cpfbx/OpenNPU-Lite-FPGA/report/evidence/e02.md

# D006-2 K-major 实板验证报告

验证日期：2026-09-20（主机执行记录）  
板卡：PYNQ-Z2 / `ftdi-1234-tulB`  
镜像：`pynq-z2-v3.1.1`  
BIT SHA-256：`a2c87f4599cdc6057e0251c9fb08daa147107166677f6592418499f1287bdc5e`  
Build ID：`0x2026d006`；Capabilities：`0x0008007e`  
硬件源提交：`f9f775aa0195f063624a73743d0af456d63773c0`  
上板软件提交：`70d9ebfe62c5571b5c56ce3a9c00e8b584f53d3b`

## 结论

D006-2 的定义门全部通过，可作为 D006 K-major 稳定候选版本。K-major 不是只在一个固定矩阵上工作的演示：MODE 5（INT32）和 MODE 6（融合 INT8）均经过尾块、随机、512³ 对拍和 30 分钟混合形状长稳。

## 验证结果

| 层级 | 结果 | 证据 |
|---|---:|---|
| RTL 完整回归 | 21 个 testbench，5966/5966 通过 | `sim/logs/`、`sim/run_regression.ps1` |
| Python 单元测试 | 126/126 通过 | `python/test_*.py` |
| Synth 辅助测试 | 4/4 通过 | `synth/test_*.py` |
| MODE 5/6 尾块门 | 各 20/20；独立 row-major oracle 零错 | `board_d006_mode5_tail_20.json`、`board_d006_mode6_tail_20.json` |
| MODE 5 随机门 | 1000/1000，4000 jobs，零错 | `board_d006_mode5_tail_random_1000.json` |
| 512³ 公平 A/B | 20/20，双方零错 | `board_d006_mode3_512_baseline_20seeds.json`、`board_d006_mode5_512_ab_20seeds.json` |
| 60 秒烟测 | 60.030 s，914 cases，零错 | `validation_d006_k_major_soak_60s.json` |
| 30 分钟长稳 | 1800.246 s，32466 cases，零错 | `validation_d006_k_major_soak_30min.json` |
| 120 样本 KWS | baseline/fused 均 107/120；预测变化 0；全部 Tile 精确 | `validation_d006_kws_fused_ab.json` |
| 故障注入恢复 | 错误 `0x07` → 软复位 → 4 Tile 精确 GEMM | `validation_d006_recovery.json` |

30 分钟长稳的 32466 个 case 在 MODE 5/6 间轮换，覆盖 `15×13×17`、`31×16×7`、`64×64×64`、`128×64×128`、`64×128×64`、`127×95×63`、`256×256×64`，并完成两次 `512×512×512` 压力插入。错误、超时、恢复、契约失败均为 0；两个模式的 input stall ratio 均为 0；所有 checkpoint 的 CMA 输入/输出物理地址保持不变；每个 case 的 phase accounting delta 均为 0。

## 性能 A/B

比较条件为同板、同 BIT、同种子、同 `BM/BN/BK=64`、同输入输出字节数和同非接收阶段，仅改变 row-major / K-major 布局：

| 指标 | row-major MODE 3 | K-major MODE 5 | 变化 |
|---|---:|---:|---:|
| 512³ 平均墙钟 | 106.6868 ms | **63.9716 ms** | **1.6677×** |
| 有效吞吐 | 1.2581 GMAC/s | **2.0981 GMAC/s** | +66.8% |
| receive cycles / 矩阵 | 4,790,400 | **530,560** | **9.029× 降低** |
| input/output stall | 0 / 0 | 0 / 0 | 无 stall |

K-major 的 receive phase 从 47.904 ms 降到 5.3056 ms，节省 42.5984 ms；clear、array、store、drain、transition 五个非接收阶段逐周期相同。因此这是一项受控的输入布局/接收路径改进，不把其他微架构变化冒充成收益。把 MODE 5 与旧 legacy MODE 1 比较得到的 2.7368×只作为跨模式参考，不能替代上面的公平 1.6677×主结论。

当前 8×8、100 MHz 阵列峰值为 6.4 GMAC/s（按 1 MAC=1 操作计），K-major 墙钟利用率约 32.8%；PL 计数器吞吐为 2.1294 GMAC/s。这里不宣称功耗、能效或跨板性能。

## 应用兼容性与恢复

同一 D006 BIT 在固定 120 条、12 类平衡 KWS 集上完成 baseline/fused 受控 A/B。两条路径均为 `107/120`（`89.17%`），预测变化为 0，所有 Tile 分别与独立 NumPy 黄金模型精确一致。融合路径把输出流量从 `1,572,480 B` 降至 `397,440 B`（`3.9565×`），输入流量增加 `2.93%`；冻结的 accounted inference 口径从 `8.471 ms/样本` 降至 `6.554 ms/样本`，改善 `22.63%`。该口径明确排除 MFCC、Python 编排、打包和黄金检查，因此不得改写成完整 WAV 端到端提速；融合路径 PL total 周期反而增加 `11.17%`，必须一并披露。

恢复测试向 D006 核注入不支持模式 `0x0`，硬件进入 ERROR、返回预期错误码 `0x07`；软复位后状态回到 IDLE、错误码清零，随后 `15×13×17` 随机 GEMM 的 4 个 Tile 和整矩阵均精确。恢复原始记录与机器裁决分别为 `metrics/board_gemm_d006_recovery.json` 和 `metrics/validation_d006_recovery.json`。

## 资源与时序

完整 overlay 报告：LUT 17935/53200（33.71%）、FF 18702/106400（17.58%）、BRAM 7/140（5.00%）、DSP 72/220（32.73%）；100 MHz setup WNS `+0.010 ns`、hold WHS `+0.029 ns`，无 failing endpoint。

时序余量极小。后续微流水、驻留或更大阵列必须建立独立分支，逐步完成随机正确性和完整实现时序后才可替换；D006 K-major 当前 BIT 保留为可回退候选。

## 证据边界

- 通过结果证明的是一块已识别 PYNQ-Z2、一个已核对 SHA 的 BIT 上的 MODE 5/6 有界稳定性；不证明功耗、热行为、跨板复现或其他平台。
- D006 BIT 上的 KWS 与恢复均已补跑并归档，但尚未完成外置功率计能耗实测、第二块物理板复现和陌生人 clean-clone 复现；这些边界不得用模型推算或旧版本证据替代。
- 板端 RTC 未校时，长稳 JSON 的 `started_utc/finished_utc` 显示为 `2026-09-11`；主机执行目录、下载时间、BIT SHA、board serial、Build ID 和独立校验结果才是本轮身份依据。后续板测应先记录主机 UTC 与板端 UTC 的偏差。

原始 JSON 不删改，机器校验 JSON 与 SHA-256 清单一并提交。审查时应以 `metrics/validation_d006_k_major_performance.json` 和 `metrics/validation_d006_k_major_soak_30min.json` 的 `passed=true` 为门判定依据。

最终总关闭裁决 `metrics/validation_d006_closure.json` 为 `7/7` 门全部通过；它同时核对六份原始板测属于同一物理板、PYNQ 镜像、BIT、Build ID 与 capabilities，并连接性能、长稳、KWS 和恢复四个独立子裁决。该总裁决不扩大各子证据的声明边界。
