cpfbx/OpenNPU-Lite-FPGA/report/evidence/e04.md

# D007-P hold-margin BIT: 20 paired 512³ runs

Status: the paired performance and exactness gate passed; this is **not**
candidate promotion. Recovery, mixed-shape stability and KWS regression remain
separate board gates.

## Immutable evidence identity

- Hardware source commit: `211ed37ec016a8c16a5da97b2882cf90187125cc`.
- BIT SHA-256: `93316244d1d606211459d9fd36d4f59e5a5f5e584e178ab62c9b05fcf4de2aef`.
- Build ID: `0x2026d074`; original-clock routed setup WNS `+0.246 ns`, hold WHS `+0.023 ns`.
- Board: `ftdi-1234-tulB`, image `pynq-z2-v3.1.1`.
- Board JSON: `.board-work/d007_p_margin_board_20260925_raw/board_d007_p_margin_512_20.json`.
- Board/local JSON SHA-256: `1452a69236afef2ef36db105ceec3502046bc661f16335aad47d85bdaf6c0583`.
- Validation JSON: `.board-work/d007_p_margin_board_20260925_raw/validation_d007_p_margin_512_20.json`.

## Same-BIT comparison

Both modes used 20 alternating-order paired `512×512×512` random inputs and
the same BIT. Each output was checked against the independent NumPy oracle.

| Metric | MODE 9 baseline | MODE 10 panel prefetch |
| --- | ---: | ---: |
| Paired DMA+PL mean per matrix | 40.782602 ms | 36.230547 ms |
| PL cycles per matrix | 3,977,664 | 3,518,464 |
| DMA+PL throughput | 3.2911 GMAC/s | 3.7045 GMAC/s |
| Effective MACs across 20 runs | 2,684,354,560 | 2,684,354,560 |
| Load/array work overlap across 20 runs | 0 | 9,076,480 cycles |

Paired mean improvement: `4.552055 ms`, or `1.125641×` speedup. The
candidate saved exactly `459,200 PL cycles/matrix` in this workload. The
machine adjudicator passed all 15 gates, including alternating order,
same work, counter conservation and overlap attribution.

The throughput above uses the paired DMA+PL window. It is neither a KWS
end-to-end speedup nor an energy measurement. The frozen A2 BIT remains the
rollback version until recovery, smoke, 30-minute soak and KWS checks pass on
this exact P BIT.
