cpfbx/OpenNPU-Lite-FPGA/report/evidence/e15.md

# KWS 单次实板非音频原件核对与交接

2026-10-18。人类负责人/唯一实板操作者：bx；本地离线核对：Codex/root。此报告是对 bx 运行原件的本地一致性核对，不是新增独立实现审查、私有音频推理复算或性能晋升。

## 结论

该次工程功能链记录闭合：固定 left、1500..2500 ms、预期 yes；录音实际退出 0，HID 恢复；ARM NativeVad 已进入实板运行路径；一次推理、同输入 CPU/FPGA 记录的 12 个 logits 完全相同；门控拒绝、零虚拟反馈；外层实际 wait 退出 0、进程组消失、规范锁原 inode 释放和终态清理均有一致回执。

分类结果仍是 **yes → off，错误**。这是单次功能诊断，不是识别质量/可部署拒识/连续监听/实板停止注入/能量验收。没有新矩阵数值不一致证据，也不能据此排除共享前处理、模型或录音窗口问题。

## 原件身份与保存

- 输入：`C:/Users/BXstudywork/Downloads/kws_single_no_audio_20261018T140358_768.tar.gz`。
- 本地大小 27,897 B；SHA256 `661ae0fdb33a3de12b72a2d025ded8d7884d3f466aad18132e193df3d8fa2dc2`，核对前后相同。用户未提供板端归档 SHA，**未完成板端与本地的归档散列比较**。
- 23 个普通 JSON/log 成员，无音频；根为 `kws_single_evidence_r_qa2rc2`。归档路径/成员类型/解压预算及 JSON 重复键/非有限值均检查；不执行日志内容。
- 板端证据路径 `/home/xilinx/jupyter_notebooks/kws_single_evidence_r_qa2rc2`；session `43a7bcf595af7b7ebf3e050644529993`。
- 外层包身份 `cfcad342b1f75acc189913a3f2b3f35636a2ebc378f6a3da9cf78fb62220bc26`；内层 `3ba8fff5832cb9a76a05404351af874dfc7da64eb4d67bef54df2a15bcf06a8a`；与本地冻结 release_01 字节清单重新核对一致。package_sha256 字段是包内清单身份，不是外层 ZIP 散列。
- 原始成员逐字节另存 [board_readback_02/raw](board_readback_02/raw)，附 [成员散列清单](board_readback_02/member_manifest.json)、[结构化核对结果](board_readback_02/readback.json)。本地副本不含原音；勿将原音补进公开包。

## 实际复核

58 项选定元数据一致性检查通过。它们不是重新运行需要 WAV 的完整 outer validator。

1. launch/ack/ready/complete 的 session、PID 1986/2012、固定启动 argv、内外层身份与配置 SHA 一致。配置 SHA 为 `ced3f31016ad567a193537b4676e2d173deba4868d719e0a574b850f5445d4ae`。
2. complete 中 thin/lifecycle/monitor 三个 SHA 由归档原始字节重算一致；应用 result 与 thin 内 inference_receipt 对象一致。worker 的 actual_exit=null 不冒称退出证明；外层 actual_exit=0 来源 parent Popen.wait。
3. 录音/转换/截窗/输入 SHA 元数据一致；单次录音 80,000 双声道帧，固定左声道截 16,000 帧。不重新搜索有利窗口。旧字段 manual_selection_seconds 是历史组件字段，不能解释为本次人为事后选窗。
4. 记录的 VAD 50 帧中 49 帧有声，最长连续 43 帧；由 flags 重算聚合一致。这不是原始音频重新 VAD 的结果。
5. 记录的 CPU expected_logits、FPGA logits、pipeline logits 逐值完全相同。模型 SHA `d8fbe41943fe8c350b33b48b420373c0b15ab18c1d0d80d8626b59180c5576b5`。无输入音频，未重新计算 MFCC 或推理；中间 tile 原始 INT32 未提供且 validation_enabled=false，不能称所有中间值独立审计。
6. 用冻结 voice_gate_candidate.py 对**记录的 logits/flags**重算：原始预测 off，score 约 **0.78756959 < 0.95**，唯一拒绝原因 **low_score**，不是 insufficient_voice；动作拒绝、feedback_calls=0、virtual_feedback=[]。softmax 分数不是校准正确率。旧应用 action=虚拟灯关闭只是提议，不是已交付动作。
7. 三层形状 `[49,64,70] / [1,128,128] / [1,12,128]`，237,440 有效 MAC、4 job；用冻结 MODE11 v2 纯标准库合约核对三份记录计数的总周期划分、工作守恒和子集界，均通过。不是新性能实验。
8. lifecycle 报告 cleanup_complete/terminal_verified=true；ID 0x2026D075、capabilities 0x80EFE、error=0、status=5、DMA idle/零错误；monitor joined、callbacks restored。outer 24 项 checks 全真、no stop、零反馈；原锁 dev45826/inode214887。这里只复核记录，未远程重查当前 OS/锁/设备状态。

## 本地校验开发与测试记录

- 新脚本 [readback_no_audio.py](readback_no_audio.py)，只读原归档；输出目录必须不存在，避免覆盖旧结果。
- 首次 audit exit 1：将 Windows/ARM 的 softmax 浮点结果误用完全相等比较，暴露末位差异；失败发生在输出目录创建前，未改原件。未修改原门控/生产验证器/模型 oracle。
- 修正仅针对本地诊断报告：logits 和离散门控字段仍精确比较；两项 score 跨平台重算限 8 binary64 ULP，实际最终各差 `1.1102230246251565e-16`。该口径不用于放宽门限或判断识别正确。
- 第一版 53 检查通过，输出 `board_readback_01` 保留；增补 argv、summary、锁身份、reference 和 workload 后，58 检查通过，输出 `board_readback_02`，实际 exit 0。
- [12 项回归](test_readback_no_audio.py) 最终全部通过，5.669 s，实际 exit 0：含原件、非整数 exit、PID/配置/绑定哈希篡改、重算绑定哈希后的门控原因篡改、反馈/分类通过篡改、重复 JSON 键、NaN、危险归档路径/链接/音频成员及原件未改。
- 可复核命令（仓库根目录，现有 Python 标准库，无新依赖）：

```powershell
python -B -m unittest discover -s .offline-results/KWS-single-shot-board-20261018_01 -p test_readback_no_audio.py -v
python -B .offline-results/KWS-single-shot-board-20261018_01/readback_no_audio.py audit --out .offline-results/KWS-single-shot-board-20261018_01/board_readback_next
```

## 明确保留的边界 / 下一步

- 音频/PCM、原应用哈希 sidecar 未导出；不能本地重新听辨实际发音、重算截窗/MFCC/VAD/模型，不能独立证明硬件物理身份或鉴别所有实板运行事实。现有 JSON SHA 是一致性链，不是签名认证。
- 先前 USB 加载日志归因失败、FAT 未正常卸载警告按 bx 批准原样保留；本包未提供这两类诊断原件，未在本轮另行重验或修复。
- 不重复录音、不换窗、不放宽门限、不重载模块、不做连续监听。停止注入未实测，正式能量仍后置。无需再跑 320。
- 后续可在现有批准离线范围内将该报告加入内部交付索引/答辩事实表，分别列“工程链完成”和“分类/拒识质量未验收”。最终公开白名单、厂商资产许可、默认合并/晋升及新的板测仍由 bx 确认；FPGA-23 异机复现仍属既有负责人，不接管。
- 本轮只有上述本地核对脚本、测试、报告、隔离输出及 current_plan 顶部状态新增；未改冻结源码/驱动/RTL/门限，未提交/推送/发布，未启动板端进程。实际当前板卡状态未读取，是否关机由 bx 决定。
