cpfbx/OpenNPU-Lite-FPGA/report/evidence/e27.md

# E27 研发协作案例与纠错记录

团队将需求、代码实现、测试和结果判断组织为迭代流程，编程模型辅助形成候选代码与分析结果。以下按技术任务、初步方案、审查修订与验证结果记录代表性案例。

## DMA身份检查

任务要求是根据BIT/HWH准确识别AXI DMA，并检查输入资产与调用接口。早期候选使用实例名辅助判断，实例名为axi_dma_fake、声明为not_a_dma的反例暴露误判。团队结合审查结果确定修订范围，模型辅助改为精确MODTYPE/VLNV匹配，并补充HWH-only、CLI参数和路径反例。后续Linux运行90个测试方法，0跳过通过。

## 测试断言修订

一次Linux回归中，程序已正确拒绝软链接，而旧测试仍依赖异常消息中的特定英文词。团队核对源码、退出结果与测试日志，将修订集中于断言和相邻边界，保留原失败作为回归依据。

## 性能分析修订

阶段分析需要区分外层互斥区间与嵌套的传输等待。团队复核计时起止点，确认transfer/wait已包含在chain_total内，随后的图表采用外层阶段加残差呈现，DMA+PL单列为内部细节。该修订保持实测数值不变，避免重复归因。

## Skill形成与验证

团队将精确IP身份、先核原始点积以及明确测量边界提炼为可复用Skill。模型辅助整理检查器与正反例；团队通过审查、程序回归及异机使用评阅检验方法的作用范围。Linux程序验证90个方法且0跳过，另一电脑完成十个既有合成案例，按事前40项标准评阅为40/40，两类结果分别描述程序行为和使用过程。
