cpfbx/OpenNPU-Lite-FPGA/report/evidence/e28.md

# Competition requirements and reference-project study

Research date: 2026-10-20. This report records observations and proposals, not promotion, submission approval or a replacement measurement contract.

## 1. Which competition document applies

The local current source is:

`local_assets/references/downloads/全国大学生嵌入式芯片与系统设计竞赛'2026FPGA赛道选题指南-AMD.pdf`

- 950,952 bytes; SHA256 `c6ad82acd4f7bdcd13bd412e232ed85d05f2a87dd5e2cdd04f9d219f88b569fc`.
- 28 physical pages. Autonomous-topic requirements were read on physical pages 22-25 (printed 19-22), plus the final general instructions on physical page 28.
- `ref/4357c69f4509432c96cddbe5c25d646b.pdf` is the **2025** guide, not the current rule source. It remains historical material; no deletion or replacement was made.
- Third-party online copies are discovery aids, not authority where wording differs from the provided 2026 PDF.

### Formal requirements and recommendations

| Area | What the 2026 guide says | Practical consequence |
| --- | --- | --- |
| Scoring, 3.3.5.5 | Innovation/application 30; performance/resources 20; correctness/completeness 20; LLM collaboration/Skill 15; documentation/reproduction 15 | Do not reduce the entire entry to one throughput number; equally, documentation cannot erase a losing system metric. |
| Engineering, 3.3.5.1 | Sources, verification, synthesis/implementation reports, board runner and actual outputs/reference comparison, reproducible build scripts | Map each requirement to a real file and an execution level. |
| Skill, 3.3.5.2 | `skill/` and usage documentation; applicability, failure conditions, verified effect and origin in failures/observations; reusable by another team | Existing synthetic usage evidence must be described as such, not as cross-board validation or a controlled efficacy experiment. General PYNQ applicability is separately valued, without a numerical bonus specified here. |
| Report, 3.3.5.3 | Problem/prior work; block diagrams; PS/PL partition and interfaces; optimization comparisons; LLM prompts/responses/corrections; Skill derivation; from-zero instructions | The report needs an engineering explanation and figures, not only an audit chronology. |
| Tooling / openness, 3.3.3-3.3.4 | Vivado/Vitis 2026.1 preferred, 2025.2 also mentioned; other versions allowed with reproducibility explanation. Open repository and redistributable licensing strongly requested | Record actual tested versions; do not upgrade a frozen build just to change a version label. Separate license-pending assets. |
| Paths, 3.3.5.4 | Literal naming rule: English lowercase letters, digits, underscores or hyphens; no Chinese or spaces. Directory layout itself is recommended, with a mapping required for alternatives | A directory mapping does not waive the naming rule. The text also exemplifies `README.md`, creating a canonical-uppercase ambiguity to clarify before final export; do not rename frozen evidence or `SKILL.md` blindly. |
| Finals | One-page English PPT poster using the official template, without team information, A4 color print | Prepare later from the actual template; the template itself was not obtained in this study. |

The guide has junior/senior grouping rules. Actual team eligibility/registration group was not confirmed here; it must not be inferred from the board model.

Schedule cross-check: a [Xi'an Jiaotong University notice](https://dice.xjtu.edu.cn/info/1009/3646.htm), dated 2026-09-15, relays submission **2026-11-04 18:00**, finals November 20-22. This is a university relay of the contest announcement, not proof that the submission portal has no later updates. The guide itself defers schedule and latest detailed scoring to the organizer.

**Interpretation, not an extra rule:** the guide does not specify universal victory over the fastest CPU as a qualification gate. It does require actual engineering, meaningful comparisons and reproducibility. Our end-to-end/energy losses must therefore remain visible and explained, not relabeled away.

## 2. Reference selection and identity

These are purposeful references, not a popularity ranking or an exhaustive list of winners. Public repository content was inspected without cloning/building/running it. Current snapshots postdate the award years; current README/script content is not authenticated as the exact award-time submission.

| Project / snapshot | Award evidence | What was actually inspected |
| --- | --- | --- |
| [Ultra-Vision](https://github.com/Floatkyun/Ultra-Vision), `9b3f664d2f9df09b945adcd36c6ca69e09025820` | [Nanjing University notice](https://eelab.nju.edu.cn/xwgg/xwdt/20241219/i306006.html) confirms the named team's Ti60F225 video-scaling project and Efinix enterprise cup in 2024. README also claims national first prize. | README architecture explanations, two buffering/dataflow designs, metrics, demonstration and diagram entry points. |
| [FPGA-ANLU-National-First-Prize](https://github.com/maojinxiang/FPGA-ANLU-National-First-Prize), `df3b509b201a8f4103114d7dc8d78dd16193b10b` | [China University of Petroleum (East China) notice](https://ocean.upc.edu.cn/2025/1215/c15097a479949/page.htm) matches the author/team, Ethernet transmission topic and 2025 national first prize. | README staged integration and operational instructions; selected Python host receiver implementation. No technical-report/PPT content was read. |
| [hlstrack2025_40562](https://github.com/hongpengWu/hlstrack2025_40562), `264bb94cab8b7e10d7874b9b91d28b50f730d8c1` | National first prize is **author-reported in README**; independent award-list matching was not obtained in this study. | PYNQ-Z2 project README, YOLO/UKF subsystem documentation, HLS Tcl and selected C++ testbench. Notebook presence was checked, not executed or fully audited. |

Repository commit identities were read from the GitHub API. They identify source snapshots, not the validity of reported benchmark results.

## 3. Useful practices, and their limits

### 3.1 Ultra-Vision: explain data movement before listing optimizations

Its two designs retain the algorithm but change DDR/FIFO placement and output buffering. The README explains the bandwidth/timing conflict and frame-size synchronization tradeoff, rather than treating ping-pong buffering as an automatic improvement. It also puts architecture, hardware photos and demonstration entry points near the front. [Repository explanation](https://github.com/Floatkyun/Ultra-Vision/blob/9b3f664d2f9df09b945adcd36c6ca69e09025820/README.md).

For OpenNPU: explain why K-major layout, first-K overwrite, prefetch and dual C-Bank overlap remove specific work or stalls; then show measured results for the corresponding BIT identity. Do not add historical savings or multiply their speedups. For host optimization, investigate actual packing/copy/object work before proposing another DMA batching layer that already exists. Do not adopt the reference project's qualitative latency claims as an independently verified metric.

### 3.2 ANLU: build a demonstrable system in stages

The repository exposes incremental control/data/image integration, setup assumptions and an explicit host-side receive path. The selected receiver uses frame/packet identifiers, bounded queuing and stale partial-frame handling. These are concrete integration mechanisms, not proof of general packet-loss tolerance or real-time guarantees. [Project and host source](https://github.com/maojinxiang/FPGA-ANLU-National-First-Prize/tree/df3b509b201a8f4103114d7dc8d78dd16193b10b).

For OpenNPU: a short entry point should show the input identity, selected backend, exact comparison, timing scope and final cleanup/status. Reuse current receipts and logs; no new GUI platform is justified merely for presentation. Demonstrate the matrix service first. Present KWS as a scoped application integration/rejection example unless further approved evidence changes that boundary.

### 3.3 PYNQ-Z2 UKF: connect the kernel to an application, and audit the instructions

The project separates software and hardware notebook routes and includes a MATLAB-reference comparison and scripted HLS flow. This is useful for explaining what PS does, what PL does, and which reproduction route needs a board/toolchain. Its numerical tolerances are application-specific and must not replace our exact INT32 oracle.

There is also a reproducibility warning at the pinned snapshot: README text describes default `CSIM=1`, `CSYNTH=0`, `COSIM=0`, whereas the actual Tcl starts with all of `CSIM`, `CSYNTH`, `COSIM`, `VIVADO_SYN`, `VIVADO_IMPL` set to 1. See the [README](https://github.com/hongpengWu/hlstrack2025_40562/blob/264bb94cab8b7e10d7874b9b91d28b50f730d8c1/README.md) and [Tcl](https://github.com/hongpengWu/hlstrack2025_40562/blob/264bb94cab8b7e10d7874b9b91d28b50f730d8c1/yolo_ukf_track/src/kernel/run_hls.tcl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). No script was executed here. An award claim does not remove the need to verify actual execution flags.

### Reuse restrictions

Ultra-Vision reports MIT and the UKF repository Apache-2.0, with third-party attributions also requiring attention. No explicit root license was found for the ANLU repository in this inspection (GitHub API license was null); this is an unresolved reuse boundary, not permission to copy. No third-party code, image or poster was imported into OpenNPU. Ideas can inform our independently produced explanation, with attribution.

## 4. Recommendations for our next steps

These are proposed priorities, not authorization for new board work or publication.

1. **Finish the real matrix off-machine reproduction handoff first.** V's separate-computer AI-assisted Skill exercise is useful usage evidence, but is not the matrix package's 191-test reproduction. Keep the two records separate. Provide fixed hashes, environment requirements, commands, exit-code collection and a post-test identity check. Separate PC verification, source rebuild, board functionality and controlled measurement as four different levels.
2. **Make the contribution legible.** Present a reproducible INT8 compute platform, measured dataflow/host tradeoffs and reusable validation practices. The core claim is not a universally faster/lower-energy replacement for dual-core ARM. Retain the bounded source-diagnostic window rather than launching an unproved rewrite.
3. **Produce a small set of evidence-backed figures.** PS/PL dataflow and interface; hardware evolution with distinct BIT identities; a nested timing diagram with unassigned overhead retained; same-session backend comparison; nominal ABBA envelope power/time/energy. A DMA+PL subwindow must not be added twice or compared with a CPU complete request as an end-to-end speedup.
4. **Make the demo short and truthful.** Existing golden inputs, exact outputs, conservation counters and lifecycle status are the primary engineering demonstration. The one live KWS misclassification rejected by the gate is one rejection case, not successful classification or a deployment-quality evaluation. No extra run or relaxed threshold is implied by this proposal.
5. **Create a derived submission tree only after decisions.** Map guide requirements to the final source/build/board/data/skill/report material; distinguish current candidates from frozen historical packages. Resolve naming, third-party/IP/model licensing, private-path redaction and the real poster template before public export. Preserve all frozen originals.

## 5. Current gaps this study does not close

- No independent performance reproduction of these reference repositories, no exhaustive review and no causal proof of why judges awarded them.
- No confirmation of our registration group, latest submission-portal changes or canonical-uppercase filename exception.
- No new matrix optimization result, calibrated task-energy result, KWS accuracy improvement, cross-board Skill reuse or matrix off-machine test receipt.
- No change to the measured conclusion: our FPGA saved-envelope mean power was lower than ARM 2t, but its measured nominal envelope duration and cumulative joules were higher. This is not repaired by changing presentation.
- No score or award guarantee. The useful lesson is to pair a focused engineering contribution with understandable architecture, real comparisons and an executable reproduction path.

## 6. Read-only verification and handoff

The 2026 guide's submission and scoring pages were rendered and visually checked. Public award notices, current repository identities and selected source boundaries were checked. Existing tracked modifications were not edited. Only this research directory and isolated PDF render images were added; no board, build, installation, Git commit/push or external coordination occurred.

Recommended immediate continuation: prepare the matrix off-machine reproduction handoff for the participant, then apply these findings to the report/figure plan. No further repository browsing is needed before that handoff.
