cpfbx/OpenNPU-Lite-FPGA/report/figures/fig01_architecture.pdf

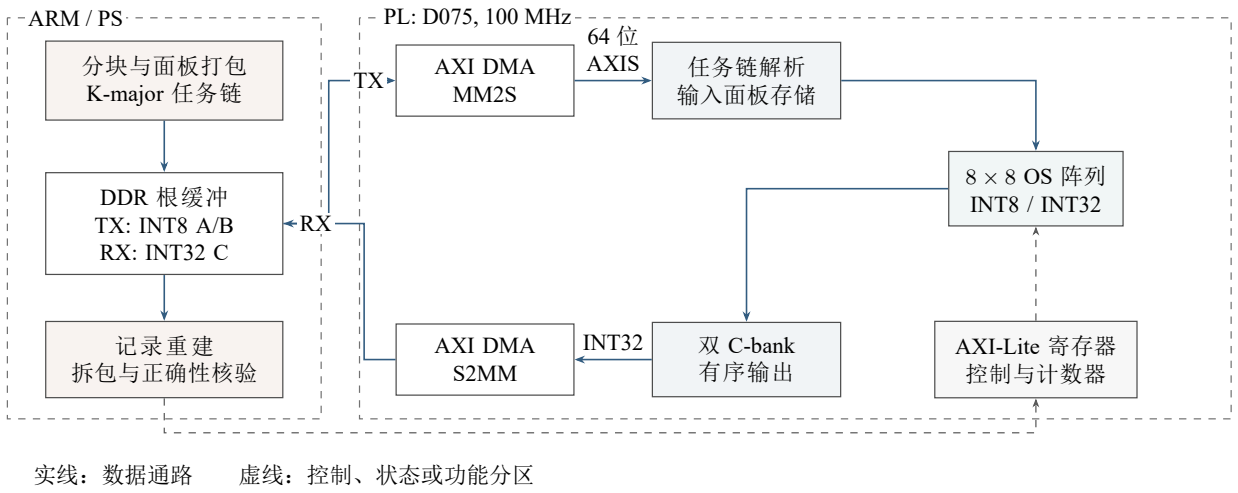
[picture p20: figure]
ARM / PS; PL: D075, 100 MHz; 分块与面板打包 K-major 任务链; DDR 根缓冲 TX: INT8 A/B RX: INT32 C; 记录重建 拆包与正确性核验; AXI DMA MM2S; 任务链解析 输入面板存储; 8 × 8 OS 阵列 INT8 / INT32; 双 C-bank 有序输出; AXI DMA S2MM; AXI-Lite 寄存器 控制与计数器; 64 位 AXIS; INT32; 实线：数据通路; 虚线：控制、状态或功能分区
