cpfbx/OpenNPU-Lite-FPGA/report/figures/fig08_kws_graph.pdf

(a) 完整计算图：本轮 PC 离线固定 12 窗

公共 WAV 前端
CPU Op0–Op1

共享中段接口
Op2 → DW3 → Op4

CPU Op5–Op11
12 个 INT8 logits
X23 | X26
(b) 另一组 ARM/PL 实板固定 12 窗：单个共享资源会话

ARM 后处理：零点校正与重定量化；X23..26 均为 1 × 25 × 5 × 64 INT8.

24 次 Pointwise 调用、48 个 job、12 次 ARM DW3；后层消费前层实际输出。

(c) 完整 PC 图的 CPU 后缀与决策

DW：逐通道卷积；PW：逐点卷积；FC：全连接。候选止于 Op11，未执行 Op12 Softmax。
