cpfbx/OpenNPU-Lite-FPGA/sim/readme.md

# RTL仿真入口

源码及执行脚本位于d075/；环境与重放步骤见根目录reproduction_guide.md。

## 先查看现有结果

[2026-10-30原生仿真日志、退出码与波形数据库](results/native_20261030/readme.md)。在运行回归前，可直接核对原有结果。
