cpfbx/OpenNPU-Lite-FPGA/report/evidence/readme.md

# 技术证据导航

E01–E43及同编号补充文件是各阶段保留的技术记录。文件中的历史时间、失败、负结果和版本说明保持原样。部分原文相对链接指向当时工作目录；它们用于定位历史上下文，当前公开工程请从下表进入。

| 查什么 | 当前入口 |
|---|---|
| 按阶段理解全部成果 | [研发结果总览](../development_results.md) |
| E编号与来源文件身份 | [技术来源索引](../technical_source_index.csv) |
| 原始资源、时序与完整构建 | [构建目录](../../build/readme.md) |
| 实际BIT/HWH、矩阵及共享链返回原件 | [板端目录](../../board/readme.md)、[资产尺寸及SHA](../../provenance/delivery_artifacts.json) |
| 本次公开运行截图 | [E42](e42.md)、[帧来源索引](../run_source_index.json) |
| 完整图离线执行与模型输入 | [复现指南](../../reproduction_guide.md)、[数据目录](../../data) |
| 提示词、模型答复与纠错 | [技术交互](../collaboration_interactions.md) |
| 完整设计报告 | [设计报告](../design_report.pdf) |

公开工程并未包含历史工作树的每个临时目录。来源索引列明出处，不表示原文中每个历史相对路径都已成为当前仓库附件。随附运行包、原件和当前入口由工程根manifest统一核验；完整历史资料仍按原版本保全。
