cpfbx/OpenNPU-Lite-FPGA/report/native_assets/readme.md

# 原生工程图件

本目录保留报告使用的Vivado原生截图与原生SVG/PDF。正文裁切用于排版，原图文件保留完整。仿真WDB、测试台与复现入口随配套工程提供。PE乘法器连接局部采用完整矢量文件供放大查看。
