cpfbx/OpenNPU-Lite-FPGA/report/evidence/e01.md

# 第1项工程签核补齐：执行记录

负责人bx；执行Codex /root。用户本轮决定保留第2项进度，先完成第1项。
不改RTL/XDC/协议/门限/生产默认，不部署新BIT，不操作板子，不提交或推送。
第2项293.226ms矩阵候选及全部原件保持不动，暂停追加性能实验。

## 最新状态：第1项工程核查与干净重建已完成

2026-10-13 14:34:33（北京时间）：原构建脚本完整综合/放置/布线/布线后优化/写BIT/导出XSA-HWH/finalizer结束，执行器session36546实际退出0。耗时20分46.76秒。
此前下方“进行中/尚待完成”为过程检查点；最终结果以本节和completed_audit_04.json为准。

| 本次验收对象 | 最终事实 |
|---|---|
| 冻结源码与依赖 | 独立干净clone，47输入字节相同；原板卡ZIP SHA验证通过，新venv，不复用旧IP/DCP构建输出 |
| 工程与检查点加载 | 原xpr实际read-only打开，原最终DCP副本实际加载；原xpr及DCP/BIT未改 |
| 物理架构 | 网表一份shared/tile/PE阵列；64PE DSP＋7量化DSP＋1计数DSP=72 |
| 新完整实现自然时序 | WNS+0.118ns/TNS0，WHS+0.066ns/THS0；setup/hold/pulse失败端点0，12类check_timing全0 |
| 新时序/资源报表 | 去除前12行工具/日期/路径头后，正文与历史报表逐行完全相同；LUT26762、FF27575、BRAM11、DSP72 |
| 新BIT | 整文件SHA不同，仅头c/d日期与时间不同；配置载荷4,045,564B与历史逐字节一致 |
| 新HWH/XSA | HWH仅根TIMESTAMP变化，全部其余XML相同；新XSA内BIT配置与导出BIT一致 |
| 方法学核查 | 152 TIMING-46全部逐路径验证10ns setup/0ns hold；报告保留2865方法学/204DRC条目，不豁免、不改成零告警 |
| 生产与板卡 | 未部署新BIT，不改原默认，无本轮板测/OS/权限/网络操作；第2项包与原件SHA复核不变 |

这是现有PYNQ PL overlay的工程交付核查/重建完成，不是新硬件晋升、DDR电气/启动镜像签核或全工作流零Critical Warning。
构建日志仍有PSU-1/2/3/4四类DDR负值Critical Warning，各出现3次。值-0.051/-0.006/-0.009/-0.033与固定厂商preset及历史BD/HWH一致；原样保留，不擅改PS参数，不宣称因此证明任意DDR/FSBL/BOOT用途安全。
历史DRC中4条DMA IP WRITE_FIRST RAM Advisory也明确保留。本轮没有新增设计、没有接受新的性能退化，不为清零告警改RTL或IP。

核心产物身份：

- 新BIT SHA d913b3b3fe676c49ac432131b1ef285e8b1cf8724d6eaeab30d2bfafc5ebeb11；原板测BIT仍47ae0a3640ef6d31db467118fd1822c04d465cd31171275fc04824824a20451c。
- 二者配置载荷SHA f9b9c1e63d735d66df3f43d15f3e2202c11568a54277ef0b23ea1213c9440361。
- 新postroute DCP SHA b59acdc06e2ea4c852201e528c83b251343058531b00fdcd667ffa7efadd5e3d。
- 新artifact identity SHA f360ab234cda54dc8e2f1e93eaf933ad52b8fdabeba4c981d3af2577469061af，关联47输入身份与六产物；completed_audit_04另绑定DCP/XPR，未倒填历史DCP身份。
- actual executor exit0依据本聊天tools.write_stdin真实返回；executor_completion_metadata_excerpt.json保存metadata摘录，明确非服务签名/非完整stdout。build_completed.json中的planned码不单独充当实际退出证明。
- 最终11项审计专项测试exit0，0failure/error/skip，audit_tests_06.log；此前失败和旧JSON不覆盖。最终审计对BIT配置和HWH时间戳替换使用实际bytes比较，而不只比较SHA。

独立审查：/root/matrix_attribution_increment_review已只读审查并复算通过，未参与实现、未操作Vivado/板或改原件。其独立核查47输入、旧产物、DCP、BIT/HWH/XSA差异、报告正文、152条DESCRIPTION与TSV端点、DSP64+7+1、自然时序及11测试，结论为本范围无新增阻塞，可收尾“冻结矩阵overlay工程可重建/自然时序闭合/告警分类”。actualexit证据为主会话真实工具metadata转录和成功日志交叉佐证，不冒充审查者直接捕获原OS退出。审查复算的03与最终04 JSON逐字节相同，SHA b13aaec078059ddc0edf58c43efdc43b88a8f8b4901d503b17c8a788152d3af9。

新可打开工程：
`D:/Work/CodexProjects/Active/fpga/.board-work/matrix-signoff-rebuild-20261013/.board-work/full_overlay/vivado_gemm_accelerator/opennpu_gemm_accelerator.xpr`

干净重建方法已实际验证：全新clone指定35d4db6，准备stdlib Python venv和固定SHA板卡定义，使用原`synth/run_gemm_overlay_build.ps1 -ArraySize 8 -Mode11Experiment`。`OPENNPU_BUILD_OUTPUT_ROOT`必须为该clone内不存在的新目录；原Tcl含create_project -force，绝不能指向当前或历史已完成目录。当前run_clean_rebuild.ps1单次claim防止误重跑；不要删claim绕过。
GitHub迁移快照与历史对象不同的既有边界不变：本次复现为本地新clone指定历史commit，不冒充其他电脑已从新GitHub仓库复现；团队第三方复现归第5项。

下一步：第2项进度继续保留为诊断候选；是否恢复多输入/多形状正式性能合同由bx决定。本轮不自动追加板测、提交/推送或更改Linear状态。

## 历史过程检查点（以下进行中状态已被上述最终结果取代）

证据根：D:/Work/CodexProjects/Active/fpga/.offline-results/matrix-signoff-20261013_01/。
新干净clone：D:/Work/CodexProjects/Active/fpga/.board-work/matrix-signoff-rebuild-20261013/。
分支codex/matrix-signoff-rebuild-20261013，commit35d4db623091dfc7a63459d07f04e4484dbbd999；47份冻结输入逐字节一致，git status clean。
新Python venv仅供stdlib构建finalizer使用，未安装推理依赖；固定SHA板卡ZIP复制后由原fetch脚本验证并解压，没有借用旧生成IP或构建输出。
运行原synth/run_gemm_overlay_build.ps1 -ArraySize 8 -Mode11Experiment，输出新clone的.board-work/full_overlay。原47输入未改，原4并行job策略未改。
父执行器session36546，Vivado主进程130784；状态以build_completed.json、实际executor退出及日志为准，不凭此静态记录推断完成。

## 已完成的实际工具核查

Vivado MCP会话vivado-20261013-140730-3cf0e78e，以Tcl模式启动；历史xpr通过open_project -read_only成功打开，报告了原完成的synth/impl runs。
只读项目中IP显示read-only锁定；module reference显示unresolved，不能据此声称原工程可编辑后直接重建。没有升级IP或保存原项目；新clone重新构造BD已validate通过并进入综合，由完整重建实际验证。
历史DCP按SHA核验后复制到新证据目录，再实际open_checkpoint成功。操作只在会话内存，未write_checkpoint或回写旧DCP。
检查会话已正常停止，完整重建期间不同时保留第二个Vivado审查进程。

网表层级确认：一份shared core、一份axis_tile_gemm_core、一份PE_array；72个DSP中64用于PE阵列、7用于requantize、1用于effective_macs工作计数。不是两套物理阵列。
自然时序重新生成：WNS+0.118/TNS0，WHS+0.066/THS0；setup/hold/pulse失败端点0，12类check_timing均0。
152条TIMING-46逐条绑定实际violation的pin对象并查询max/min路径；全部setup requirement10ns、hold0ns，最小setup slack5.646ns、最小hold slack0.122ns。
自然约束仍按冻结构建同一零hold关系命令恢复；152条工具告警未删除/豁免，不声称方法学零告警，也未修改XDC。

## 保留告警与边界

方法学：DPIR-1=2709（异步复位阻止DSP内部寄存器合并的优化提示）、TIMING-46=152（上述逐路径验证）、RTGT-1=4（bias RAM重映射优化提示）。
DRC：DPIP-1=63、DPOP-1=67、DPOP-2=70，均是DSP流水优化Warning；REQP-165=2与REQP-181=2均为Advisory，全部位于AMD AXI DMA IP内部FIFO的WRITE_FIRST RAM。
本次DRC/methodology报告没有Error/Critical Warning。RAM Advisory仍保留，不假装新增仿真已证明所有地址冲突不可能；不为提示而修改已验证IP/复位/流水语义。
AMD TIMING-46说明要求核对路径实际行为与约束，本次以全部152对实查值补证，不以一个例子泛化：[UG906](https://docs.amd.com/r/en-US/ug906-vivado-design-analysis/TIMING-46-Multicycle-Path-with-Tied-CE-Pins)。

## 新审计工具及验证

只读scripts/audit_matrix_signoff_completion.py：解析全部2865方法学条目与204DRC条目，核对报告总数、152对覆盖、网表计数、输入与构建产物身份；无waiver或生产门限修改。
8项反例/实际原件测试最终exit0，audit_tests_02.log。首次audit_tests_01的1项失败为Windows路径反例注入器只匹配斜线，已修正测试匹配，保留失败日志；未改实际工程输入。
首次historical聚合审计错误假设剩余8个DSP全属量化，已按逐cell网表修为7量化+1工作计数；是审计器推测错误，不是硬件变化。最终historical_audit_02.json成功，未覆盖旧报告。

## 尚待完成

完整干净综合/布局/布线/写BIT与finalizer；核对新自然时序、资源、产物与历史身份。新BIT未通过本轮板测，不能自动替换历史板测BIT。
构建开始曾出现本机物理/虚拟内存余量低，已告知bx且没有关闭他人程序或修改OS；随后余量回升。失败时保留原件，不降低时序门限。
审计source脚本与新文档尚未提交，不自动更新Linear或合并。
