cpfbx/OpenNPU-Lite-FPGA/report/evidence/e05.md

# D075/MODE11 本轮板测收尾与跨 BIT 回归裁决

## 结论

**本轮计划中的板测已全部完成，原始证据已取回并独立复算。** 新完成 D074/D075
跨 BIT 的 GEMM 与普通/融合 KWS；此前 MODE11 预检、随机、恢复、烟测、30 分钟
混合长稳、旧模式兼容和无重载直切均有独立报告，不重复跑。当前没有安排新的长稳。

23 项本地身份/计数/配对一致性检查通过，**不等于“所有性能无退化”或自动晋升**。
保留冻结 D074 稳定版；D075 已具备本轮完整板测证据，等待独立晋升审查和团队对
下述小幅旧路径差异的裁决。未创建晋升 tag，未替换稳定 BIT。

## 1. 超时处置与执行边界

v1 外层看门狗 300 秒在第 9/16 个 GEMM 子运行中止。原前 8 个尾块 JSON/日志、
第 9 项空日志和父日志完整保留，没有与新场次拼接。stdout 缓冲使旧失败子日志为空，
因此不能断言被中止时具体停在哪一行，也不能仅凭异常排除所有独立故障。
冻结 D074 以往同规模 20 次整段耗时 558 秒，足以证明 300 秒交付阈值不合理。

v2 源 `880f61d`：仅将**整段子任务**看门狗改为 1800 秒、子 Python 加 `-u`，并
保存超时失败旁路。**单次 DMA 超时仍为 60 秒**。未改变硬件、冻结应用、黄金模型、
种子、20 次迭代、ABBA 次序或性能窗口。224 项 Python 测试通过。

用户明确授权“继续完成所有测试”后，通过既有 root Jupyter Terminal 启动隔离 v2
场次，GEMM 成功才进入 KWS；未修改 sudo 策略、密钥、校园网络/Clash。
新目录只为本次监测可读，没有改旧 root 私有证据目录的权限。

- 板端目录：`/home/xilinx/jupyter_notebooks/mode11_crossbit_v2_auto_aGYlB4/`
- 开始/结束：`2026-09-30T13:23:49Z` / `2026-09-30T14:46:49Z`，约 83 分钟。
- GEMM、KWS、session 退出码均 0，32 个子运行全部完成，无子任务失败旁路。
- 83 分钟含 ARM 打包、NumPy oracle 等测试成本，**不是单矩阵加速器延迟**。

## 2. 身份与归档

| 对象 | 固定身份 |
| --- | --- |
| 板卡 / 镜像 | `ftdi-1234-tulB` / `pynq-z2-v3.1.1` |
| 冻结 D074 硬件源 | `211ed37ec016a8c16a5da97b2882cf90187125cc` |
| D074 BIT | `93316244d1d606211459d9fd36d4f59e5a5f5e584e178ab62c9b05fcf4de2aef` |
| 候选 D075 硬件源 | `35d4db623091dfc7a63459d07f04e4484dbbd999` |
| D075 BIT | `47ae0a3640ef6d31db467118fd1822c04d465cd31171275fc04824824a20451c` |
| 两 BIT 共用冻结 host app | `c0ca40fed408a1e84b137bcd7690538c91f568a5` |
| v2 补充 ZIP | `d0d689ec62c66e20f254b70017bb016bca91e4651eb27ce7e74cae8313e2cd4a` |
| 成功原始 tar | `1a08c48279151ad9c1158c2b9f3f7e2715eb3607feb9cc0713a0d208194e8919` |
| 中止 v1 原始 tar | `aeee9de78a85ad2c7d81d1dfa26484ea7f5423ec81722bcfbad375c49a759760` |

两份 tar、启动快照/脚本、本地复算及复算入口均在
`metrics/mode11_crossbit_20260930/`。成功 tar 从板端取回后 SHA 完全一致，成员路径/
类型检查通过后在 `.board-work/mode11_crossbit_20260930_raw/` 独立展开。
复算另外检查 HWH、模型/manifest、交付脚本与包身份、板卡/镜像、原始子 JSON/日志 SHA。
SHA/校验器提供一致性与外部固定输入约束，不是数字签名或“防伪证明”。

## 3. 完成工作量与正确性

| 项目 | 本轮数量 |
| --- | ---: |
| GEMM 子运行 | 16（每段内部 20 个 MODE9/10 配对） |
| GEMM 内部配对 / chain 执行 | 320 / 640 |
| GEMM tile / 有效 MAC | 21,760 / 42,953,728,960 |
| KWS 子运行 | 16（普通/融合、两 BIT、ABBA 两轮） |
| KWS 样本执行 / tile | 1,920 / 7,680 |
| KWS 有效 MAC | 455,884,800 |
| KWS 唯一样本 / 每次正确数 | 120 / 107 |
| 离线身份、计数、配对审计 | 23/23 |

每次 KWS 均 107/120，16 场的逐样本身份/预测与冻结 D074 完全一致；没有新增
硬件分类错误。1920 是同 120 样本的重复执行，不能增加泛化准确率的样本量。
GEMM 应用在板端作 NumPy 精确比对后才保存成功；本次跨 BIT JSON 不保存 GEMM
完整输出 payload，离线只能重算身份/字节/MAC/计数与应用成功记录，不能声称重新
从 payload 对全部 GEMM 算术作独立重演。此前 81 步直切门单独保存了完整输出。

## 4. 跨 BIT 旧路径性能（同 host、同日 ABBA）

GEMM 比较两 BIT 内的**旧 MODE10**，不是 D074 MODE10 对 D075 MODE11。
每组 4 对外层子运行均值，20 次内部 GEMM 或 120 个 KWS 样本不是独立跨 BIT 配对。
GEMM 窗口为 DMA+PL；KWS 窗口为含 oracle 的 validated inference，排除 MFCC/Overlay
加载，不是裸硬件计算或含特征提取的端到端应用。

| 工作负载 | D074 均值 ms | D075 均值 ms | 配对差值 D075−D074 ms |
| --- | ---: | ---: | ---: |
| 尾块 `15×13×65` 旧 MODE10 | 0.746852 | 0.705716 | −0.041135 |
| `512³` 旧 MODE10 | 36.129759 | 36.202669 | **+0.072909** |
| 普通 KWS | 31.893699 | 32.115294 | **+0.221595** |
| 融合 KWS | 41.489047 | 41.180121 | −0.308926 |

原摘要的**配对百分比均值**分别约 −5.27%、+0.20%、+0.70%、−0.74%；它不是上述
两列总体均值之比，不能混用。旧 MODE10 大矩阵和普通 KWS 的 4 对墙钟差值均为正，
必须保留，不能直接宣称统计等价或忽略成噪声；尚未预定义等价界或完成因果分解。
融合 KWS 的 4 对中有一对更慢，均值下降也不能推断所有重复运行都会更快。

## 5. 相位归因：能确认什么、不能确认什么

旧 MODE10 的尾块每链 `2039→2043` 周期，大矩阵每链 `3,518,464→3,518,528` 周期。
仅 `transition` 增加，分别对应 4/64 个输出 tile **各多 1 个控制周期**；receive、clear、
array、store、output、输入/输出等待逐周期不变。大矩阵 PL 差为 64 拍（0.64 µs，
约 +0.00182%），不能与墙钟 +0.072909 ms 混为同一机制或声称完全无退化。

普通 KWS 每样本 PL 均值增加 `2526.49375` 拍：receive/input_stall 增加
`2522.49375`，transition 增加 4，其余工作相位不变。input_stall 是 receive 的子集，
**不再相加**。约 +0.025265 ms PL 只解释墙钟 +0.221595 ms 的部分；剩余约
+0.196330 ms 在 PL 窗口外，原因未证实。输入等待增加的具体来源也未证实。

融合 KWS 每样本 PL 均值增加约 `91.785417` 拍（+0.000918 ms），同样为 receive/
input_stall 的约 87.785417 拍与 transition 4 拍，其余工作相位不变。墙钟均值下降
不等于 PL 更快。现有证据不能把差异全部归给 Python、DDR、DMA 或温度中的某一项。

## 6. MODE11 主优化成果与性能口径

MODE11 性能来自**此前同 BIT MODE10/11 的 20 次配对**，不从本次旧路径跨 BIT 摘要
外推：DMA+PL `36.221124→31.261776 ms`，同 BIT 配对加速 `1.158639×`；MODE11
DMA+PL 吞吐 **4.293349 GMAC/s**。纯 PL `3,004,483` 拍、`30.044830 ms`，吞吐
**4.467249 GMAC/s**。两者窗口不同，不能把后者写成墙钟吞吐；均值 4.293 也不应
写成严格“超过 4.3”。20 次中 33.918 ms 的离群墙钟保留，没有挑删。

此前混合长稳 `1800.008108 s / 8302` 对，每模式 36,882 任务、16 对 `512³`，通过；
旧模式兼容/81 步不重载直切通过。D075 完整 100 MHz setup/hold `+0.118/+0.066 ns`，
72 DSP、11 BRAM、26,762 LUT、27,575 FF。仍是单物理核，不能宣称 DSP 减半。

对应报告：

- `docs/d007_mode11_board_preflight_review_2026-09-30.md`
- `docs/d007_mode11_soak_review_2026-09-30.md`
- `docs/d007_mode11_kws_review_2026-09-30.md`
- `docs/d007_mode11_legacy_compat_review_2026-09-30.md`
- `docs/d007_mode11_advanced_compat_and_handoff_2026-09-30.md`
- `docs/d007_mode11_handoff_review_2026-09-30.md`

## 7. 独立审查任务与下一步

1. 离线重放本目录 `review_crossbit.py`，核实 23 门及两包 SHA、身份链、原始记录；
   判断它没有把成功一致性门当作防伪/性能无退化门。
2. 审查跨 BIT ABBA 的配对单位、4 对均值/极差、窗口边界及旧路径 +0.20%/
   普通 KWS +0.70%：是否可接受须明确裁决，不能事后修改阈值为“全通过”。
3. 核查旧路径 `transition +1/tile` 和 KWS receive/input_stall 增量；确认尚未完全归因，
   不用“主优化更快”掩盖旧路径的确定控制开销与实测墙钟差异。
4. 将本轮与此前随机/恢复/长稳/直切/普通融合 KWS 证据缝合，决定 D075 是否晋升。
   当前保留 D074，不自动更改稳定标签或 RTL。
5. 团队提交下一轮建议后，再据冻结证据讨论优化路线。功耗/能耗、ARM 基线属于
   后续独立工作包，本轮没有测量，不能报 GMAC/J 或声称能耗改善。

本轮板测到此收尾：原始证据留板并有本地副本，不删除中止场次，不再追加测试。
该完成范围是当前 MODE11 候选约定的板测门，不是所有未来研究任务已经完成。
