cpfbx/OpenNPU-Lite-FPGA/report/evidence/e06.md

# 第2项：多输入矩阵完整调用确认结果

本轮483调用受控诊断已由bx实板完成，完整原件取回，Codex /root用冻结入口本地独立重放通过。256³及512³完整调用胜过本场ARM NumPy FP32，所有小形状仍由ARM占优。生产默认未改变，未晋升。

负责人/实板操作者：bx；离线实现及原件复算：Codex /root。base `35d4db623091dfc7a63459d07f04e4484dbbd999`，隔离分支 `codex/matrix-delivery-audit-20261012`。源码未提交/推送/合并，属于默认关闭的诊断候选；不冒充生产已部署版本。
用户明确批准483调用范围；本轮Codex未连接、上传、取件或启动板端任务。用户下载后交付本地文件，原件和包只读，不改RTL/BIT/HWH/驱动/协议/oracle/门限/OS/锁。

## 最重要的性能结论

以下全部为已初始化会话中的完整请求均值（ms），包括转换/构造/完整保护/驱动/cache/DMA+PL/计数器/拆包。输入生成、独立INT64核验、证据落盘与会话准备另计。每形状20组不同正式输入，同日同会话三方配对；不是纯PL、DMA+PL、KWS或麦克风端到端成绩。

| M,N,K | ARM FP32 | 原FPGA | 缓存FPGA | 缓存相对ARM |
|---|---:|---:|---:|---|
| 15,13,65 | 0.789 | 7.534 | 7.451 | 0/20更快，ARM胜 |
| 64,64,64 | 2.218 | 8.375 | 8.349 | 0/20更快，ARM胜 |
| 127,95,63 | 4.984 | 14.403 | 12.864 | 0/20更快，ARM胜 |
| 128,64,128 | 5.451 | 12.599 | 11.653 | 0/20更快，ARM胜 |
| 128,128,128 | 9.764 | 19.181 | 15.240 | 0/20更快，ARM胜 |
| 256,256,256 | 60.714 | 98.258 | 52.390 | 20/20更快，1.159× |
| 512,512,512 | 438.780 | 714.535 | 284.216 | 20/20更快，1.544× |

256³相对ARM耗时减少13.7115%；配对均值差−8.324884ms，95% bootstrap区间[−9.071520,−7.410341]ms。
512³相对ARM耗时减少35.2257%；配对均值差−154.563161ms，区间[−159.358070,−149.780475]ms。相对原FPGA耗时减少60.2236%，完整请求提升不是单纯PL跑分。

| 形状 | ARM P95 / max | 缓存FPGA P95 / max |
|---|---:|---:|
| 256³ | 62.588 / 62.846 | 54.810 / 57.314 |
| 512³ | 447.311 / 459.211 | 295.358 / 307.734 |

两个获益测点的均值、P95及最大值均优于本场CPU和原FPGA。20组P95/max只是有限样本描述，不是硬实时保证；按输入配对bootstrap2000次/seed20261013，不能将三个后端当三个独立样本或宣称所有矩阵普遍显著。

64³相对旧FPGA均值差−0.025262ms，区间[−0.117145,+0.042649]ms跨零，P95 8.579499→8.608995ms、max8.622369→8.656560ms均略退步。其余六形状相对旧FPGA配对平均改善区间均低于零且P95/max改善，但前五形状无一胜CPU；不能据此全局替换默认。
只确认已测256³/512³获益，不将256当普遍阈值、不假定形状/规模单调，不自动实现ARM/FPGA分派。

## 改善来源及初始化边界

512³原FPGA→缓存FPGA，20组均值：

- transaction generation：516.809→90.226ms。
- owned submission：140.501→139.246ms。
- record reconstruction：30.135→29.746ms。
- output unpack：19.692→18.769ms。
- DMA+PL：31.018→31.079ms，嵌套在owned submission内，不可再与上述段相加。

主要收益来自请求内A/B面板及不可变布局复用，减少重复构造；不是阵列提频、减少工作量或删检查。DMA+PL没有提速证据，均值还略增约0.061ms，不把主机收益包装成PL性能提升。两路径profile_host均True，无新增探针。
缓存不跨请求持有可变输入，不在计时外预打包。本次会话初始化9.708544995s（锁+driver/Overlay+恢复+根缓冲，排除import）单列；优势适用于初始化后常驻会话，不能把284ms称为一次性全冷启动成本。21次逐形状首次调用与42预热调用均保留，不混入420正式调用。

## 正确性、工作量与退出

483调用、161不同输入组；每后端161调用。7形状每后端20正式配对，正式后端对先后各10/10，位置次数不完全均衡。
322次PL提交、4232job、7,138,076,956MAC；输入wire223,732,224B，输出wire67,824,976B；全局job连续1..4232。冻结replay对每次MODE11状态、工作量、记录及并行计数合同逐项核对，全部通过。
原始输入322份NPY、返回483份NPY、journal/result合计807实验文件；25观察间隔与生命周期/退出等共840会话文件；另安装源码摘要和readback，总842文件。
所有25,434,228个INT32位置从外部冻结seed生成输入并独立INT64重算精确，原始A/B和SHA一致；不采信checked字段替代计算，不删除不利结果。

父进程真实`Popen.wait`记录child PID17668 exit0、无stop signals/pending stop，25个观察间隔没有kill/retry。生命周期记录cleanup_complete/operation_success均true，held/safety_unresolved/lease/runner全部false、根缓冲0、failure_types为空。
这是该次退出记录的核验，不凭它推断板卡此刻仍通电或锁当前仍空闲。未读取当前板态，未关机。

环境原件：ARMv7、Python3.10.4、NumPy1.21.5、内核6.6.10-xilinx-v2024.1-g3c0eca68c652、CPU affinity[0,1]，线程环境变量均未设置；本轮不改配置。NumPy报告系统blas、未显示OpenBLAS/ATLAS/MKL优化库。因此对照是本场较快且数值精确的FP32实现，不是证明ARM最佳可能性能。

## 原件与冻结身份

板包目录：`/home/xilinx/jupyter_notebooks/matrix_confirmation_v1_BZgLoTv4`；证据目录：`matrix_confirmation_evidence_8qnjst2w`，用户回传起始UTC2026-10-13T10:21:19Z。
本地原件：`D:/Work/CodexProjects/Active/fpga/.offline-results/matrix-confirmation-board-20261013_01/originals/matrix_confirmation_evidence_8qnjst2w/`。

- 完整下载实际文件：`C:/Users/BXstudywork/Downloads/matrix_confirmation_originals_20261013T105240_17623 (1).tar.gz`，94,588,143B。
- 完整归档本地SHA：`20d85bcb2000667194d6d899032fe533ed9191a1f1c90eb1eef6494059b81de1`；gzip CRC/EOF通过，848安全成员（842常规文件/6目录，无链接、路径越界或同名覆盖）。用户未另贴板端归档SHA，不冒充双端已独立比对；内含原件与此前单独下载的readback/installed_sources逐字节一致。
- 原无“(1)”的21MiB截断文件仍保留，SHA `1bbeebf5b1b3ba31d49736900a0eeb3b9450c7328930b8c3324b469572c57161`；未删/改成完整包。
- ZIP SHA `cf4694729a96dc6da9ff93ed7a8331eb4a9ca72d0c624f509d57449b782077cd`。
- release SHA `b46097ca5e11c82ccbe5e8c05304383844ffcd6394e93a24bf8e023206cba112`。
- snapshot SHA `1ed61e304527f21742b626cfc5c8a97e59d27082f3315b9da35e1981fd8bf51b`。
- 原BIT仍 `47ae0a3640ef6d31db467118fd1822c04d465cd31171275fc04824824a20451c`，未部署第1项新重建BIT。
- 原始calls.jsonl SHA `8c5d46db191bec1e69f9359f73f4febad5980611e98c85209eae11bb59e22b13`。

冻结release_03的`matrix_confirmation_release.py replay`实际exit0，日志 `pc_board_replay_01.log`。输出 `pc_board_readback_01.json` 与原件readback.json逐字节相同，SHA均为 `c2473c4b1960d17ef69cec4c6af5d5a70a675c33551aa06e2b421171ad322c50`；独立数值/统计、807实验SHA、840会话SHA及身份/退出/清理一致，复算前后原件清单未变。
实际只做本地重放，没有重新运行板测、性能采样或改验证器；此前364项回归不虚写成本轮重跑。

## 审查与剩余边界

发布包核心与增量已由独立子agent审查通过（见发布交接）。本次原件独立第二执行者 `/root/matrix_cost_increment_review` 也已实际复核通过，未参与实现、未写文件或连接板：冻结03入口内存readback的483/161/25,434,228精确、actualexit/cleanup/SHA均一致；另直接从calls独立统计七形状每后端20不同输入、次序各10/10、mean/P50/P95/max及2000次bootstrap区间，全部与readback相同。其独立核对归档SHA/大小，842文件前后清单不变；明确确认大矩阵获益和64³退步，不批准全尺寸晋升。首次capacity失败没有检查结果，重试实际exit0完成后才形成上述结论，不抹去过程失败。
board_evidence/physical_identity_authenticated/performance_gate_evaluated/promotion仍false；安装源码摘要仅五个文件，不是XRT二进制或物理BIT认证。声明板身份与软件一致性不是密码学认证。
本轮受控确认可作为第2项实验闭环收尾证据，不等于所有工程验证/完整长稳/生产候选晋升。大矩阵优势不外推KWS、连续音频、任意ARM实现或能效；功率/能量尚未实测。
建议停止追加本轮微优化，保留此候选与适用边界，转第3项整板能耗准备及第5项报告证据归档。任何新增板测、应用路由、默认变更或外部成果提交仍需bx确认。
