cpfbx/OpenNPU-Lite-FPGA/report/evidence/e07.md

# 隔离320调用：原件复算与阶段结论

2026-10-17（客户端日期）。人类负责人/唯一实板操作者bx；本地复算Codex/root；有限独立审查Codex/root/isolated_archive_readback_review。矩阵clone base `35d4db623091dfc7a63459d07f04e4484dbbd999`，分支`codex/matrix-delivery-audit-20261012`。新增复算工具与文档未提交；未改冻结验证器、oracle、RTL、协议、系统库或生产默认，未连接开发板。

## 结论

**本次完整320调用原件已回收，电脑逐值复算、退出/清理与板端readback全对象核对全部通过。第2项“更强ARM同场性能边界”诊断闭合，不是性能晋升。**

- 320调用、80输入组、80 PL调用；52,428,800个INT32位置全部对独立INT64精确。
- 128预热＋192正式测量，每形状/后端24正式输入；8块配对，CPU后端48个新进程顺序退出后切换。
- 512³完整请求比本次优化单线程ARM均值快，23/24配对更快；256³不胜单线程ARM。两形状均不胜本次双线程ARM，均0/24更快。
- 不再以“胜旧NumPy”概括成“胜优化ARM”。旧硬件/历史成果保留，失败native候选不重开。

## 同场完整请求（ms）

| 形状 | 旧NumPy均值 | OpenBLAS 1t均值 | OpenBLAS 2t均值 | cached FPGA均值 | FPGA相对1t | FPGA相对2t |
|---|---:|---:|---:|---:|---:|---:|
| 256³ | 62.668 | 41.687 | 24.672 | 51.667 | 慢23.94%，0/24胜 | 慢109.42%，0/24胜 |
| 512³ | 436.841 | 298.523 | 166.178 | 279.358 | 加速比1.0686×，23/24胜 | 慢68.11%，0/24胜 |

慢百分比为`FPGA/CPU−1`，加速比为`CPU/FPGA`，不可混为同一百分比定义。旧NumPy对FPGA均值之比为1.2129×/1.5637×，只限本场该后端，不与历史483数字拼接。

| 形状/比较（FPGA−CPU） | 配对均值差ms | 8块探索性95%区间ms |
|---|---:|---|
| 256³ vs 1t | +9.980 | [+9.483, +10.466] |
| 256³ vs 2t | +26.995 | [+26.484, +27.442] |
| 512³ vs 1t | −19.165 | [−22.141, −15.923] |
| 512³ vs 2t | +113.180 | [+110.859, +116.197] |

FPGA P95/max：256³ 52.802/52.900ms，512³ 293.498/301.351ms；1t分别41.914/41.970、300.707/307.210ms；2t分别24.984/25.031、169.688/172.315ms。8块bootstrap和有限样本P95/max只是诊断，不是硬尾延保证或新晋升门。

主窗口是准备后的完整请求，包含转换/构帧/同步/提交/等待/拆包及原有调用内检查；不含进程启动/import、资源准备、外部INT64参考和证据IO。预热不并入正式均值；不是冷启动、整段测试耗时、纯PL或DMA+PL窗口。原FPGA profile保持ON，不偷换为未观察路径。

## CPU成本能说到哪里

| 形状 | FPGA计算进程CPU均值ms | 2t计算进程CPU均值ms | FPGA相对2t |
|---|---:|---:|---:|
| 256³ | 48.430 | 42.092 | 多15.06% |
| 512³ | 254.062 | 316.746 | 少19.79% |

512³存在“计算进程CPU时间较少、墙钟较慢”的权衡，不等于整板节能、释放一颗核心或后台任务吞吐提升。guardian整步CPU包含启动/IO/oracle等异窗工作，不能直接相加构造请求级CPU总量；系统其他进程与能量未测。

本场运行上下文为ARMv7l/Python3.10.4/NumPy1.21.5，affinity=[0,1]，线程环境未修改；旧NumPy实际映射ATLAS目录libblas，新私有库声明OpenBLAS0.3.28 CORTEXA9 MAX_THREADS=2，配置1t/2t及封存SHA核对通过。不把配置线程数直接称为每种形状都满双核；也不声称本次库是所有可能ARM实现的绝对最优。

## 原件与实际执行

归档由bx在板上生成并SCP到本机Downloads；本轮直接读取该本地文件，没有再次远程取件或上板。

- 归档：`matrix_isolated_nyi5y50v_20261016T161825_949.tar.gz`，186,357,660B。
- SHA256：`66a2955b4ad06b223b668c7bafa647aa40694545f5e08edead5c1bb8a4364521`。
- release：`140235264d869f889c2ccbeb3fa0b0a2d1408a607affd3f5ddb8e7b6fcaa7840`。
- 原ZIP：`d65d4ca6d7e817f3189c1eaeb2a314d49be36019802654b50c33f51f3c2a91a2`，34成员；库`a1ee68685946287785a55e07fb60089441252676fc78ee1756a28c3f5de29c3b`。
- 本地输出根：仓库根`.offline-results/matrix-isolated-board-readback-20261017_01/`；安全展开2142成员、236,922,203B、1911文件到`originals/matrix_isolated_evidence_nyi5y50v/`。
- 新工具：`scripts/matrix_arm_blas_candidate/verify_isolated_board_archive.py`，SHA `c08ac74506b693f2898ac4ddf864b5acfbdfe2fc81792214e8c31d438aa3e633`。
- 标准库12项导入安全单测，0 failure/error/skip，实际工具exit0。独立审查另跑同12项及5个真实tar探针；独立从320条timing JSON重算192正式样本的均值和配对胜数，未重复52M数值工作。
- 主复算在既有隔离WSL Python3.10.12/NumPy1.26.4中单线程运行，实际工具exit0，含导入/身份/全量数值/统计/前后SHA共275.135秒。未安装新依赖、未改WSL上限、不导入TensorFlow。
- 先验证封存包，再调用其**未修改**`isolated_release.readback`：重新生成种子输入，读取原始NPY，逐项INT64重算，并验证输出/计数/jobs/计时分区/上下文。不是接受success字段就算完成。
- PC NumPy导入后禁止CDLL/Popen及PYNQ/pyxrt导入；这是对可信固定代码的防误调用，不是任意恶意Python沙箱。原件和封存包逐文件SHA前后相同，归档SHA重核相同。

关键结果SHA：

| 本地文件 | SHA256 |
|---|---|
| independent_readback.json | 8f3c3dfec65491bba7dd521149392069b4449cf1cb2cc5ec9120fc388dc2a08c |
| result.json | 73955a8c4926a0094b9b11d54f29341e06dd42ee0bc96da6411c62e6c1685860 |
| original_inventory_before.json / after.json（相同） | 1f759034abe8a6eb67459dadabe30b9e417b6f5e5fbe7a95822cbdbec7dadd3f |

有限独立审查：仓库根`.offline-results/matrix-isolated-board-readback-review-20261017_01/review.md`，另有`timing_check.json`和`archive_probes.json`。审查意见不是bx的合并/晋升批准。

## 退出、清理与日期边界

真实退出来源是`session/parent/actual_exit.json`：guardian PID1088，actual_child_exit_code=0，parent_stop_requested=false，stop_signals=[]。生命周期：checked_calls=320、operation_success/experiment_complete/cleanup_complete=true，held/safety_unresolved/lease_retained/runner_retained=false，root_buffers_retained=0；supervision returned_without_pending_stop=true。

worker生命周期中的actual_child_exit_code=null不是失败，也不是退出证明；必须与父进程wait记录分开。原件`board_evidence=false`、`physical_identity_authenticated=false`、`performance_gate_evaluated=false`、`promotion=false`保留，不冒充物理认证或默认替换。

板端回贴UTC/归档名标10/16，客户端日期10/17；绝对时钟一致性/偏移未关闭，不倒改旧证据或补造准确开始结束UTC。配对请求时长来自monotonic/CPU计时，原始统计仍可按该窗口复算；不能据此宣称日期已认证。

这是新目录nyi5y50v完整运行；旧iv5xco8f主动中止/exit1记录仍保留，未把40次续成320，也未改旧失败。当前本地复算已结束；本次资源清理有原件证据，但未重新远程查询全板其他进程/锁，当前全板状态未知。

## 下一步（不再消耗一轮320）

1. 更新第2项证据账本与交付入口，所有ARM优势注明后端、线程、窗口和负结果。本次诊断可收尾，默认不变。
2. 第3项先确认UT70供电路径、累计Wh分辨率/误差，再拟相同任务数的整板能量与CPU测量合同，由bx确认后亲自运行；目前不报节能数字。不直接套用320的重复重型审计，也不私自改其oracle。
3. 第5项继续统一源码/许可/复现/Skill与报告；第4项仅有界处理现有前处理精确关口和拒识，未通过就明确有限演示，不扩训练或换矩阵主线。

原生主机失败候选保持停止。是否另启跨层接口/RTL新路线属新的关键决定，需要独立预算/可行性与bx批准；本次收尾不暗含启动授权。
