cpfbx/OpenNPU-Lite-FPGA/report/evidence/e08.md

# 原生矩阵候选实板原件复算与有限成本判断

2026-10-16；负责人/实板操作者bx，本地复算Codex/root。对象为既有14调用功能烟测，不新增测试合同，不晋升。

## 结论

**功能通过；本次七个形状完整调用均退步。当前native_prepared候选不进入正式性能长测、不替换旧cached路径。** 这不否定既有矩阵加速器或10/13大矩阵配对成绩；本次没有ARM CPU对照。

每后端/形状仅一次首调用、无预热，以下为描述性配对，不估计P95、置信区间或稳定退步幅度。不能把功能通过当成提速，也不能把一次烟测当成全平台性能结论。

## 原件核验（实际完成）

- 用户上传：`C:/Users/BXstudywork/Downloads/matrix_native_smoke.tar.gz`。
- SHA256：`a44895a7023de5d1e964d3236fe95538548552af0cd2d2d683953a193ceef63f`，本地重算相符。
- release identity：`68d1ea9d69a9082b79c9f86990e578b9f1e866d0c1238df00f09ac09b626f308`；冻结28成员包校验通过。
- 安全检查归档路径/类型/范围后导入新目录；无链接或越界解包，不改上传原件。
- 使用原发布包replay，从固定seed及保存输入独立INT64计算输出，检查原始输出、job次序/工作量/计数器、生命周期与父进程真实退出记录；不只相信success字段。
- **14调用、7输入组、737,224个INT32位置全部精确；清理通过；父进程记录actual child exit0。** 本地结果与板端readback完整对象相同，复算前后原件SHA清单不变。
- WSL Ubuntu-22.04 / Python3.10 / NumPy1.26.4；工具actual exit0。复算显式禁止ctypes库加载和真实PYNQ导入，未连接开发板、未执行ARM库、未重跑实板。
- 当前验证为实现会话本地原件复算，**不是新增独立会话签批或物理板身份认证**；保留board_evidence=false、performance_gate_evaluated=false、promotion=false。

本地证据根：工作区`.offline-results/matrix-native-board-readback-20261016_01/`，含`originals/`、`independent_readback.json`、`result.json`及原件逐文件SHA清单。复算脚本：`scripts/matrix_native_frame_candidate/verify_native_board_archive.py`，SHA256 `22a452ee6c50373ba8021f605269f3e1ec1581d45e0950f33cf2b2f3aecbc54e`。

## 完整调用结果（ms）

| M×N×K | cached | native | native−cached | 退步幅度 |
|---|---:|---:|---:|---:|
| 15×13×65 | 7.652 | 11.677 | +4.025 | +52.6% |
| 64³ | 7.961 | 11.463 | +3.502 | +44.0% |
| 127×95×63 | 12.586 | 17.769 | +5.183 | +41.2% |
| 128×64×128 | 11.128 | 17.002 | +5.874 | +52.8% |
| 128³ | 14.909 | 22.549 | +7.640 | +51.2% |
| 256³ | 53.664 | 84.419 | +30.755 | +57.3% |
| 512³ | 283.486 | 416.921 | +133.435 | +47.1% |

512³线程CPU增量133.379ms，内层驱动窗口增量仅0.129ms。故观测到的增量主要在内层窗口外，且伴随CPU执行成本增加。内层窗口是原driver的提交/等待窗口，**不包含此前copy/flush及此后invalidate/输出复制/计数器读取，不是纯PL或完整driver时间**。不得把133ms全部指认为某个函数或DMA带宽问题。

## 有限源码核查：已知额外工作，不冒充ARM分段测量

实际读取发布对应`prepared_driver.py`、`native_matrix_call.py`、`native_smoke_runtime.py`与冻结driver/协议代码。新路径并非“只把同一packer换为C”：它保留旧driver主体，同时引入更强的请求内输入与native帧核对。

| 512³环节 | 代码确认的工作 | 判断边界 |
|---|---|---|
| 输入前后摘要 | A/B各前后一次，共4次SHA；摘要助手先`tobytes()` | 共读取1,048,576B输入摘要数据；具体ARM耗时未测 |
| C构帧后snapshot | 4,198,400B wire转为不可变bytes | 尚未消除这次snapshot及原driver的TX复制 |
| wire拆解/元数据 | 64条record及事务/块描述重建、头重建比较、独立receipt头解析 | 原生化的是填帧，不是整个Python请求 |
| 提交前操作数核对 | 64jobs×8K块，1,024次面板bytes切片，合计4,194,304B；128个唯一面板解码/数组比较，896次重复面板比较 | 数量来自几何与源码；不是DDR流量或时间归因 |
| 返回/拆包 | receipt精确比较、工作量/计数器、输出padding检查和放置 | 不能直接删除检查制造收益 |

旧cached控制沿用返回record核对；没有新路径这些请求内前后SHA与独立native操作数解码。外层实验对两者仍执行输入摘要及完整数值核对，且均在服务计时外。因此本次比较回答“完整候选是否实用更快”，**不隔离C语言本身收益，也不能宣称两者保护实现成本完全相同**。

PC构帧局部加速不覆盖上述新增及沿用的请求成本；不能按CPU频率换算到ARM。当前可定位到成本域和明确操作清单，**尚未获得各函数ARM耗时，不能宣称根因已定量闭合**。

## 阶段处理与下一步

1. 当前候选停在诊断资产状态，保存成功功能与负收益原件；旧路径、生产默认、RTL/BIT/HWH/协议/门限不变。停止该候选正式长测并不删除成果或终止矩阵项目。
2. 本次取件、数值/退出/清理复算与有限源码成本核查已完成。不重复14或483调用，不为取得漂亮结果无限追加探针。
3. 如再考虑主机优化，须先给出等价检查的合并设计、真实成本依据和有界预算；不能把已有持久缓冲/一次链提交重复算成新收益，也不能未经批准移动安全检查出计时窗口。现阶段无已证明可挽回133ms的方案，**不立即生成又一个板包**。
4. 既有计划中的更强ARM基线、应用可靠性、能量与交付仍独立存在；本负结果不以口径变化冲销。下一具体实施按已批准范围推进，新增路线/合同交bx确认。

本轮仅新增本地复算工具/报告与续接摘要；未修改发布包、运行时或其他人的tracked改动，未提交/推送/合并。复算子进程已exit0，无本轮遗留测试进程；当前板卡通电/锁/Overlay状态未远程读取，不据旧退出记录推断此刻空闲。
