cpfbx/OpenNPU-Lite-FPGA/report/evidence/e09.md

# 三后端同场实板诊断：512³主机路径获得实测改善，仍未胜双核ARM

日期2026-10-21；人类负责人/唯一实板操作者/最终批准者bx；准备与本机离线复算Codex/root。
本报告是作者对返回原件的复算，不冒充另一位独立审查人的签名，不申请或宣布默认晋升。

## 1. 结论先行

本次一次固定计划实板完成12块、72调用（48正式、24预热），正常退出和清理通过。
512³完整请求均值由旧FPGA的272.112642 ms降至flat的242.822112 ms，
减少29.290530 ms，即10.764120%，同场旧/新完整请求均值比1.120625×。
这是主机路径最小候选的真实正向结果，不是扣除某段后的反事实预测。

但flat仍慢于本场OpenBLAS 2t的172.240538 ms（均值慢40.978491%）。
256³未改善，flat比旧FPGA均值增加0.692036%，两者均慢于ARM。
因此不能写成“已经战胜双核CPU”“全尺寸加速”或“节能”。

## 2. 固定身份与原件完整性

- 准备ZIP SHA256：ba97179b65746e159a79b7aca62a647bf3d0152250a0a7ab151c4e19cbaa451f；
  包根manifest f5cbf7a06fc0e680a076d942089b3012acbc4c0930cfc75c1c6d94e066f8009c。
- 内层runtime v3 manifest：00dd2b40d0d3fe865c3a5e7cd63debdf19696cc02471e749a3d665705278bae8；
  原D075 BIT、MODE11、Oracle、Owner/Call、DMA提交/等待与安全门不改。
- 完整配置SHA：4b114fc6868c31c7b4b9c81799b6afbc278dad4103d57b039eff1a3fec8fe244；
  请求子对象SHA：85297c95c7a98afb5ca59f2e3358730ec2d11dbbe7a02dd78ea16e681b407a4e，二者不混用。
- 成功工作目录：threeway72_run_dwju7y4c；外层启动前打印12:45:36 UTC（北京时间20:45:36）。
  该时间是启动标记，不是硬件同步或全部调用总耗时。终端没有独立结束UTC，不从wait次数猜时长。
- 运输归档6,032,396 B，SHA256
  d4358fe86aac049818f929434d38a5a1613bef21b33f6b7e4f6ce9606b298bca，双端及本机复核一致。
- 归档134成员、95普通文件、解包文件总量8,261,135 B；四根目录为成功会话、
  首次缺锁失败r4frkz8y、两次锁准备。拒绝路径逃逸/符号链接/硬链接/特殊文件，未执行归档代码。
- round内清单索引78文件，manifest SHA
  3b20a0120fadce03f08254623b1cb58221f3eccad92309570e456b716512592b，
  与外层绑定及本机逐文件SHA完全一致。原95文件复算前后字节未变，不含个人音频。

## 3. 正确性、OS回执和留存范围

冻结计划逐行核对：256³和512³各6块，顺序均为old/flat/2t/2t/flat/old；
每块先2预热再4正式，输入ID42/43交替，共72行，6组各8正式点。

外层父进程实际wait退出0、非注入进程组查询消失；12个不同子PID的实际退出/等待、
reader clean、清理与同inode释放回执逐一核对。8个FPGA块fixture/evidence_injected=false；
4个CPU块native_compute=true、popen_factory_injected=false，冻结CPU入口请求2线程OpenBLAS。
所有资源回读held/lease/runner/buffer归零，D075 clean terminal及恢复确认一致。
规范锁device45826/inode214869，全轮一致；没有自动kill/retry、停止信号或信号恢复错误。

数值层次明确区分：

1. **运行时**：冻结链路报告72次逐次全量黄金核对成功；它不是72份完整输出都归档。
2. **本机逐条回读**：48条FPGA指标/输出SHA对固定输入银行，并重算MODE11工作守恒、
   jobs、bytes、MAC、首job ID、DONE/错误及原计数读取策略，全部一致。
3. **实际留存的全输出**：12个事前固定local_index=2的代表输出，共7,864,320 B、
   1,966,080个INT32位置，逐字节对冻结黄金通过。固定选择的代表均是ID42，不冒称留存了ID43。
4. **独立整数重算**：四组银行（两尺寸×ID42/43）全部用本机INT64矩阵乘法重新计算，
   655,360个银行输出位置与黄金字节一致。CPU非代表调用的全部原始输出未留存，
   其逐次核对由被冻结父进程路径及成功计数回执支持，不伪称本机重新读取过全部72份输出。

SHA与一致性检查不是对能同时替换全部文件和清单的攻击者的数字签名；
physical_identity_authenticated=false仍保留。本轮仅正常完成，没有实板停止注入或新故障恢复覆盖。

## 4. 当场正式样本统计（全部保留，单位ms）

每行8正式点；另有24预热不混入均值。均为同场、相同工作量，未使用历史166/279ms作门限。

| 尺寸 | 后端 | 完整请求/CPU调用均值 | 中位数 | 最小–最大 | 进程CPU时间均值 |
| --- | --- | ---: | ---: | ---: | ---: |
| 256³ | old FPGA | 57.296271 | 57.396200 | 55.821680–58.260702 | 53.968504 |
| 256³ | flat FPGA | 57.692782 | 57.363301 | 56.835502–58.823268 | 54.393722 |
| 256³ | OpenBLAS 2t | 25.163401 | 25.144296 | 24.938702–25.391520 | 50.777680 |
| 512³ | old FPGA | 272.112642 | 271.862877 | 268.749285–278.110196 | 246.744488 |
| 512³ | flat FPGA | 242.822112 | 242.897021 | 240.520455–244.930111 | 217.793745 |
| 512³ | OpenBLAS 2t | 172.240538 | 165.310966 | 164.893427–214.395021 | 335.749574 |

FPGA计时为完整ComparisonCall请求；CPU为冻结OpenBLAS包装调用（含其转换/结果检查），
不是只拿裸SGEMM内核作对照。两边均不含父进程外部黄金重算、IPC、进程启动、准备与清理。
与服务批次保存包络、冷启动或整板累计焦耳数不是同一合同。

512³的8个flat正式耗时均低于本轮8个old正式耗时，两个方向的块也都有改善：
old块6均274.135834、flat块7均242.751392；flat块10均242.892832、old块11均270.089450。
这支持本轮描述性改善，不自动推出置信区间、跨日稳定性或P95验收。

ARM512³保留全部8点：165.371009、214.395021、165.276086、165.031218、
164.893427、172.412855、165.345846、165.198843 ms。
214.395021 ms慢点是global_index51/block8/local3/ID43，未定位原因，
不删除、不拿中位数替换事前均值，也不追加点“冲淡”慢点。

同场512³ flat进程CPU时间较old减少11.733086%，较双线程ARM少35.132086%；
但256³反而较old增加0.787901%、较ARM增加7.121322%。CPU时间不是功率或能量。
输入只有事前固定的两个银行ID，重复调用不是8个独立随机矩阵样本。

## 5. 本轮512³改善落在哪里（嵌套关系，不全加）

| 计时段 | old均值ms | flat均值ms | 解释 |
| --- | ---: | ---: | --- |
| 完整请求 | 272.112642 | 242.822112 | 同场实测总耗时减少29.290530 |
| 事务构造 | 77.951065 | 78.163881 | 未改善 |
| owned submission | 139.971707 | 111.547700 | 减少28.424007，主要变化所在 |
| └ chain_total | 51.048405 | 49.732968 | 包含下行DMA+PL，不额外加到owned上 |
| └ owned − chain_total | 88.923302 | 61.814731 | 构帧及Owner前后检查合计范围，减少27.108571 |
| 　 └ DMA+PL | 31.045423 | 30.988313 | 仍约31ms；仅约0.057110ms差异，不据此宣称硬件核更快 |
| record重建 | 31.474629 | 31.692842 | 未改善 |
| 输出拆包 | 18.621988 | 17.395977 | 减少约1.226010 |
| 四个外层stage合计 | 268.019389 | 238.800399 | 非完整可加分区，只是四段和 |
| 完整请求减四段和 | 4.093253 | 4.021713 | 保留未归入的差额，不塞给未知函数 |

DMA+PL实际嵌在chain_total内部，而chain_total嵌在owned submission内部；表中缩进只示
包含关系，不能把同级显示误当加总。owned−chain_total是同请求内已知边界间的归因残差，
不是“删掉某段后已达到”的反事实延迟。

本次flat仅替换pack：保留原build_chain_record，直接join header/payload部分，
避免每个record额外物化header+payload中间bytes。原Owner/Call、整链每通道一次DMA与
_submit_chain不变；不把它说成从512次DMA改成一次。
记录没有单独计时pack_chain，因此不能把上述全部差值精确归因给某一次memcpy；
这里只能说变化主要落在构帧/Owner检查合计窗口，与候选改动方向一致。
256³虽owned均值减少约1.408ms，事务构造/拆包等段增加使完整请求未改善，不掩盖该负结果。

## 6. 审计工具、失败保留与下一步

audit_board.py从原件重算计划、清单、回执、48条FPGA指标、四黄金、12留存输出及六组统计；
不加载ARM .so、不导入PYNQ、不连开发板。26项本地审计回归0失败0跳过、exit0，
包括缺行/顺序/重复/类型/NaN、OS注入/未wait/组残留/锁漂移/缓冲残留、周期与MAC篡改。
实际日志在verification_02；audit_result_01.json为完整机器可读结果。

首次作者复算退出1：自身stats多了n字段，直接比较summary字典时字段不一致。
仅修正输出字段对齐，未改原件或容差；audit_attempt_01.md保留事实，不伪称首次全过。
另一次早期r4frkz8y板端启动前缺锁退出2，用户确认中途主动重启；该失败和两次锁准备均在归档中，
当前成功没有抹去它。恢复时限定boot ID，另建dwju7y4c，不原目录重跑。

**建议收口：** 先让bx审阅本次结果及必要独立只读复核，保持flat为显式候选，不改默认。
若继续优化，应事前批准新的有界目标，优先核实仍约78ms的事务构造、约32ms记录重建，
或进一步细分61.815ms合计窗口；不直接承诺能降到双核ARM门槛。
新同场能量或KWS工作均需单独范围，不从本轮延迟改善外推焦耳下降或识别率改善。
本次不自动追加板测，板卡由bx保持现状，未授权关机。
