cpfbx/OpenNPU-Lite-FPGA/report/evidence/e10.md

# 连续面板候选：2026-10-22 PANEL72实板诊断复算

结论：在本轮同场合同下，新候选相对**已有flat**，256³完整请求均值减少10.32%，
512³减少9.54%；两尺寸各8个候选正式样本均低于该尺寸全部8个基线正式样本。
本轮正常运行、数值/计数、OS退出与资源清理检查通过。
**仍未战胜本场OpenBLAS 2t，未验证能量、KWS质量或并发服务收益，不替换默认。**

## 1. 实验与证据身份

人类负责人/唯一实板操作者/最终批准者bx；Codex/root仅准备与本机复算，无新子agent。
源base fb6b2f7b94de81a821bb08ebde0660d12752ba66；候选为额外私有主机路径，不是默认/正式发布。

- bx批准并执行一次；启动前UTC2026-10-22T02:43:57Z，输入PANEL72，launcher实际exit0。
- 准备ZIP SHA `6538c698bfda22cab33a6a0e8433f9142362d5b86db73573b665085e3158665a`。
- runtime manifest `ae68762a77042a61aea4c61d6b8e9c0ca9dd0c7620a848de6f259ed45bb10b54`；
  plan `6089684494eca581f38af0b6595a920cbb39ac6f03f17b4b87845433e0246fff`。
- work `panel72_run_hb9dhjt9`；config SHA `062b1f86a934ba648575fbe6774c0d1732665419759a73a2740ebdb4f3bb9ed4`。
- 返回tar.gz 6,031,992 B/127归档成员/90常规文件，两端SHA
  `79a6640a0ac8e938e982b83a280eff8e39617a432753c32946d52487c9238a78`。
- 内层78索引文件，manifest `cde7df325daa4e4a7f1cb990affac98ec4911ea496eeb5732b16f71b7d9c7c2e`；
  原件字节前后保持不变，LOCKONLY记录一并保留。

同一D075 BIT/HWH、MODE11、原Owner/DMA主体与安全门禁；两个FPGA后端均使用已审flat驱动。
只有新后端选连续面板生成；仍非零拷贝，不跨请求缓存数据，不删记录核验或外部INT64检查。
CPU为本场固定ARM OpenBLAS0.3.28 2t包装；无原生PC替身参与此次实板。

256³/512³各6块，baseline/new/cpu/cpu/new/baseline，2预热+4正式/块；
共72调用=24预热+48正式。每尺寸每后端8正式，ID42/43交替；不是8个独立随机输入。
保留全部慢点：例如512³ CPU最大208.434ms没有剔除。反向顺序降低漂移敏感性，不证明偏置消除。

## 2. 同场完整请求结果

| 尺寸 | 后端 | 正式n | 完整请求均值ms | 中位数ms | min–max ms | 进程CPU均值ms |
|---|---|---:|---:|---:|---:|---:|
| 256³ | 已有flat基线 | 8 | 58.733 | 58.516 | 58.106–59.940 | 55.364 |
| 256³ | flat＋连续面板候选 | 8 | 52.672 | 52.700 | 52.130–53.037 | 49.326 |
| 256³ | OpenBLAS 2t | 8 | 25.342 | 25.273 | 25.020–25.720 | 46.296 |
| 512³ | 已有flat基线 | 8 | 266.977 | 264.518 | 263.714–275.745 | 241.236 |
| 512³ | flat＋连续面板候选 | 8 | 241.510 | 241.525 | 240.544–242.479 | 216.573 |
| 512³ | OpenBLAS 2t | 8 | 171.555 | 165.868 | 165.392–208.434 | 330.332 |

256³候选相对已有flat耗时减少**10.32%**，同场加速比
1.115×；仍比本场CPU2t慢107.85%。
512³候选相对已有flat耗时减少**9.54%**，同场加速比
1.105×；仍比本场CPU2t慢40.78%。

候选每次调用的进程CPU时间相对基线：256³减少10.91%，
512³减少10.22%。512³相对本场CPU2t减少34.44%；
256³反而比CPU2t多6.54%。
这是进程user/system累计CPU时间，不是整机CPU占用率、并发QoS或能量。

| 尺寸/顺序段 | 基线均值ms | 候选均值ms | 相对基线耗时减少 |
|---|---:|---:|---:|
| 256³ / baseline→new→cpu | 58.294 | 52.440 | 10.04% |
| 256³ / cpu→new→baseline | 59.171 | 52.904 | 10.59% |
| 512³ / baseline→new→cpu | 269.689 | 240.975 | 10.65% |
| 512³ / cpu→new→baseline | 264.265 | 242.044 | 8.41% |

两组指后端执行顺序，不是矩阵行列方向；仅本会话结果，不外推跨日稳定或P95验收。
10/21历史old→flat的10.76%属于另一场实验，不与本场9.54%连乘或相加，不用跨场相减制造总收益。

## 3. 分段归因及可解释范围

FPGA完整Call排除外部oracle、进程启动、IPC、初始化、落盘与清理；CPU沿原包装调用计时。
下面四段是请求内实测阶段，不是完整可加的所有工作；残差独立列出，不凭猜测分给某个函数。
chain_total内含DMA+PL，且位于submission内，不能重复累加。

| 实测区间（ms，嵌套部分不可全加） | 256基线 | 256新候选 | 512基线 | 512新候选 |
|---|---:|---:|---:|---:|
| 事务构造 | 18.510 | 12.440 | 95.454 | 71.131 |
| owned submission | 24.758 | 24.663 | 112.832 | 111.716 |
| 记录重建 | 7.587 | 7.639 | 32.182 | 32.093 |
| 输出拆包 | 4.916 | 4.970 | 19.130 | 19.219 |
| 四段求和 | 55.771 | 49.712 | 259.598 | 234.159 |
| 完整请求减四段残差 | 2.962 | 2.960 | 7.379 | 7.351 |
| ↳ submission内chain_total | 9.968 | 9.854 | 50.361 | 49.903 |
| ↳ chain_total内DMA+PL | 4.871 | 4.815 | 30.849 | 30.966 |

两个尺寸的主要可观察下降都落在事务构造窗；512³事务构造95.454→71.131ms，
与本候选“先连续物化转置面板、再导出相同bytes”的单机制相吻合。
这不等于逐条指令/分配器/缓存行为已被独立因果分解，也不能声称所有差额都是解释器或某一次拷贝。
显式连续临时数组单个最多4096B，不是进程RSS增量上界，更不是零拷贝。
DMA+PL约30.849→30.966ms（512³），它不是纯阵列时间，不能与CPU完整请求相除宣称硬件加速比。

## 4. 正确性、清理与核对工具

- 原始72行计划顺序、阶段、输入ID、first_job_id与计时类型逐项核对；48条FPGA指标/输出SHA与银行相符，
  MODE11字节/job/MAC与并行工作守恒均通过。
- 四组固定银行在PC上独立INT64重算通过；12份预定代表完整输出共1,966,080个INT32位置与重算结果一致。
  代表固定local_index2，即ID42；不能冒称本地读回或独立重算72份实际输出。
- 外层真实wait/exit0/组消失及12个块子PID、CPU原生标记、两级终态回执一致；
  清理无保留锁/runner/root buffers，device45826/inode214904同inode规范锁释放回读一致。
- 无停止信号、自动强杀或重跑；本轮只验证正常完成，不将离线停止/故障单测当作实板停止注入。
- 本地独立审计exit0，作者审计回归共40方法exit0（26继承+14新反例），原件不改。
  Fraction直接从原始整数ns重算均值/百分比，与Decimal结果相符；这是另一算术实现，不是另一位审查者。
  不把SHA一致视作真实性签名或物理板身份认证。

## 5. 后续建议与范围

将本轮记为**已验证的显式候选改进**；现有稳定主干不改、不默认晋升。
建议以本轮作为这次有界连续面板优化的收口成果，先独立复核并同步报告/图表，再按原计划推进KWS离线根因与交付。
如果要验证此新候选能量，需另定同工作量/同边界的采集合同并获bx批准；本次没有功率曲线或焦耳数据，
旧ABBA能量结果不能移植为新候选能效结论。
不追加板测凑数据，不为必须战胜CPU而扩大成无界驱动重写。

本轮Codex未连接设备或运行硬件。按原件本次进程已结束/资源已清理；此后板卡通断电由bx管理，未获授权不关机。
机器结果：`audit_result_01.json`、`independent_math_01.json`；原始90文件只读保存在`original_unpack_01/`。
