cpfbx/OpenNPU-Lite-FPGA/report/evidence/e11.md

# PANEL72实板复算独立复核：收件与结论

2026-10-22；bx负责人/唯一板操作者，Codex/root本地回读。
外部报告自述为Gemini独立会话，有前序背景，不称零记忆盲测。
base fb6b2f7b94de81a821bb08ebde0660d12752ba66；原7项tracked dirty及封存原件不动。

## 实质结论

接受**本轮实板原件与离线复算的独立只读复核通过**。没有需改运行时或重新板测的阻塞项。
这是证据收口，不是默认晋升/合并批准，也不把第三方建议作为新板测许可。

- 返回ZIP16,200 B、21成员（20索引+MANIFEST），SHA
  `b1633590844f45ffd58de5c6db8d68c78c85b76a7bd7a3568af2b8b0d052a180`；
  MANIFEST SHA `eff2c6c154b64b651c633c15a3064aaee72c32f4d20dea0bcb8cf7052a55deed`，全部成员核对通过。
- 返回报告SHA `afa2e9e98381317cb3af2b84efd2932e92dc438cae11fcd96f626aff6ca1de52`。
  原ZIP/报告/21解包成员保留在本目录；未执行对方脚本。
- 被审包 `c30e6b60…4a4fe`、manifest `758e5581…94e426` 的243索引均与本机封存副本相同，
  本机结果封存128索引也未变；原tar `79a6640a…38a78` 与90文件直接读回一致。
- Linux `audit.json`与本机`audit_result_01.json`整个JSON相等；
  `fraction.json`与本机`independent_math_01.json`整个JSON相等。
- 40项测试的方法名/顺序/通过状态相同（26继承+14新增，不按轮数或平台累加）；
  Linux unittest自身44.439s、作者对应Windows日志1.829s。
- 前/后/最终总包检查输出243索引通过，错误SHA拒绝日志成立；报告表6行/5边界检查输出相符。
  报告声明正向命令exit0、负向exit2，但包内没有独立OS退出码回执文件；
  本机核对的是原stdout/stderr、结果文件和审查人声明，不虚构重新观察了对方OS退出码。

可以锁定本场结果：256³已有flat58.732557→52.671870875ms（减少10.319125%），
512³266.977107875→241.509612ms（减少9.539206%）；两尺寸8候选点均低于8基线点。
仍慢于本场CPU2t（分别107.845702%/40.777068%）；无本轮能效、KWS、并发或默认晋升结论。
正常72调用、48FPGA计数/SHA与12代表完整INT64重放的范围不扩大。

## 报告文字更正（不影响机器结果，不改原文件）

| 项目 | 原审查文字 | 原件/机器结果 |
|---|---|---|
| 被审board_result.md SHA | 4b838c8f…f5b14c | **5a31ffc57dda2dfb0ab39f918a6110451f21386600bb972c4d45dfbf5c3cf9ad** |
| tar常规文件字节总数 | 8,092,996 B | **8,262,151 B**（90个常规文件之和，不含tar头/压缩层） |
| 对应Windows40项耗时 | 约0.9s | **1.829s**（verification_02/audit_regressions.stderr） |

审查报告六组括号内的高精度中位数也有转录偏差；作者原报告三位小数表及对方independent_audit.json均正确。
下面以原始整数ns计算出的精确中位数为准，不用括号中的错误值再派生：

| 尺寸 | 后端 | 正确中位数ms |
|---|---|---:|
| 256³ | flat基线 | 58.5163415 |
| 256³ | flat_contiguous | 52.70024 |
| 256³ | OpenBLAS2t | 25.2725195 |
| 512³ | flat基线 | 264.5175225 |
| 512³ | flat_contiguous | 241.525126 |
| 512³ | OpenBLAS2t | 165.868231 |

另两项口径：后端身份以冻结代码/选择器/请求锚点和运行指标标记为依据，
不能以“耗时特征像历史flat”证明实现身份；first_job_id按固定公式递增、不重叠，
跨尺寸从576后跳至2305，不称全局无间隙连续编号。
40项套件包含正例和反例，不统称40份负向篡改测试。

本地收件器初轮CRLF解析错误exit1已保留修前源码/说明；仅修解析副本，
不改原日志或被审程序。随后解析反例又检出endswith('OK')会错误接受NOT OK，
首轮失败与修前版本另存intake_attempt_02.md/read_review_attempt_02.py。
改为最终行精确OK后，LF/CRLF/重复名/坏footer四项解析检查实际exit0；
完整收件回读再次实际exit0，另存readback_revalidated_02.json，不覆盖首次readback.json。
这四项是收件器检查，不计入冻结审计套件40方法。

## 收口与下一步

本轮有界矩阵主机路径改进及其独立复核可以收口，保持显式候选、不改默认。
后续将有条件的确定性成果并入报告/图表；不因上述转录偏差重开runtime或追加板测。
按既定方向转向KWS离线前处理差异定位和最终交付，但两条模型链保持分离：
PC新DS-CNN的47/420不移植为既有三层FPGA模型的实板识别率。
若另做新候选能量比较，仍需新合同和bx的单独批准；本次审查不授权采集。

机器核对：[首次回读](readback.json)及[加固后完整回读](readback_revalidated_02.json)。原报告和日志均原样保留。
