cpfbx/OpenNPU-Lite-FPGA/report/evidence/e12.md

# 新路径 ENERGY1808 实板回读报告

日期：2026-10-24（Asia/Shanghai）。人类负责人及实板操作者：bx。离线收件、脚本和复算：本 Codex 会话。独立审查：待用户送审。本报告不构成默认晋升或计量认证。

## 结论

本轮 CPU→FPGA flat_contiguous→FPGA flat_contiguous→CPU 的四窗采集完成。冻结回读器实际退出0，1824条调用、1808次正式/16次预热、912次FPGA新路径，以及正常退出、进程组消失、同inode锁释放检查通过。另用独立于冻结回读器的算式交叉复算四份完整CSV与912条计数器，并从两组INT8输入重新计算INT64黄金，8份留存输出逐字节一致。

同工作量完整保存包络的Wh端点能量均值：FPGA为258.9786J，CPU为262.6938J，本轮低3.7152J（1.4143%）。P(t)梯形积分分别为258.969561175J与262.64357525J，本轮低1.3989%。两个口径均保留，未选择更好看的一个替代另一个。这是单组ABBA中观察到的小幅正向结果，不是已经证明稳定节能1.41%。

## 四窗原始数据复算

| 窗口/后端 | 正式调用 | CSV样本行 | 完整保存跨度(s) | Wh端点差×3600(J) | 功率梯形积分(J) | 两口径绝对差(J) |
| --- | ---: | ---: | ---: | ---: | ---: | ---: |
| 0 / CPU OpenBLAS 2t | 452 | 1328 | 132.7 | 261.115200 | 261.04207765 | 0.07312235 |
| 1 / FPGA flat_contiguous | 452 | 1390 | 138.9 | 257.918400 | 257.89818765 | 0.02021235 |
| 2 / FPGA flat_contiguous | 452 | 1405 | 140.4 | 260.038800 | 260.04093470 | 0.00213470 |
| 3 / CPU OpenBLAS 2t | 452 | 1348 | 134.7 | 264.272400 | 264.24507285 | 0.02732715 |

四窗均逐点100ms；峰值均不超过2.126367W，低于事前5W基础上界；八个原始Wh端点均保留六位小数，没有补零/裁剪。最大相对差0.0002800387（约0.0280%），四窗均满足事前批准的1.01J **AND** 0.001一致性报警预算。该预算只比较同源Wh累计量和功率积分，既不是仪表误差界，也不是判定后端能量差显著性的阈值。

原表头仍为mV/mA，采用事前冻结的、有条件的V/A数值解释；P=VI与5V范围检查通过，但不是独立单位认证。所有计算覆盖每份CSV完整文件，含控制、缓冲、核验等开销；预热位于正式保存开始之前。没有对齐PC/板时钟，没有截取活动区、扣空闲、除以452生成J/次，亦未认证仪表校准、设备采样丢包或积分器误差。四窗分别约133至140秒，不是相同时间窗口。

## 本场请求时间（保留全部正式样本）

| 后端 | 正式样本 | 完整请求均值(ms) | P95最近秩(ms) | max(ms) | 进程CPU时间均值(ms) |
| --- | ---: | ---: | ---: | ---: | ---: |
| OpenBLAS 2t | 904 | 170.5267 | 174.4084 | 297.2492 | 331.8055 |
| FPGA flat_contiguous | 904 | 220.4783 | 231.5849 | 264.0933 | 195.3539 |

本场FPGA完整请求均值仍慢29.2926%；单次调用进程CPU时间低41.1240%。后者不是整机CPU空闲率或已验证的并发能力。此处是本次批次入口记录的请求内计时，不把CSV保存跨度当推理延迟。正式调用没有剔除慢点；P95采用排序后ceil(0.95n)项。904个重复调用仅交替使用两组固定矩阵，不是904种独立输入或独立实验。不能与前两天不同候选/会话的延迟相乘或拼成同场加速率。

## 正确性与正常收尾

- 冻结回读的22项板端检查全部为true，8次PC/板ACK逐项匹配，4份CSV大小和SHA与各自结束ACK一致。
- 两组512³ INT8输入均由银行原字节升至INT64后矩阵相乘；结果落在INT32范围，再转小端INT32。8份1MiB代表输出全字节一致，1824条运行记录的输出摘要均吻合重算黄金。
- 912条FPGA记录额外逐条重算MODE11工作量、job序号、clean DONE、global-work-v2守恒及子集约束，并核对flat_contiguous路径标记。冻结回读器本身的路径检查只做元数据绑定，本报告不将它误称为计数器重算器。
- 运行时对1824次实际返回做过全量校验；仅保存8份代表二进制。离线没有重新执行其余1816份未保存的数值输出。
- 主worker真实等待退出0，两个CPU子进程退出0且进程组消失；规范锁device45826/inode214936在worker持有与结束探测之间一致，资源清理闭合。39个PC辅助进程均记录退出0，4次保存开始/停止、最终观察保存OFF，无未决helper。这里只证明本轮正常流程，不外推异常注入或跨日稳定。

## 身份与失败原件

成功会话：energy_prepare_AadlGFiu/work，session 1e0471257f164b9a91a2dfbea2484f16；boot380e3587-8ec7-486c-b011-124797669c4b。bx对精确plan的外部批准保留在包内approval.md。冻结源码中的activation_approved/formal_energy_input_accepted/promotion=false保持原样，不靠改回执字段制造批准或认证。

- 板端原始归档：6858082B，SHA256 `0958892fc925f59b5a52afa40aab82ec2ad424ca98e8cf5b6b69816c523701ff`。
- 全kit清单：`cf6e3578529d2237d4c732b3935284c2211c1c6c629cab807cd0a709bb72a8d6`；638文件逐项匹配，未改冻结包。
- energy清单：`456e6e783a7d85ff2393cafe7f7a990bf7b2a69d5778babfb6381bbfebf9d4f6`。
- plan：`141d9f548de54066150f64da1575dbe7204857dd73cabd98a0935f5930c2a610`。
- settings：`9c27ee1ab8607c1c5f224e89b0ae3d6de33f6912398c8d465c29d9fbdd860bdd`。
- policy：`d38165ac8fe97ed85d5365218a9ec51a8ecc95f89dfd313e00ed3e56e9154a3f`。
- PC原件/快照102文件内容一致；板归档128成员安全检查后解出109文件。输入树与原归档复算前后SHA不变。输入更细的SHA列在intake.json和recompute.json，不依赖本文手抄。

归档另含旧energy_prepare_m934k11g：wrapper退出2，entry_return为TimeoutError，outer observed_os为空且无worker目录。它与“等待PC超时、未启动worker”的历史记录一致，作为失败会话保留，绝不计入当前四窗。失败原件不会被新成功结果冲销。

仓库base：fb6b2f7b94de81a821bb08ebde0660d12752ba66；当前共享分支codex/d007-c-buffer-feasibility，既有dirty工作树保持。实跑的真正工程身份以冻结kit/嵌套manifest为准，不能把仓库HEAD冒充冻结kit的源码commit。本轮无提交、推送、默认/硬件/协议/预算修改、远程连接或GUI控制；未给任何他人分派任务。

## 裁决与后续

当前可收口的是“本次新路径完整包络诊断及离线作者复算通过”，不是正式计量输入晋升或系统节能认证。单组ABBA不能建立跨日重复性、测量不确定度或统计显著性；同源Wh/P吻合不能替代独立仪表验证。本轮不证明KWS质量或PS/PL混跑已完成。

下一步将自包含原件、冻结源码与复算脚本交独立审查，无须为了收件再跑板测。审查发现具体缺口时再决定是否需要补充；不自动重跑、改预算或扩展项目。之后继续已经批准的纯离线KWS单层pointwise候选，图表/PPT仍留在最终文件阶段。使用电子表格技能的原始数据保全、单位/来源与计算分离要求完成此次审计，没有修改CSV或制作图表。
