cpfbx/OpenNPU-Lite-FPGA/report/evidence/e13.md

# ENERGY1808 独立Linux回件核验与收口

日期2026-10-24（Asia/Shanghai）。人类负责人及唯一实板操作者bx；原离线作者与本次回件核验Codex/root；外部审查报告自述执行者为Gemini Linux独立会话，Python3.11.2/NumPy1.24.2。本次仅核对返回记录，不执行附件命令或重新推理。

## 裁决

接受本次**离线原件回读与同一审查包的Linux复跑审查通过**，该项待审收口。原报告PASS及关键数值与返回日志对应；未发现需更改候选源码、冻结包、合同或补跑实板的问题。以下非阻塞文字勘误另存，原报告及ZIP不修改，不为文案重包。

这不构成默认晋升、正式计量输入接受、仪表精度/单位认证、跨日重复性、统计显著性或KWS性能验收。既有false字段保持。

## 实际核验

本地audit_return.py实际exit0，记录在audit_01/audit.json：

- 外部回传ZIP60637B，SHA256 `fb0fc81653716d0d30191b4c57d29dfc8ea8006b407cdf065a35176a4e84b60c`；33成员/32索引文件逐项大小、SHA、CRC及安全路径匹配。原审查MD已原字节快照，SHA `0cfd8affc73a7cd84ccae008c1589a7b1506ad8e117f3c726d6979a12c208c82`。
- 被审原ZIP仍为26161982B/763成员，SHA `2c2f19873341836c1156418174df44143e34ee1c9be96be41c76b247f4d04068`；762索引及清单SHA eabfe88a…df791与返回记录一致，原包每个索引文件复核匹配。
- 六条外层命令的回执/summary/实际stdout与stderr字节及SHA逐项吻合：正向1条exit0；五条负向均为预期exit1（已有输出、包内输出、重复intake、错误清单SHA、旧超时会话）。旧会话由缺失worker/lifecycle.json拒绝，不能误报为旧会话完成或一种新硬件失败。
- 便携入口内3个子命令实际exit0；嵌套冻结回读exit0。单测原始日志26项全部ok、0skip，方法名称/顺序与被审源码AST逐项对应（ArithmeticChecks16、CounterChecks10）。
- Linux intake的638文件kit与102文件PC清单与原包逐项匹配；tar128成员/109文件逐项匹配。输入不变回执成立。
- Linux frozen readback及recompute与作者原结果的全部稳定字段完全一致，仅排除合理不同的环境/源路径字段；22板端门全部true，1824记录/1808正式/16预热/912PL、8代表输出、四窗CSV诊断与双口径均值均对应。
- 本次仅检查记录与原件字节，不重跑矩阵乘、CSV积分或板测；不能将本次核验与外部复跑累计为更多独立样本。

## 非阻塞勘误与证据强度限定

1. 原报告多处“27项＝16+11”及“Ran27…0.044s”与原始流不符。源码AST与Linux `fresh-review-output/00.stderr.txt` 实际均为**26项＝16+10**，日志为`Ran 26 tests in 0.414s`，全部通过。按原始流记录，不能补造第27项。
2. `calls.json`实际为**2369996B**，不是报告所写797298B；SHA `facbb834d9025481512cc7e6569f9e3e84f46072867d28fbf36819f640dc594b`、1824行与数值结论正确。
3. “全部904次正式请求”应为**每后端904次，共1808次正式调用**。原报告详细表与实际结果已按两后端分别统计。
4. STATUS=5为本项目自定义IDLE(bit0)+DONE(bit2)，`status & 14 == 4`遮蔽BUSY/ERROR并检查DONE，不应称为通用HLS `AP_IDLE`寄存器语义，也不应写“只有DONE置位”。冻结pynq_dma_loopback.py第41至44行有定义。3004483周期恒定及DMA+PL均值30.9927ms与原件一致，但本次不新增“纯核峰值/CPU跨边界加速比”等结论。
5. 原报告“100%真实”应限为**所提供字节与记录自洽**。SHA/进程回执不独立认证物理板或数据起源；原件中source_origin_authenticated等false保留，不能用回件摘要替代防伪认证。
6. 报告自述额外另写了独立Fraction/INT64审查脚本，返回包含其summary但**未附这份另写脚本**。可直接追踪和复跑的是原作者入口的Linux运行与原始流，本轮已核验；额外独立实现仅按审查人自述记录，不将其当作已交付、可再执行的独立验证器。本点不妨碍确认已返回的正/负向运行和数值一致，也不为此要求重跑板测或反复重包。

## 成果口径与交接

本轮同N完整保存包络，Wh端点差均值FPGA258.9786J/CPU262.6938J，低1.4143%；P(t)积分均值低1.3989%，两个口径并列。保留单ABBA、条件V/A解释、未独立校准、窗口并非同步活动能量等限制，不输出J/次或稳定节能承诺。完整请求均值本场仍慢于CPU，不与历史数值拼接。

原源码、测试包、失败会话和审查原件全部保留；未提交/推送、未改默认/阈值/权限或启动实板/GUI/网络操作。记录范围为该离线诊断审查已收尾，不代表系统三指标全部晋升。

下一步回到已经批准的纯离线KWS单层1×1 pointwise最小映射候选：先固定真实特征/INT8等价、尾块与计数器反例及声明边界，不改门限/模型或直接上板；图表与PPT仍后置。本轮所有本地核验已结束，无遗留作者进程，板卡/UT70/隧道当前状态未重新查询，不自动关机或关闭会话。
