cpfbx/OpenNPU-Lite-FPGA/report/evidence/e14.md

# DS-CNN质量诊断独立审查回读裁决

日期：2026-10-22。人类负责人/最终批准者：bx。收件与本地只读核对：当前Codex会话。base commit：fb6b2f7b94de81a821bb08ebde0660d12752ba66；沿用既有工作树，不修改他人dirty文件。附件是审查证据，不构成新策略、移植或板测批准。

## 结论与实际执行范围

接受本轮**源码与留存产物标准库独立复核**，该范围可以收口。没有取得独立重跑TFLite推理的证据，不把留存产物复算写成重新计算全部运行时中间值。不因下列文字更正要求重新打包或再审一轮。

- 返回ZIP：15,668 B，27成员（26索引文件及清单）；SHA256 `46cc67db7721e2092cf5d97a9fd2ad56d6f67c7190756980e8f9baae6b4a2dc4`。
- 返回manifest SHA256：`320f9d9e4f61effc27395734984db6078bbb1da78f9d72878fb511a8032b26b2`。
- 独立报告SHA256：`23c04e9d08ba2f154e4ecbe635076a6033cdd6d444ffa3c1de4661a01b2f98c9`。
- 被审原包90成员，ZIP SHA256 `a2ccdbb957a198a9e073feacacc2aaeae8a808036d93f6c95907e8e0885da473`；manifest `263debd95a6872ddc3a31867819997a17b6bf6b647cebd21a0da1664c3d2fdcc`。
- 审查会话自报Gemini / Linux gvisor x86_64 / Python3.11.2：实际日志含24核心+12审计=36方法，全通过、无跳过；5正向命令exit0、3拒绝命令exit1。原13项量化回归仅查阅作者日志，不是本次独立重跑。
- 独立420窗审计JSON与作者Linux审计**整个文件逐字节相同**：SHA256 `ca004761b78d04330a712276a408558f86c1cf27695c3a85baa3d4b1af4ba629`。
- 本地新编`read_return.py`实际exit0：核对返回全清单、命令回执和stdout/stderr身份、原包身份、全部审计JSON、原失败源码快照及01/02留存推理载荷。未执行外部审查脚本、未重跑模型。

原件副本在`original/`；返回27成员在`returned_unpack_01/`；全部机器核对结果见`readback_01.json`。原作者专题目录及冻结包不改。

## 质量事实与解释

| 固定420窗指标 | 旧三层模型 | 新DS-CNN候选 |
| --- | ---: | ---: |
| 原始分类正确 | 350/420 | 383/420 |
| 目标口令正确 | 270/300 | 268/300 |
| unknown正确 | 60/100 | 95/100 |
| 背景正确 | 20/20 | 20/20 |
| 原数值策略下正确放行 | 215/300 | 214/300 |
| 负例误动作 | 5/120 | 0/120 |
| 目标口令错动作 | 5 | 1 |

沿用mode0、至少3有声帧、连续3帧、score≥0.95、gap≥0。新logits先正确反量化，再调用原softmax/gate；复用同PCM旧VAD，不重新运行原生VAD。本轮54条本来分类正确的口令被拒，全部仅因`low_score`，不是VAD不足。正确损失54/300=18个百分点，仍不满足原探索性5个百分点上限。新模型并未改善目标口令原始正确数，整体+33由unknown+35、目标−2、背景不变组成。

背景20片来自同一噪声源，0/120也只是本固定集观察，不能称普遍零误触发、统计保证或新模型策略已完成校准。`deployable=false`保留。新PC DS-CNN不能与旧模型单次实板yes→off案例混写。

### 有限但明确的单门限不可兼得证据

本地仅核对报告列出的5个分数切点及已有样本序关系，没有搜索/选择/持久化新策略：

| 报告所列score切点 | 正确放行/300 | 正确被拒 | 目标错动作 | 负例误动作/120 |
| --- | ---: | ---: | ---: | ---: |
| 0.95 | 214 | 54 | 1 | 0 |
| 0.90 | 236 | 32 | 4 | 0 |
| 0.85 | 243 | 25 | 4 | 0 |
| 0.80 | 251 | 17 | 5 | 1 |
| 0.727 | 253 | 15 | 7 | 2 |

精确结论只针对**当前重复使用的420窗、VAD和gap0不变、仅改变统一score切点**。268条原始正确目标要把损失限制到15/300，至少放行253条，score切点必须≤`0.7275124325644748`（正确样本中第16低分；是允许的上界，不是最低门限）。但两条VAD合格负例分数分别为`0.7941307739549648`和`0.8446169389700794`，都会放行；2/120超过1%，而≤1%在120负例中最多允许1条。因此在这个限定情形里，两约束确实不能同时满足。

反例身份：`test:four:four/ad6a46f1_nohash_1.wav:0`预测off；`test:learn:learn/e0c782d5_nohash_1.wav:0`预测left。完整数据在机器回读JSON。不排除新独立数据、模型专属校准、联合gap或其他机制；不能把这个一维结论扩大为“以后校准全部无解”。这些切点不是建议采用的新policy。

## 报告更正（不修改收到的原件）

以清单、原始日志、源码及机器审计为准，以下是正文笔误/越界推论，不改变本轮产物复核通过结论：

1. NativeVAD实际SHA为`409b96d051bbb51a750a088177fd1694f79eb9ba317334e8f5ede75c3d288476`，不是正文`e931eb20…`；留存logits实际SHA为`de2b0d1355fdcbfc296bbb5b4c2f18e4748e346af779c1c71884f5c60f3320c8`，不是`63f1e56e…`；snapshot01实际SHA为`57c77bc64404ed90a16afb64a769c0b77f6d8c1f85bf7e915839b996172247be`，不是`1bd6d921…`。返回机器摘要对应身份正确。
2. 每窗12算子的INT8值计数是`9×8000+64+64+12=72,140`，420窗共30,298,800；不是正文列的15680/7840组合，更不是MAC数。三条原始推理载荷01/02相同，不累计成840个独立样本。
3. CLI表内若干日志SHA缩写与实际不符；原始receipt与manifest则匹配。例：核验stdout实际`7a88ef9d…`、核心测试stderr`24f44f0c…`、审计测试stderr`bc78877f…`。引用机器回执，不复制正文SHA表。
4. 不采用正文softmax举例的约0.197数值；保留源码测试所证明的反量化/跨阈值关系即可。Windows/Linux已记录的derived score/gap差异不能笼统写1～2ULP：此前逐值检查的最大score为4ULP、gap为16ULP；离散决策精确，原业务门限不变。
5. 前处理实际为完整512点复数FFT及正频率切片，并非“512半长RFFT”；mel权重先前209元素不同/max abs4.76837158203125e-6，不能概称1ULP。前处理固定集INT8精确不等于浮点逐位精确。
6. 全局准确率收益主要来自unknown，并不等于目标口令识别提高。原探索约束是负例误动作≤1%且正确损失≤5个百分点，不应替换成普遍零误动作目标。
7. ARM/FPGA移植的集成成本真实存在，但尚无本候选板端时序/功耗实测，不能宣称移植一定亏损、depthwise永远不能加速，或依据当前分数表断言任何校准都无解。

## 后续建议与权限边界

建议本轮到此收口，保留“前处理固定集数值关口闭合 + PC推理一致 + 质量仍No-Go”的成果链；暂不扩大新校准/移植/板测，把精力转向最终候选包和陌生人复现入口整合。它是排期与风险建议，不是理论上无法继续优化的断言。

路线切换由bx批准。图表/PPT仍遵照用户要求留最终材料阶段；本次不执行附件建议的绘图或训练。未提交、推送、合并、改默认、改oracle/门限、安装依赖或操作开发板，也未创建子agent。
