cpfbx/OpenNPU-Lite-FPGA/report/evidence/e17.md

# Skill candidate 03 Linux 增量复核（2026-10-20）

对象：opennpu_skill_review_20261020_v3.zip
ZIP SHA256：6f705211c9437a78fe07bc1340f72085f91281d2744c0b149fe466738f1ca5a6（38 成员，62,387B）
candidate/MANIFEST SHA256：b93d8465ae3264bf74f0077534d45fd6581a6db876209d1f32df34b73a9abc76
candidate：37 文件（36 索引 + MANIFEST）
审查身份：Codex/root，DeepSeek Harness 增量审查轮次 51，2026-10-20；不是作者，不代表 bx 批准。
环境：WSL2 Ubuntu-22.04，Linux 6.6.87.2-microsoft-standard-WSL2，x86_64，Python 3.10.12，root。
WSL2 是本地 Linux 运行时，不是裸机、不是第二块板，也不是外部陌生机器。

## 0. 结论

v3 的三处窄修复在 Linux 上实际通过：

- 旧 symlink 诊断正则不再把正确的 symlink 拒绝误判为测试失败；
- inspect_overlay_strict 在读取任何输入前检查 .bit 后缀（大小写不敏感），HWH-only/其它后缀返回 JSON、exit2；
- strict CLI 的参数错误返回 JSON/exit2，--help 保持文本/exit0。

**Linux 90 tests，90 pass，0 failure，0 error，0 skip。** 6 条标准命令全部 exit0；verify before/after 都是 37 文件/36 索引，candidate 未变。

严格 overlay 反例：同一 instance-name spoof 现在 strict exit1/ok=false；旧 inspect_overlay.py 仍 exit0，但已标为 history-only。

因此：**P1 overlay 代码缺陷关闭；P2-B symlink/FIFO 的 Linux 实跑缺口关闭。** 仍不闭合的是真实使用/A-B 证据，以及历史适配器的保留限制。

## 1. 实际执行

1. 解包到 /tmp 新目录，日志写到 candidate 外，回收：
   - OS：Linux 6.6.87.2-microsoft-standard-WSL2 x86_64；
   - Python：3.10.12；
   - ZIP SHA：6f705211c9437a78fe07bc1340f72085f91281d2744c0b149fe466738f1ca5a6。
2. verify_candidate.py before：exit0，indexed=36，actual=37，entry_policy 拒绝链接/reparse。
3. tests/run_tests.py：90 tests，90 pass，0 failure/error，0 skip，exit0（0.793s）。
4. validate_gemm_evidence.py --self-test、validate_resilience_evidence.py --self-test：exit0。
5. check_evidence_links.py evaluation/link_example.json --root evaluation/fixtures：exit0。
6. verify_candidate.py after：exit0；candidate 未变。
7. strict CLI 边界：
   - instance spoof：exit1，ok=false，missing=axi_dma；
   - HWH-only：exit2，stderr JSON "bit path must have .bit suffix"；
   - 未知参数：exit2，stderr JSON "argument parsing: unrecognized arguments"；
   - --help：exit0，文本 usage。
8. 未执行：新上下文行为 A/B、陌生使用者、第二台电脑、第二块板、GUI/板测、发布。WSL2 不是裸机，不宣称跨板。

原始日志：linux_review_01/（environment.txt、verify_before/after、tests.out/err、6 条命令的 exit 与 stdout/stderr、strict_spoof/hwh_only/unknown/help）。

## 2. 已关闭

- P1 overlay instance-name spoof：strict 已关闭；Linux CLI exit1；SKILL/README/transport 均以 strict 为当前入口。
- P2-B symlink/FIFO：Linux 90/0 skip，真实 symlink 与 FIFO 测试已运行并通过；不再依赖 Windows 模拟。
- 旧软链断言失败：v3 的正则匹配 symlink/reparse/escapes，实际拒绝路径仍被断言；不是放宽 local_path 策略。
- strict 后缀：.hwh/.HWH/.txt/无后缀在读取前拒绝；.bit/.BIT 配对成功；HWH 伙伴仍为小写 .hwh。
- strict CLI：未知参数/缺位置/缺选项值 JSON+exit2；help 文本+exit0。
- 90 项实际方法数：85 pass/5 skip 的 Windows 结果之外，Linux 得到 90/0；这是同一套测试的真实 Linux 文件系统执行，不是把 skip 改成 pass。

## 3. 仍未关闭

### P1-A（提交证据）：真实使用/A-B 仍未发生

- v3 仍没有 with/without Skill 的实际运行、评分、遗漏/纠正/时间记录。
- 没有陌生使用者、第二台电脑、第二块板的实际结果；WSL2 是本机 Linux，不是这些。
- evaluator_only/rubric.md 和 ab_plan.md 是计划/评分卡，不是结果；不能把“准备评分卡”写成“行为有效”。
- 这是“大模型协作与技能包”15/100 的核心缺口，也是用户要求“真实使用验证”的未完成项。

### P2-A（过程记录仍不完整）

- collaboration/process_record.md 有真实用户原句、作者回复摘录、计划、反例和 t2 纠错，但不是完整的“提示词—模型回答—自我纠错—提炼”链条；作者也写明不是完整导出。
- 应补完整可公开轮次，或明确“局部摘录”的采信边界；不要把局部摘录写成完整协作档案。

### P2-C（旧适配器仍不安全）

- validate_resilience_evidence.py 仍接受 Infinity timeout；validate_gemm_evidence.py 仍可接受 asserted exact 而没有 raw output；回归明确断言“未硬化”。
- 已标 history-only，README 也提示；但陌生用户仍可能误用。建议加明显的 history-only 包装或首行警告。

### P2-D（旧 inspect_overlay 仍可冒充）

- 旧 inspect_overlay.py 仍会因 instance 名返回 ok=true；当前 Skill 路由 strict，但直接调用旧脚本仍错误。应加文件头/CLI 警告，或把旧脚本改为显式 legacy 子命令。

### P2-E（link 工具仍不证明真实性）

- check_evidence_links 仍只证明字节/行引用；false prose + valid links 可 link_integrity_ok=true。已披露，保留边界。

### P2-F（WSL2 不等于裸机）

- 本结果证明 Linux/POSIX 文件系统路径可用，不证明裸机、其他发行版、其他内核或真实板卡。跨板/异机仍需另批。

## 4. t2 纠正（保留）

上一轮我 v1 行为表把 transfer/wait 归入 owned_ms - chain_total_ms 是错的；chain_total 已含 transfer/wait，75ms 不能再归给它们。v3 的 rubric/process 也已按原件语义写。原报告保留不改，以本条为准。

## 5. 结论与建议

1. 接受 v3 的代码增量：Linux 90/90/0、strict 反例、CLI 边界、manifest 前后一致均通过。
2. 不要把它当最终 Skill 包或行为有效证据；P1-A 仍是真实使用/A-B。
3. 下一步：candidate_04 前完成一次新上下文 10 题（先不给 rubric/作者结论/process_record），保留 prompt/answer/correction；同期做 with/without A/B。
4. 补 Linux 其他环境或裸机的 90 项日志；WSL2 只能作为本机 POSIX 增量。
5. 给旧 inspect_overlay/两个历史 JSON 适配器加明显 legacy 入口；不要静默保留易误用路径。
6. 补 process_record 的完整轮次或明确局部摘录边界。
7. 只有这些完成，才谈最终包/异机/公开；不自动替换根 Skill、不接板。

## 6. 审批边界

本复核只覆盖 v3 ZIP 的离线 Linux/WSL2 代码与测试；不批准发布、替换默认、板测、跨板或陌生队伍复用。90/90 是脚本测试，不是行为 A/B 或独立人类审查。
