cpfbx/OpenNPU-Lite-FPGA/report/evidence/e17_use.md

# V 的 Skill 十题使用验证：收口报告

日期：2026-10-20（Asia/Shanghai）。负责人 bx；实际使用者 V（AI 辅助）；
本报告及评分者为原 Skill 作者 Codex/root，**不是独立评分者**。
范围：一次异机、一个 AI 会话、十个既有合成案例的有 Skill 使用记录。
不修改 v3、不安装、不替换默认，不执行新的参与者试验或开发板测试。

## 结论

本次十题实际使用证据已完成作者核对与归档，可以按这个限定范围收口。
按事前既有的 40 个语义标准，首次回答的**作者评阅为 40/40**，每项均有
原始回答行号与引用。没有据此宣称 Skill 提升了多少、统计显著、全域安全、
矩阵工程异机复现通过或 FPGA-23 整体完成。

评分采用原卡规定的语义标准，不按关键词复述给分。t2 的计时顺序、源码引用、
75 ms 差额和拒绝唯一归因共同支持判断；建议把 wait 的计时归属写得更显式，
但不把作者补充伪作 V 的修订，不事后改变 rubric。若独立评估者持不同判分，
应另存其意见，不覆盖本作者评阅。

## 1. 证据身份

| 对象 | 核验结果 |
|---|---|
| 原始参与者证据 ZIP | 217,452 B；23 文件；22 个被索引文件 SHA 全部匹配，无缺失/额外成员 |
| 证据 ZIP SHA256 | `07f7ea1a7a438632e28ac1730a67c0263150adf15f7846ab29d4d4477200737f` |
| 实际收到的有 Skill 输入 ZIP | 与事前发出的 37,849 B、28 成员包逐字节一致；内部输入清单全部匹配 |
| 输入 ZIP SHA256 | `fd70779c802a9b1931d921e5eed646c45d11d36beed4217b1682dd1ce89fcb12` |
| 首次回答 SHA256 | `42d3ffbfc45f5ffbed2299cf2079008d8a7d229dc891693452388834325308fe` |
| 修订版 SHA256 | `9c1cabac0d6bce9a605f69c6d91ac18c47b24c14e4168e3200ec78b829216d5a` |
| 事前评分卡 SHA256 | `3cd30ecd8e7d74bde1c1f6b7e8ae2d6174f17680b8fa46da63bda15ce1888992`；未修改 |

原件新建逐字节副本在 private/participant_evidence_v1.zip；不执行附件中的任何
脚本。原件、输入包、v1/v2/v3 包和根 Skill 均保持原字节。
细项见 [证据清单](evidence_inventory.json) 与 [机械核验结果](validation.json)。
哈希证明对应字节，不是来源认证、签名或对自然语言真实性的自动证明。

## 2. 实际参与者、环境与曝光

bx 在本聊天明确确认：操作人昵称 V，在另一台电脑上，由 AI 辅助作答；
作答前未看旧审查报告、答案或评分卡。原句及解释另存
[人工确认](operator_confirmation.json)，不冒称 V 的独立签名或改写原记录。

可见环境记录为 macOS 15.0.1 / ARM64，模型 gpt-6.1-sol、reasoning medium。
Python 3.14.5 是首次回答之后补记的当前版本，不追溯证明首次阶段版本未变；
temperature/top_p/seed 未提供，不猜填。V 是操作 AI 的人，不冒称十题均为手工独立求解。

输入 ZIP 不含 evaluator rubric、作者作答、单元测试目录或旧审查报告；但它
包含 Skill 的 casebook/参考资料和辅助器，这是本次处理的一部分，并非泄露
包外评分键。十题已在项目审查中曝光、与教学案例主题相关，不能称新的留出
测试。人工声明的“未看旧报告/答案”与实际读过包内 casebook 并不矛盾。

引用聊天的 read_thread 是为取得当前附件路径，可见返回为附件占位、引用
标记和路径，未见旧作答/评分卡正文。它与联网搜索不同，不声称整台电脑从未
联网，也不以仅有可见日志证明所有潜在背景均不存在。

## 3. 首次回答的逐项作者评分

| 题目 | 覆盖要点 | 作者得分 |
|---|---|---|
| t1 | 请求计时在 oracle 前结束；区分完整函数耗时；保留验证 | 4/4 |
| t2 | 块数不等于 DMA 启动数；嵌套计时、75 ms 差额与归因限制 | 4/4 |
| t3 | 160 ms 仍高于 150 ms；跨场和反事实条件；不写已胜出 | 4/4 |
| t4 | 4.5 J/220.5 J 仅算术；跨场功率与时间不能作实测分解 | 4/4 |
| t5 | 区分模型/权重/输入/预处理/平台；单例拒识不代表部署质量 | 4/4 |
| t6 | 追溯共同来源；意见重复不是独立验证；回到原始源码 | 4/4 |
| t7 | 13→11 ms、2 ms、15.38%；保留有限正面观察，不外推 | 4/4 |
| t8 | 更慢不必然更耗能；30/24 J 与 20%；合成与不确定度边界 | 4/4 |
| t9 | 无 BIT/HWH 不能静态检查；不因板卡连接而执行硬件 | 4/4 |
| t10 | raw INT32 GEMM 不适用于融合饱和 INT8；先补算术合同 | 4/4 |

完整 40 项、原英文标准、回答原句及理由在 [逐项评分](scorecard.md) /
[结构化评分](scorecard.json)。评分由作者人工完成，辅助脚本仅核对引用、身份
与汇总，不能独立判定自然语言正确性。40/40 不是模型准确率、任务自动通过率
或竞赛评分；也没有把一次会话的十题当作十个独立用户/十次独立试验。

## 4. 真实失败、修订和记录限制

- 首次可见阶段有 6 次 functions.exec、6 次 exec_command 和 1 次 read_thread；
  首个 exec 同时包含两种操作。首次回答误将两个 6 写成 5，修订版只修正这处
  统计，十题结论与其它字节均不变。首次回答与首次会话最终消息一致，未覆盖。
- 六个命令返回码依次为 1、0、0、0、0、0。首次空目录文件枚举的 exit 1 保留；
  随后用附件路径读到材料，不能把它改写成整次失败或删除该非零返回。
- 留档阶段有 StopIteration，原失败及修正说明保留。这不是附件 helper 的
  执行失败，helper、自检、原始源码和实板均未运行。
- 接口只提供合并 output，不伪造独立 stdout/stderr。可见首次阶段的六次
  调用均有对应返回；后续留档在明确快照时点停止，不声称无限延伸会话的
  全部历史都已导出。归档期的一处输出脱敏/截断也保留披露。
- 不要求内部系统/开发者指令、内部推理、账户资料或补造不存在的日志。
  原件含个人路径及会话标识，只作本地私有证据；不得直接上传公开 Git。

## 5. 已收口与未完成

已收口的是：V 的一次异机 AI 辅助 Skill 十题使用、输入/原件核对、操作人
人工确认、作者逐项评阅与原件留存。旧准备目录中的 not_run 模板保留历史字节，
当前结果以本新目录为准，不回写参与者原包或伪造其已填写的历史模板。

仍未完成或不在范围：

- 无 Skill 对照、独立评分、新留出题、重复使用与泛化评估；无收益百分比。
- 原矩阵 191 项异机复现、Mac 上的 90 项 helper 单测或任何新板测。
- FPGA-23 整体关闭、公开脱敏包/许可确认、安装、晋升、发布和默认替换。

本次没有新运行参与者模型、没有启动子 agent、没有改 Linear/Git 状态。
这些未完成项不冲销本次有限使用记录，也不被 40 分自动视为完成。
