cpfbx/OpenNPU-Lite-FPGA/report/evidence/e18.md

# 伙伴异机PC复现回执：191项范围核验通过

2026-10-20；回读Codex/root；项目负责人bx。

**结论：固定矩阵交付候选的191项PC测试、两个历史self-test和两种静态检查的
返回证据核对通过。bx已确认kakane在另一台电脑、由Codex(GPT-5)辅助执行。
这项异机PC复现已有回执，不再是“待伙伴执行”。**

## 1. 原件与范围

- 返回ZIP：24,328 B；本地SHA256
  `d25a431a37a4e0f554872955c9e4b02757cb25a03cdc4a6ee597cb4eb8c272e2`。
- 原件副本：`original_return.zip`；55个成员，解压内容总62,014 B。
- `return_manifest.json`索引其余54成员，字节数/SHA256/精确成员集合全部符合。
- 对应输入是 `opennpu_matrix_pc_reproduction_20261020_v2.zip`，SHA
  `4069ac943beb7a96590ecb44d3c5fd09b175608bb2a94614448d14c38036f586`。
- 操作者/异机/AI辅助由bx本轮确认；工具不认证物理电脑身份。原电脑端ZIP SHA
  尚未另外提供，因此没有把本地哈希说成已完成两端独立比对。此项不要求重跑。

回传日志保留原始字节，含当地用户目录，属于私有归档；公开前另作脱敏，不改原件。
此次只读回读，没有执行ZIP内命令，没有替伙伴重跑测试或访问开发板。

## 2. 日志中实际环境

| 字段 | 返回记录 |
| --- | --- |
| 操作者 | kakane（bx已确认） |
| 操作系统/架构 | Windows 11 / AMD64 |
| CPU信息 | Intel64 Family 6 Model 183 Stepping 1 |
| Python | CPython 3.13.5，MSC v.1943，64 bit |
| NumPy版本输出 | 2.5.4 |
| AI辅助 | Codex (GPT-5)，以参与者记录和bx确认为准，不认证具体模型后端 |
| 记录起止UTC | 2026-10-20T12:03:30.102650 至12:03:43.161382 |

版本按原日志记载，不把它换写成作者本机的Python3.12.14/NumPy2.3.5。
这里的PC日志耗时不作为FPGA、ARM请求或模型性能比较。

## 3. 六组测试逐项重算

| 分组 | 通过 | 失败/错误 | 跳过 |
| --- | ---: | ---: | ---: |
| diagnostic/adapter | 51 | 0 | 0 |
| energy | 80 | 0 | 0 |
| application_offline | 36 | 0 | 0 |
| test_chain_protocol | 6 | 0 | 0 |
| test_k_major | 13 | 0 | 0 |
| test_d007_mode11_contract | 5 | 0 | 0 |
| 合计 | 191 | 0 | 0 |

不只采信summary数字：从stderr逐行提取每个`... ok`测试ID，并从本地原始冻结输入
ZIP内测试源码的AST独立列出模块/类/方法。六组名称集合分别精确相等，数量和唯一性
一致，无缺项、重复或替代方法；每组原始终态为OK，真实退出码记录为0。

## 4. 身份、命令与静态检查

1. 本机重新核对输入v2 ZIP、内层两ZIP、两份manifest和strict helper身份。
   返回 `input_identity.json` 与这些锚点逐项相符：
   - matrix ZIP `8f95bd83...f23138a8`；内manifest `3495b774...24a4423`。
   - portable ZIP `71f3b785...0f76c7c5`；内manifest `a2ffb819...889fa9`。
   - strict helper `7374c958...257b92cc`；kit manifest `40e6bdb2...08164320`。
2. 17份独立receipt与summary内对应record逐项一致，key和次序与冻结入口相同，
   actual_exit_code均为整数0、accepted均为true。
3. 逐条比对解释器前缀、cwd、测试参数和identity参数；runtime `-c`程序与冻结源码
   中RUNTIME_PROBE完整字符串相同。回读没有执行这些argv。
4. 各记录UTC顺序和其单调计时elapsed相容；预检记录实际child PID相符、AMD64支持。
5. matrix前后输出均报告329成员精确；portable前后均报告13索引成员通过。
   两类前后输出各自相同；外层记录extracted_trees_unchanged/kit_unchanged=true。
   这是参与者运行记录，本机没有取得那台机器的整个解包目录重新逐字节扫描。
6. GEMM/韧性两个历史self-test分别输出PASS，exit0；分列，不混入191项计数。
7. legacy/strict静态输出分别exit0，BIT/HWH SHA与本地冻结资产相同：
   `47ae0a36...a20451c` / `d727688a...d747294`。
   strict匹配真实声明的axi_dma类型/VLNV，而非实例名子串；其输出仍明确没有验证
   地址映射、BIT载荷有效性、同次构建或硬件执行。

冻结matrix verifier内 `independent_third_party_reproduction=false` 是该静态校验器
自身固定的范围声明，不是检测电脑来源的传感器。不能用这个字段否定已由外层日志
和bx确认的本次异机执行，也不能把它改成true污染冻结原件。

## 5. 本地回读辅助器验证

`audit_return.py`只解析归档/JSON/源码AST，核验原始内容与固定调用规则。
18项作者回归覆盖：缺成员、坏哈希、bool伪装、非零退出、receipt/summary不一致、
改变命令/runtime程序、缺/重复/替代测试、伪self-test、类型子串冒充、外来输入身份、
伪board结果、重复JSON键和NaN。全部通过；不计入伙伴的191项。

首次作者脚本对strict的matches字段假设错误，exit1；源版本与原因保留在
`audit_return_attempt_01.py` / `author_attempt_01.md`。修正读取实际vlnv字段后核验通过，
不把这个作者缺陷记为参与者失败，不覆盖参与者结果。

返回清单解决字节完整性与内部一致性，不能认证日志真实性或抵御连同信任锚/工具的
整体伪造。执行人/异机情况采用bx确认，范围与来源分别记录。

## 6. 可用于报告的结论

> 由伙伴kakane在另一台Windows x86-64电脑、使用其Python3.13.5/NumPy2.5.4环境，
> 在AI辅助下完成固定交付包的191项PC测试，零失败、零跳过；同时完成两个历史
> 校验器自检及BIT/HWH静态检查。返回原始日志经本地成员哈希、逐命令与逐测试名称
> 核验通过，运行记录显示输入文件前后未变。此结果覆盖PC功能与静态检查范围。

这项结果不包含Vivado异机重建、另一块开发板验证、运行期DMA、性能/能量或新模型
质量评价；也不替代 `opennpu_diagnostic_review_20261020_package_02.zip` 的独立审查。
新flat候选和KWS数值归因仍等待该审查，未集成或晋升。

## 7. 下一步

异机PC复现这一项可按上述范围收口。继续回收新诊断审查包的审查意见，再更新报告
派生稿、候选包导航与样页；生产默认、官方提交口径和核心合并仍由bx批准。
