cpfbx/OpenNPU-Lite-FPGA/report/evidence/e20.md

# Pointwise12 实板回读独审：回件核验与收口

日期：2026-10-25，Asia/Shanghai。负责人、唯一实板操作者及最终批准者bx；回件只读核验为当前Codex会话。base fb6b2f7b94de81a821bb08ebde0660d12752ba66，分支codex/d007-c-buffer-feasibility，原工程改动保持，新文件仅本专题与project/current_plan.md。

结论：接受独审PASS，范围严格限于已完成的固定12窗、operator2单层Pointwise实板原件回读、数值/wire/计数以及正常退出清理证据。该阶段已收口，无需为本轮再上板。不是默认晋升、420窗质量、全模型PS/PL、性能能量、故障恢复或长稳认证，也不授权新范围。

## 回件与原对象身份

- 报告26252B，SHA256 `37d8233721b719ffd9389106a296c7b144d7e866b048f0a1010d39e2af2c8d82`。
- 日志ZIP760319B，SHA256 `dee65e8962cd7adf4d7d89c474ad987760744889a518d114ec3642ed1ac6ceba`，151成员/150索引。
- 日志MANIFEST28087B，SHA256 `78e1b9db892b5cdce7292ef02eab524ed65313166aba7b8ac91a7434e12b46d5`。CRC、全成员大小/SHA、路径/大小写唯一、普通文件/无链接及解包界全部核验通过。报告与ZIP原样复制留存。
- 被审原ZIP仍9191874B/301成员，SHA `9a28e1a58d0445261a369f55ee66a846e05153a42a7ce8172c978a290af7bf84`；300索引全字节及顶层fdc7a019…9e441重新核对一致。
- 原实板tar仍fba363e3…11177，返回日志中解包的123个文件逐个与原tar字节完全一致，含48份wire/数值二进制；没有替换原件。

## 本地核验实做

inspect_return.py、audit_return.py实际exit0，inspection.json及audit_01.json为结果。只检查既有文件/字节/源码AST，未执行回件脚本、未重新推理、未访问网络/板端/当前锁。

- 8条外层实际记录退出0/0/1/1/1/1/1/0，3条内层0/0/0；22份stdout/stderr大小及SHA全部匹配。
- 单测日志与本轮源码10个方法名逐一一致，0skip，不累计作者与独审复跑。
- Linux返回independent_audit.json与作者完整稳定结果一致，frozen_readback.json与原归档及作者回读全字节一致。
- 12行窗口摘要的source/job/计数/输出SHA与原件匹配。独立读取INT8字节核非负元素位置，第120窗确为(36,20)=15、(36,61)=0、(40,47)=11。
- 新增反例源码已完整阅读：6个直接数学/计数拒绝、6个reader子进程拒绝，12个case ID与summary逐一对应；6个reader均记exit2/ValueError及具体拒绝原因。重签raw反例确实同步更新result、worker清单、terminal、outer的child_terminal，仍记录命中固定golden门。
- 这些新增反例的捕获结果集中保存在summary；回件未附6个reader变异目录或各自独立stdout/stderr文件，脚本完成后删除了变异目录。故本地结论为“已核对源码及捕获结果记录”，不声称重新逐文件核对变异后的中间树或在本机新增12次实跑。

## 附件文稿勘误（保留报告原文）

1. worker/artifact_manifest.json实际索引 **98项**，不是85。构成为12份entered及各自ready共24项、worker ready及标记2项、12窗每窗4份二进制+result+标记共72项；合计98。原报告85漏计entered/ready的13个发布标记。清单本体与校验逻辑均正确，未删文件或放宽合同。
2. 作者与独审外层退出向量相同，但第6个负向对象不同：作者是包外篡改源码后的顶层身份拒绝，独审是audit_board指向已存在输出目录拒绝。可以分别陈述，不写成8条命令逐条完全相同；独审另有12个有价值的包外反例。
3. 新独立脚本extra06的注释写row37/col58，但执行代码动态选取第120窗第一个非负元素，实际summary及报告坐标为row36/col20，且是^1翻转15→14；不是注释所写的另一位置。执行结论不受此注释笔误影响。

上述均不改候选/原报告/原件，不需要重新打包已审v1。后续引用使用本收口记录及正确计数。

## 下一步

仅另做了冻结模型描述符只读盘点：共有pointwise算子2/4/6/8，本轮只验2；其余4/6/8形状同125×64×64，但参数、尺度及输入张量不同，中间穿插depthwise层，不能直接跳过拼接。没有新激活提取、推理、合同实现或测试。范围建议见next_scope_proposal.md，待bx决定。

无本地运行遗留、无提交推送/默认/系统修改。用户此前已获正常关机操作说明，但未贴回实际断电确认；本会话未查询当前通电状态。独审和下一步建议均无需板子通电。图表仍为后期文档待办。
