cpfbx/OpenNPU-Lite-FPGA/report/evidence/e20_op4.md

# Op4固定12窗实板原件独审回件：核验与收口

2026-10-25（Asia/Shanghai）。人类负责人及唯一实板操作者bx；离线作者与回件核验Codex /root。base fb6b2f7b94de81a821bb08ebde0660d12752ba66，原工作树/冻结资产不动，无提交推送。独立审查者以本次用户提供的报告、源码及日志为据，不补造人类审查签名。

接受本次 **Op4固定12窗单层实板原件离线审计范围的独立PASS**。作者原件、Linux复跑日志、完整数学结果及新反例源码对应，未发现需修改候选源码、重新封包或补跑实板的问题。本项待审收口；不代表默认晋升、完整420窗质量、端到端PS/PL部署、性能/能量收益或实板故障/长稳认证。

## 回件与原包核验

| 对象 | 实际身份 |
| --- | --- |
| 独审报告 | 25,788 B；SHA256 `1f6e87e8fb2e8cce9751a94ddb7db34c1a0eb301c5b4df71902e7502ba47a39e` |
| Linux回件ZIP | 22,101 B / 30成员、29索引；SHA256 `e4ddd617e18408731d1a86faf87ae40e3c798425c47f350a0fa69165bd889e38` |
| 回件MANIFEST | 5,014 B；SHA256 `38592ca801c6c8edd98252c42b3a74578347297ab77bd77f7c612b1d09bc5c86` |
| 被审原ZIP | 7,022,672 B / 360成员、359索引；SHA256 `d21871446cce08e89ede6b7ad19801c265e307dc3b08ffa932e5e64c3a691bb8` |
| 原顶层清单 | `9a588b1f53b3c5dbd7001ebe2869d2f74e60560b8a50539110e0e4285e6ebf23` |
| 实板tar原件 | 735,991 B / 123普通文件 / 1,190,751 B展开；SHA256 `8c5170ba7c635b80d599a4f3ea01925357070a6e309619b016da50fdea9a2ef7` |

inspect_return.py实际exit0，报告及ZIP原字节保全到本目录；安全路径、大小、SHA、CRC与30成员逐项校验。audit_return.py最终实际exit0，记录audit_02.receipt.json及audit_01/audit.json。新回件核验器初轮误用descriptor根字段而非info.operators导致KeyError/exit1，旧源码及错误原因保留在historical/；只修本地核验器字段访问，候选与原件没有改动。

实际核对：

- 8条外层退出码 `[0,0,1,1,1,1,1,0]`、3条内层 `[0,0,0]`，22份stdout/stderr完整流大小与SHA逐一匹配；5条负向命令的真实错误原因与对应源码门禁一致。
- 作者18个方法的AST与成功日志逐项对应、0skip；审查方新增12个方法本次附有完整源码，静态阅读与成功日志逐项对应、0skip。附件代码没有在本机执行，不把原审查方运行改写为本机运行。
- Linux independent_audit.json与已封主包作者完整数学JSON语义全等；frozen_readback.json及archived_readback.json与作者880B原件逐字节一致，SHA `70f3574ffda6fc28b4b74818126f624f56508f39d117c22b1ae23fe2ff92b022`。
- 回件日志ZIP不含48份Linux解包二进制本体；日志中的数值哈希与已持有实板原tar本体逐项核对，原tar48份wire/raw/PS/INT8本体与本层冻结黄金全字节一致。本轮没有重新推理、点积复算或另造独立语音样本；Linux运行记录与前轮作者实跑分别记载。
- 原运行ZIP209文件、当前kit及已封审查包对应成员全字节不变；201core与外部pin维持。固定12窗，raw/PS/INT8各96000，47个非负INT8值/窗120有19个且最大+76的结果对应。运行MODE11 version2/FFFF及软复位后version1的阶段区分不变。
- 作者外层便携补充日志未传给审查方，不伪称其被审查；主包已含完整作者三步产物，且Linux完成独立8+3复跑，故不以该可选附件缺失为理由重跑板测或重封。

## 数量笔误与其他非阻塞文字限定

1. **作者报告的85项应为98项。** 本次从实板tar原字节读取artifact_manifest.json（14168 B），其files精确98项=73个非.ready文件+25个.ready标记；worker总102文件，其余4份是artifact_manifest.json/.ready与terminal.json/.ready。原作者报告手工汇总漏计顶层ready.json.ready和12个entered_XX.json.ready。我承担该汇总笔误；数学审计器和冻结reader原有代码枚举全部98项，未漏校验。以后引用以98项为准。本勘误与独审一并归档，原report/ZIP/证据不改。
2. 独审报告写成`kit/core/site_readback.py`的位置应为 **`kit/site_readback.py`**。本次实际CLI与原运行包均使用后者，不是缺失源码。
3. 独审报告中将旧Op2举例写作tensor13→14不准确。冻结descriptor.info.operators[2]与real_case.py明确Op2输入 **tensor23**、输出 **tensor24**（权重18、bias6）；Op4仍是tensor25→26。审查反例使用13/14作为非法替换值可以测试拒绝，但不应称为真实Op2张量编号。该笔误不影响Op4身份验收。
4. 新增test_rc11虽以archive_traversal命名，实际方法体只测试重复JSON键和非有限数，未调用archive_data或构造tar路径穿越。按实际源码计为JSON解析反例，不扩大为新增tar穿越动态测试。原件路径检查、外层错误pin及目录拒绝各按其真实覆盖记录。
5. test_rc08/09针对冻结reader仅断言非零退出，返回未保留这两次子调用各自stdout/stderr；可确认对应破坏场景执行成功记录和源码，不补造更精确的独立拒绝原因。主包原18个审计器反例的具体assertRaisesRegex与日志可追溯。

以上均不阻塞限定PASS，不要求候选修改或新实板运行。SHA和进程记录仍仅证明所提供字节自洽；source_origin_authenticated/operator_exit_record_authenticated/promotion等false保持。

## 状态与后续

Op2、Op4现在分别完成固定12窗单层实板正确性与独审；尚未证明两层已经经真实跨层数据串联或全模型部署。当前板卡可以保持关闭，实际是否已关机未收到用户回报，不将关机建议记录成已执行。无SSH/Jupyter/UT70/实时锁/板卡/系统动作、提交推送或遗留本机核验进程。

下一步建议先按[next_scope_proposal.md](next_scope_proposal.md)确定跨层离线组合范围，避免连续重复单层板测；新实现范围由bx确认后推进。图表继续后置。
