cpfbx/OpenNPU-Lite-FPGA/report/evidence/e22_clarifications.md

# 独审回件表述补记（不改原件或PASS范围）

原MD与ZIP保全。本说明根据实际字节、已封包源码与Linux结构化回执澄清表述，不代表重跑审查或增加实验。

1. 用户贴文“768000＝256000×三处”不沿用。报告正文4.4及标量回执正确：8类各96000、共768000，仍只有固定12窗。
2. 报告清单表写kit_manifest为46356 B、core清单为44710 B；实际分别56272 B、53494 B。两SHA和成员数正确，属于表格字节数笔误。top MANIFEST 122957 B正确。
3. 报告称额外NumPy“矩阵/卷积”双重验证全部768000值，范围偏宽。reviewer_counterexamples.py的NumPy新增计算只有Op2/Op4 raw点积与校正四类；DW3与INT8重定量化的全8类检查来自既有独立标准库实现。动态字节等价和金标比较另列，不说存在未实现的额外NumPy DW3/量化复算。
4. “定点无符号右移舍入”应改为冻结整数重定量化及带符号双重舍入规则；device_math.quant对负数有明确处理，不能称普通无符号逻辑移位。
5. CE16注释称bias篡改后重算corrected/INT8自洽输出，但实际只将bias[0]加50000并重签元数据，未重新计算后续数值。因此保留“冻结参数篡改被拒绝”证据，不扩大为“自洽重算整个输出后的伪造被拒绝”。当前安全门与复算结果不受此文字差异影响。
6. 冻结reader反例原始结构化message只提供有界ValueError JSON；正文列的更具体内部原因，是对源码的解释，不是附件中实际留存的原始错误栈。CLI负例另有实际stderr末行。6个路径拒绝及ready/额外文件反例也不宜笼统说全部都进行了重签。
7. CE09/10源码做减1；按这次固定原件实际选中的index0值，CE09 raw 52133→52132、校正-8277→-8278、CE10累加-2131→-2132，各目标INT32实际均改变1 bit。因此本次bit微扰表述可以保留，但不将一般减1等同于恒为单比特操作，也不合并两目标成一次单bit修改。
8. seal_delivery.py只封主包；便携日志由交付目录外finish_delivery.py生成。不要写成主包内seal_delivery负责两ZIP。reviewer_summary的静态ARM字段字符串写line44，实际flags中该赋值在line39；报告主体对此锚点正确。
9. PASS结语“严禁运行态实锤”等模糊措辞不作为范围定义。本次有原件中的真实正常运行/MMIO/进程/锁证据；离线审查本身不再次访问硬件，不认证当前板态或来源，不证明全模型运行质量。
10. 含“bx亲自输入”的浏览器回读与授权说明按操作者声明与聊天授权理解；不把终端文本当作独立物理身份认证。原件source_origin_authenticated=false等保持。

以上均不要求修改v1冻结runtime/kit或重新上板。P3通用清理深层断言缺口独立列待办，本次实际字段已直接核实，不将“核实当前值”写成“已经修好通用验证器”。
