cpfbx/OpenNPU-Lite-FPGA/report/evidence/e25.md

# OpenNPU-Lite参赛设计报告正文审阅稿

版本：2026-10-19合稿01，Asia/Shanghai。项目负责人及唯一实板操作者：bx；材料整理：Codex/root。本文合并10/18骨干章节与定量增补，不新增实验，不改变冻结默认，不代表正式提交、评分承诺或已获公开批准。

**使用状态：** 这是一份可继续编辑和审阅的Markdown正文，不是已按官方Word/PDF模板套版的定稿。队员/指导教师、最终资产与源码版本、官方模板/规则逐条映射、图表排版及异机复现记录仍需补齐；未完成项不填造结果。来源索引见附录B。

## 摘要

OpenNPU-Lite面向PYNQ-Z2的资源约束，构建可编程INT8矩阵计算平台，以8×8计算阵列、矩阵分块、流内链式协议和软硬协同主机路径为主体，使用关键词识别验证真实音频应用接入。项目分别记录硬件工程签核、硬件执行窗口、完整请求和应用质量，避免以局部跑分替代端到端结论。

冻结D075工程在100 MHz下完成完整实现与重建核查，使用26,762 LUT、27,575 FF、11 BRAM和72 DSP，setup WNS为+0.118 ns、hold WHS为+0.066 ns。历史483调用实验中，请求内面板/布局复用将512³完整请求由714.535 ms降至284.216 ms，耗时减少约60.22%；该收益主要来自主机路径，而非阵列提频。后续优化ARM同场320调用表明：512³ FPGA完整请求279.358 ms，快于当场OpenBLAS单线程298.523 ms，但慢于双线程166.178 ms；256³同样不胜双线程。上述边界与原生构帧候选退步结果一并保留。

KWS单次实板诊断中，三层矩阵共4 job、237,440有效MAC，记录中的同输入CPU/FPGA十二个logits完全相同；预期yes被预测为off，低分拒识阻止了本次反馈。该案例证明一次工程链与错误提议拦截，不证明普遍零误触发或识别质量达标。正式能量、可部署拒识、连续监听与异机复现尚未验收。

关键词：INT8矩阵加速；PYNQ-Z2；数据布局；链式传输；软硬协同；可复现验证。

## 1. 目标与技术路线

### 1.1 项目定位

作品的核心是自研可编程矩阵加速平台，不是重新训练一个语音模型。我们关注三个工程问题：如何让有限阵列获得数据，如何减少接收、计算、存储之间的串行等待，以及硬件加速是否能在包含主机开销后形成实际收益。KWS承担应用接入与整数一致性验证，不用模型准确率替代矩阵性能。

目标硬件为PYNQ-Z2，使用Zynq-7000器件的ARM处理端与PL逻辑端协同工作。正文中的工程结果绑定Vivado 2026.1及冻结源码；板端记录绑定PYNQ 3.1.1、ARMv7环境与各自包身份。不同实验的BIT、模式和计时窗口分别列明，不把同名MODE当作跨版本身份依据。

### 1.2 软硬件职责

| 层次 | 职责 | 验证重点 |
|---|---|---|
| PL矩阵核 | 8×8计算阵列、分块协议、输入布局、流水重叠及支持的量化路径 | 数值、状态、周期守恒、完整实现时序 |
| ARM主机路径 | 操作数转换/面板构造、链头组织、缓冲区与提交/等待、结果重建 | 输入/输出身份、容量、生命周期、完整请求开销 |
| 应用与交互 | 音频采集/固定窗口、前处理、模型调用、拒识与反馈 | 同输入参考、错识别、动作隔离、停止和清理 |
| 证据与工具 | 归档、清单、只读校验与复现说明 | 真实退出、字节身份、失败保留、可复核范围 |

一项检查通过不自动替代另一项：数值精确不代表性能有益；时序通过不代表所有启动镜像安全；功能链闭合不代表分类正确或可部署。每次实验沿用事前合同，不在看到结果后改门限求通过。

## 2. 三项核心工程贡献

### 2.1 可重建的矩阵硬件实现

#### 2.1.1 结构与数据通路

冻结实现以8×8 OS计算阵列为基础，通过矩阵分块支持不止单一固定尺寸的工作负载。K-major 8-Bank接收布局改善输入提交方式，64B流内链头描述连续计算任务；解耦队列、首K覆写、输入预取及双C-Bank重叠针对串行开销逐步优化。工程中还保留定点融合/量化路径，但不声称全部功能在每个工作负载中同时启用。

这些是可追溯的实现与集成贡献，不据此宣称新的脉动阵列拓扑或学术首创。各项机制的实际收益回到对应版本的受控实验，而不是由结构名称推定。[S01、S02、S03、S04]

#### 2.1.2 分版本的单步收益

以下均为512³工作负载。每一行内部是同BIT对照；三行之间属于不同历史BIT。

| 机制与实验 | 观察值 | 单步收益 | 声明边界 |
|---|---|---|---|
| D006-2 K-major；BIT a2c87f45…；MODE3/5 | receive 4,790,400→530,560周期 | 接收阶段周期比9.02895054，约9.03×；DMA+PL 106.6868→63.9716 ms，约1.6677× | 9.03×不是整矩阵或应用加速比；非接收阶段保持相同 |
| D007-A2首K覆写；BIT18227653…；MODE7/9 | PL总周期4,239,808→3,977,664 | 每矩阵减少262,144周期，历史配对DMA+PL平均节约约2.601 ms | 是移除预清零的独立实验，不是当前D075新增成绩 |
| D007-P预取；BIT93316244…；MODE9/10 | PL总周期3,977,664→3,518,464 | 每矩阵减少459,200周期，历史配对DMA+PL平均节约约4.552 ms | 20个交替顺序配对、相同有效MAC；不是能量或KWS响应收益 |

三项周期节约不能相加，三个加速比不能连乘来代替D075实测；历史资源和时序也不能用最终D075表格替代。[S02、S03、S04]

#### 2.1.3 最终工程签核与重建

10/13独立干净目录按原构建入口完成综合、放置、布线及产物导出。47个构建输入字节一致，未复用旧IP/DCP输出。最终资源与自然时序如下。[S01]

| 指标 | 核查结果 |
|---|---:|
| 目标时钟 | 100 MHz |
| LUT / FF | 26,762 / 27,575 |
| BRAM / DSP | 11 / 72 |
| DSP网表拆解 | 64 PE＋7量化＋1计数 |
| setup WNS / TNS | +0.118 ns / 0 |
| hold WHS / THS | +0.066 ns / 0 |

重建BIT整文件SHA与历史BIT不同，但差异限于日期/时间头，4,045,564B配置载荷逐字节相同；HWH除根TIMESTAMP外XML相同。重建产物未自动部署替换板测BIT。

签核不等于零告警。报告保留2865条方法学和204条DRC条目，以及DDR preset相关Critical Warning和DMA RAM Advisory；152条TIMING-46均有对应setup/hold逐路径核查。不能据此宣称任意DDR电气、FSBL或BOOT用途已安全，也不为清空告警擅改约束。[S01]

### 2.2 有实证的主机路径改进

#### 2.2.1 从局部卸载到完整请求

硬件执行快，并不保证用户可见调用快。完整请求还包含转换、构帧、保护检查、缓冲区同步、提交/等待、计数读取和拆包。项目通过请求内A/B面板和不可变布局复用减少重复构造；不跨请求持有可变输入，也不将预打包移出计时窗口制造收益。

历史483调用中，7个形状、每形状20组正式输入按同日同会话配对比较ARM、原FPGA与cached FPGA。512³完整请求由714.535 ms降至284.216 ms，耗时减少60.2236%；DMA+PL由约31.018 ms变为31.079 ms，没有硬件窗口提速证据。主要收益来自主机路径，不是阵列提频或减少算法工作量。[S05]

#### 2.2.2 主机归因与未分配时间

从483归档原始calls.jsonl重算512³ cached的20个正式请求均值：[S05、S07]

| 观察窗口 | 均值ms | 与完整请求的关系 |
|---|---:|---|
| 事务构造 | 90.226 | 完整请求内的观测段 |
| owned submission | 139.246 | 内嵌DMA+PL约31.079 ms，不另相加 |
| record重建 | 29.746 | 完整请求内的观测段 |
| 输出拆包 | 18.769 | 完整请求内的观测段 |
| 完整请求 | 284.216 | 含其他未归入上述四段的开销 |

四段未舍入合计277.986213 ms，尚有约6.230266 ms未归入这四段。它们不是完整可加分区；既不重复添加31.079 ms，也不把剩余6.230 ms凭空归给某个函数。此归因来自483，不将它套作后续320的同场分解。

“耗时减少60.22%”不是“能耗下降60.22%”；284.216 ms适用于初始化后会话，不是一次性冷启动成本。

#### 2.2.3 原生构帧候选的负结果

native_prepared候选在PC局部C构帧上取得收益，但实板14调用功能核查后，7/7形状完整调用均更慢；512³由283.486 ms变为416.921 ms，增加约47.069%。新增适配与运行时核验抵消局部优化的可能性有源码依据，但没有ARM逐函数定量证据可把全部133.435 ms增量分配给某个函数。[S08]

因此保留该候选作为负面实证资产，停止其正式长测，不替换cached，不靠追加有利轮次改变裁决。它说明优化应面向完整请求及接口成本，而不只观察子步骤速度。

### 2.3 公平ARM基线与适用范围

#### 2.3.1 验证范围

历史483调用本地复算共25,434,228个INT32位置精确；后续优化ARM同场320调用进一步核对52,428,800个INT32位置。后者覆盖两个形状、四后端、128预热与192正式调用，每形状/后端24个正式样本，按8块配对组织，CPU子进程依次退出后切换。[S05、S06]

完整请求窗口包含该路径的转换/构帧/同步/提交/等待/拆包及既有调用内检查；不含进程启动/import、会话准备、外部INT64参考和证据落盘。它既不是整个测试历时，也不是纯PL时间。

#### 2.3.2 四后端同场结果

| 形状 | 当场旧NumPy均值ms | OpenBLAS1t均值ms | OpenBLAS2t均值ms | cached FPGA均值ms |
|---|---:|---:|---:|---:|
| 256³ | 62.668 | 41.687 | 24.672 | 51.667 |
| 512³ | 436.841 | 298.523 | 166.178 | 279.358 |

256³不胜1t和2t；512³相对1t为23/24配对更快、均值比约1.0686×，相对2t为0/24更快。2t是本场最快已测后端，不宣称覆盖了所有ARM实现的绝对最优。有限样本P95/max和8块探索统计不能改写成硬实时保证。[S06]

历史483对当场旧NumPy的1.159×/1.544×仍是有效历史事实，但不能用它概括成“胜优化ARM”。483的284.216 ms归因与320的279.358 ms不能跨场相减、拼接出新加速比。

#### 2.3.3 三层数字与CPU成本

| 数字层次 | 可以引用 | 不能替代 |
|---|---|---|
| 工程实现 | 资源、setup/hold与构建输入/载荷一致 | 应用速度、零告警或异机复现 |
| 矩阵内层 | 历史512³ MODE11 DMA+PL约31.262 ms、4.293 GMAC/s，1 MAC计一次 | 纯PL、完整请求、KWS响应或GOP/s |
| 完整请求 | 本场320四后端结果 | 冷启动、批吞吐、整板能量或普遍适用性 |

512³计算进程CPU时间为FPGA254.062 ms、2t ARM316.746 ms，前者少19.79%；256³为48.430 ms对42.092 ms，前者更多。该结果描述计算进程请求窗口，不证明整板节能、释放一整个核心或其他任务吞吐提高。[S06]

## 3. KWS应用接入：功能链与识别质量分别验收

### 3.1 单次受控路径

bx运行一次单次薄适配候选：私有arecord采集5秒、16 kHz、S16_LE双声道音频，事前固定左声道1.5..2.5秒窗口；暂时隔离指定USB HID接口后录音并恢复绑定，再执行ARM NativeVad、模型、同输入CPU核对、拒识控制器和最多一次虚拟反馈。没有事后搜索“最佳预测窗”，没有自动重试或物理动作。[S09]

该次推理三层矩阵为[49,64,70]、[1,128,128]和[1,12,128]，共4 job、237,440有效MAC。记录的CPU expected_logits、FPGA logits和pipeline logits十二值逐值相同，三份MODE11 v2计数摘要通过整数守恒检查。

### 3.2 实板记录与本地核对

| 已完成的该次工程诊断 | 明确未完成的验收 |
|---|---|
| 录音实际退出0、HID恢复、ARM VAD分析记录；一次推理与数值参考一致 | 私有音频的本地重新听辨、截窗/MFCC/VAD/模型重算 |
| outer 24/24检查为true；父进程真实wait退出0、进程组消失、终态/清理和原inode锁释放记录一致 | 当前OS/锁/板态重新探测及物理身份认证 |
| 非音频归档23 JSON/log，58项一致性检查与12项校验器回归通过 | 不把回归项数当板测次数；真实单次运行仅1次 |

本地不含原音或中间tile原始输出，因此不能将十二个记录值一致扩大为“所有中间INT32独立重算”。哈希绑定提供一致性，不是防伪签名。先前音频加载日志归因失败和FAT警告保留，本次未修复或重新判为通过。[S09]

### 3.3 错误提议拦截与未通过项

预期yes被模型预测为off。VAD记录为50帧中49帧有声、最长连续43帧；最大softmax分数约0.78756959，低于冻结0.95门限，唯一拒绝原因low_score，进入REJECTED终态，feedback_calls=0、virtual_feedback=[]。旧应用的“虚拟灯关闭”字段只是提议，没有绕过门控交付动作。[S09]

这一例可说明“本次低分错误提议被挡住”，不能说明准确率提高或普遍零误触发。softmax分数不是校准正确率。

既有420窗口评估仍无可部署拒识策略，冻结策略记录有5/120负例误动作及18.33个百分点正确命令损失；DS-CNN参考前处理候选的精确关口仍有47/420条、1,184/205,800个特征差异，未放宽容差。单次工程链成功不能冲销这些No-Go；deployable=false，连续监听和本次入口的实板停止注入未验收。[S10]

## 4. 验证、协作与可复现工具

### 4.1 证据链与真实纠错

每轮运行使用新目录，保存源码/构建/BIT-HWH/host/包/板卡声明与日志身份，保留失败、慢点、中止和未晋升裁决。板测由bx实际操作，离线实现与核对由Codex辅助；独立审查意见和用户合并/晋升决定分别记录，不用另一轮自述代替独立批准。

已记录的纠错案例包括C结果指针对齐UB、NumPy视图/容量/别名边界、一次性Receipt的输入对象绑定及PC局部收益被实板完整请求证伪。报告以对应原件说明“反例—修复或止损—复验”，不虚构手写比例、审查签名或得分。[S08、S11]

### 4.2 三个只读脚本与能力边界

| 脚本 | 工作范围 | 不证明什么 |
|---|---|---|
| inspect_overlay.py | BIT/HWH散列、HWH模块/地址、要求的类型片段 | 不加载Overlay，不证明运行期DMA或GEMM正确 |
| validate_gemm_evidence.py | GEMM记录schema、成功/计数/数值等字段检查；有self-test | 不为任意伪造JSON提供真实性证明 |
| validate_resilience_evidence.py | 长稳/恢复记录与相关失败字段检查；有self-test | 不以功能长稳抵消历史尾延迟失败 |

历史三类篡改副本分别设置success=false、timeouts=1和post_reset_exact=false，均被拒绝、exit1；正向历史检查及两个self-test通过，原件未改。应写“所测三类篡改被检出”，不写“可独立防伪”。同时替换文件与manifest或伪造自洽数据，不由SHA自动解决。[S12]

本轮在本机补做跨包静态检查：portable v2中的inspect读取329候选中现有同名BIT/HWH，要求axi_dma，实际exit0，BIT/HWH符合冻结SHA；随后两个包身份检查仍通过。该动作不需额外传包、不加载设备、未输出到包内，但尚不算异机验证。

### 4.3 三种复现层次

| 层次 | 已有证据 | 尚待完成 |
|---|---|---|
| PC离线 | 329成员内部候选同机干净目录191测试、身份检查及实际反例记录；Skill摘要可搬移 | 另一台电脑上的真实执行日志与问题回收 |
| 工程重建 | 10/13完整实现、47输入及配置载荷核查 | 不冒称另一名使用者或另一台机器已重建 |
| 实板诊断 | bx的483/320、16次短诊断及KWS单次原件，各有范围 | 不外推到第二块板、任意镜像、连续监听或正式能量 |

“同机干净目录通过”不等于“陌生使用者异机复现完成”。另一台PC可先验证167项标准库与24项NumPy测试、两项身份及测试后复验；不需要连接板卡或运行解压树中的Vivado构建脚本。详细命令见[异机复现交接单v2](reproduction_handoff_v2.md)。[S13]

## 5. 未完成项与交付安排

### 5.1 能量与测量边界

UT70保存、单位诊断及16次短包络已有记录；短诊断16/16、4,194,304个输出INT32位置精确、正常退出/清理通过。但实际late控制器的36/36是PC检查；263.5秒是包含稳定等待与传输/人工开销的PC标记观察包络，不是任务活动或硬件同步积分窗口。尚无正式等任务整板能量比较，不将包络能量除以N伪称精确单请求服务能量。[S14]

本轮批准的诊断可以收尾、不追加板测，但不能写成“全项目实板验收完成”。正式测量仍需要事前合同、仪表规格/误差、单一供电边界、窗口对齐与批准的新runner；本稿不自动启动该工作。

### 5.2 公开与版本决策

当前329文件包是内部候选，不是已获再分发批准的公开源码包。自有代码、OpenBLAS及包装、公开语音源窗、自训/上游权重、AMD生成物和原始日志应分别核定来源/许可/渠道；不能从数据集CC协议推导全部模型权重许可。私人原音、凭据及第三方研究全文不进入公开交付。

case_map仅登记当前名称，不是改名批准。若最终需要全小写迁移，应由bx决定，在另分支/快照更新引用并重新完成构建与身份验收，不修改当前冻结输入。公开仓库、比赛私有提交和内部复现的资产范围分别确认。[S15]

### 5.3 后续优先级与结论

先由bx协调既有FPGA-23负责人完成异机PC复现，再按资产待决表核定导出范围；本正文继续审稿、补模板及排版。没有新合并/晋升/公开或新的板测授权前，默认与冻结包保持不变。

项目目前最有证据支撑的贡献是：可重建矩阵硬件、请求内复用带来的完整请求改善，以及面对更强ARM基线仍保留负结果的验证体系。KWS证明应用接入与一次受控反馈链，但其识别/拒识质量仍有限。后续优化应围绕已有测量揭示的主机成本、并行开销与适用负载展开，而不是以模型训练掩盖矩阵核心问题。

## 附录A：身份与引用口径

| 对象 | 身份 / 说明 |
|---|---|
| 矩阵源码base | 35d4db623091dfc7a63459d07f04e4484dbbd999 |
| 应用源码base | 3c5934448946786c5eb3a2495c616c382fb5ab6a；不代表全部未提交候选均来自同一commit |
| 板测BIT | 47ae0a3640ef6d31db467118fd1822c04d465cd31171275fc04824824a20451c |
| 配套HWH | d727688adc43d526b853e158648023f230fab081dd84e2c8e86437c60d747294 |
| 329候选review_manifest | 3495b774c028d8b63a992870a34013bb8cb5519a691e4a43db66d8bc024a4423；不是ZIP SHA |
| KWS非音频归档 | 661ae0fdb33a3de12b72a2d025ded8d7884d3f466aad18132e193df3d8fa2dc2 |
| KWS核对报告 | 41a8d9a3600d17ad2872a0a940be98d0454d917c20e5e92ced16a035527f4138；不是上行归档SHA |

各原件的板卡身份声明、UTC偏差及未取回项以专题报告为准；散列不提供密码学签名或物理认证。不同诊断复用的操作数，不以累计检查次数冒称独立样本数。

## 附录B：本地证据来源索引

- S01：[完整工程签核与告警](../../.board-work/matrix-delivery-audit-20261012/docs/matrix_signoff_completion_2026-10-13.md)
- S02：[D006 K-major实板验证](../../.board-work/matrix-delivery-audit-20261012/docs/d006_k_major_validation_report_2026-09-20.md)
- S03：[D007-A2独立门记录](../../.board-work/matrix-delivery-audit-20261012/docs/d007_a2_promotion_2026-09-24.md)
- S04：[D007-P的20配对](../../.board-work/matrix-delivery-audit-20261012/docs/d007_p_margin_20_pair_board_result_2026-09-25.md)
- S05：[483完整请求与归因](../../.board-work/matrix-delivery-audit-20261012/docs/matrix_confirmation_board_result_2026-10-13.md)
- S06：[320优化ARM同场完整复算](../../.board-work/matrix-delivery-audit-20261012/docs/matrix_isolated_board_result_2026-10-17.md)
- S07：[定量来源与20请求归因重核](../delivery-closeout-20261018_02/quantitative_readback.json)
- S08：[native候选负结果](../../.board-work/matrix-delivery-audit-20261012/docs/matrix_native_board_result_2026-10-16.md)
- S09：[KWS单次非音频原件核对](../KWS-single-shot-board-20261018_01/board_no_audio_readback_2026-10-18.md)
- S10：[质量No-Go与当前执行计划](../../project/current_plan.md)
- S11：[原生候选实现与独立审查记录](../matrix-native-frame-20261016_01)
- S12：[只读校验器正反例实跑回执](../Skill-gemm-validate-20261018_01/execution_receipt.json)
- S13：[329候选及干净目录交接](../delivery-consolidation-20261018_01/handoff.md)
- S14：[16次实际版本及包络口径补正](../delivery-consolidation-20261018_01/run16_addendum.md)
- S15：[公开资产待决表](../delivery-closeout-20261018_02/publication_decisions.md)

## 附录C：合稿与审阅状态

本轮由Codex/root在bx批准的离线范围内合稿；引用既有实际执行与独立审查，不新增审查签名。原两份草稿、失败记录与冻结包均不覆盖。此稿未重新核对官方评分权重，不保证得分或获奖；未制作官方Word/PDF、PPT、视频或执行对外提交。若需删去内部执行信息，应另存公开派生稿并保留来源，不回写或清洗原件。
