cpfbx/OpenNPU-Lite-FPGA/report/evidence/e29.md

# 收尾补丁Linux独审回件：核对与计划收口

2026-10-27；负责人bx，离线收件核对Codex /root；base `fb6b2f7b94de81a821bb08ebde0660d12752ba66`。本轮用户要求阅读回件并更新最新计划，没有授权新增KWS开发或实板操作。

## 结论

接受 **cleanup补充审计器＋统一PC入口候选v1的限定范围独审PASS**。Linux新入口复跑待办关闭；原冻结`fpga_evidence.py`、候选包、数据、默认不改。进入完整工程导出与材料整合，不为可选提示重新封包，也不把此PASS当正式发布或晋升。

## 本机实际核对

`read_return.py`实际退出0，未执行附件代码、未重推理/点积。两份附件原字节保存在`original/`，46索引文件＋MANIFEST安全展开到`returned/`。

- MD：13959B，SHA256 `1d134040c12d9ff11ddcd0ebf9fb6bddb9e24b635b52898a0f67ea0cf9d95c9c`。
- ZIP：26280B/47成员，SHA256 `1d0443458be3dddfce1fb050d6c994f9c1877744482ecc46d75afd4b124f00ad`。
- 回件MANIFEST：`04ff51cf0851d94f0d36774223b5f9fa199b73fe0ec2c5c9172471207dcfa177`；所有成员集合/大小/SHA一致。
- 被审ZIP `aa998e54…c944`、candidate pin `b2b0fa1b…1c54`与本地封包/新源码逐字节对应。
- Linux PC回执9个真实子程序退出全0；cleanup日志21方法0skip、Skill日志90方法0skip；计数与stdout/回执一致。
- integrity两子程序退出0，不导入NumPy，明确未运行共享链算术/Skill。
- 共享回读内部3条真实子程序退出全0，stdout/stderr散列对应；1117B冻结reader逐字节同Windows/原件，二进制索引/metric/768000标量结果JSON全等，264份二进制本体未随此次小回件重复提供。
- 三CLI负例的具体错误流符合错误pin/已有输出/包内输出拒绝；报告声明外层退出1/1/1，但没有单独返回外层OS退出码汇总记录，不把文字再认证为原始wait证明。此边界不改变已有作者外层实跑及本次正常子程序实证，不要求再补一轮。

## 非阻塞文字限定

1. 报告所列frozen_readback SHA不是完整64位；机器文件实际为 `e4c98e6bb7eb975421a72c978f821a5f6dc92d2963d45e4298fece70cacf34ff`。以原字节计算值为准，收到报告原文不改。
2. “90项全通过”仅Linux本轮；原Windows85执行/5skip继续保留，不相互覆盖或累计成新方法数。
3. `-B`可避免此次Python运行生成pyc，不保证文件树永远不漂移。把推荐通过带`-B`入口运行的提示放入最终导出README，无需修改已审candidate或再次封包。
4. casefold冲突检查在ZIP unpack，tar校验没有同一casefold分支；原tar有外部固定pin。不能把合并描述当作21项已覆盖所有归档攻击面的实证。
5. Slice77.08%并不是已测拥塞率，也不能由此断言驻留必然导致时序失败；维持“需要独立设计/实现验证”的判断。国一/满分/头部等竞争预测不采纳，也不据此减少验证或保证比赛结果。

## 计划变更

新增工具独审关闭；文件整理关闭。工程导出、报告正文重构和核心图表资料整理前置。视频素材/脚本与实际上传规则尽早确认，海报为决赛项，等待AMD模板，不占用初赛报告/视频关键路径。

当前主计划不等待未批准的完整KWS混合推理；默认继续已有范围的交付整合。若bx另行选择补全，单列不改RTL/门限的纯离线功能合同，再决定是否增加实板；不能把第三方“半天可做”当工期保证或授权。

无提交/推送/默认动作，无板/锁/SSH/Jupyter/UT70/系统操作或本轮遗留验证进程。板卡电源未知；备份介质未提供，不声称独立备份完成。
