cpfbx/OpenNPU-Lite-FPGA/report/evidence/e30.md

# 固定12窗完整KWS混合推理候选 v1：Codex离线验收

2026-10-27。人类负责人及最终批准者：bx。作者按交回包声明为Gemini离线会话；独立源码审查、Windows复跑及新增标量复算：Codex /root。工程base为`fb6b2f7b94de81a821bb08ebde0660d12752ba66`，原分支/7项tracked差异保持；候选身份以本页完整外部pin为准。没有替作者签署人工贡献或独审。

## 裁决

**PASS，仅限已批准的固定12窗、完整WAV到tensor33分类及固定历史VAD侧输入门控的PC纯离线软件接线。**主数据流和验收硬门通过，无需Codex接管重写。本次并未把软件夹具变成真实PL执行，也不改变生产默认、质量准入或发布状态。

消息摘要和作者handoff中的身份表存在多处错误，正式引用须改用[本轮勘误表](errata.md)及真实清单。另留两项不阻断固定入口的代码观察：未使用的错误前置清单常量，以及测试专用VAD override缺少独立的canonical index核对。它们不能被写成“所有接口无问题”。

## 真实审查对象

- 原交回ZIP：`7,525,597 B`，SHA256 `9bf656729adb4fdd65f549b825c9c6bb66d5ca847352fc25e9f99504c4a96664`。
- 顶层清单：`181,376 B`，SHA256 `890807cd2e7f009c1d4cd50c0d8c478d2024f8c111db0779d9794a9810228eac`；837个索引文件加清单，共838个成员。
- 候选清单：`1,196 B`，SHA256 `e9fe21968e8ba302799d747e63bd0fc0f18dcc041ad741db141b731943e6a2d6`；4份Python源码、readme及清单。
- 收件前验证成员集合、尺寸、SHA、无别名/符号链接/加密/越界路径；原ZIP和handoff复制保留于`original/`。`received/`只读复核，未修改封包源码。
- 前置源从本机原始已封包handoff重新解包至`sources_01/`，使用真实前置清单pin `524927755ea6e403c834fee7a518a0c9d2816b499a305a2c154a27b32f55e357`；五份原始来源及完整库存核对通过。

## 实际执行及结果

Windows AMD64、Python 3.12.14、NumPy 2.3.5；所有候选Python使用`-I -B`，包外空cwd、新输出目录，无自动安装、自动重跑或强杀。

| 检查 | 真实结果 |
| --- | --- |
| `smoke1 / fixed12 / unit_tests` | 三个子进程退出码`0 / 0 / 0`；17个不同测试方法，0失败、0错误、0跳过 |
| 5项CLI拒绝 | 缺enable、错误manifest pin、既有输出、候选目录内输出、解包源内输出，退出码均为1 |
| 固定12窗完整图 | indices为`0,30,60,90,120,150,180,210,240,270,300,400`；5880个特征、144个logits与CPU420原件对应切片全字节相同 |
| 共享会话 | 一次start/close、24次交替调用、48个job且ID为1..48；12,288,000 Pointwise MAC，12次DW3共864,000含填充逻辑MAC；均为PC软件夹具 |
| 数值本体可复现性 | 737份二进制与作者Linux产物全字节一致：smoke1 35、fixed12 398、unit_tests 304；仅规范化随机临时目录名，不规范化内容 |
| 额外独立反例 | 7项拒绝检查通过：严格bool enable、禁止CPU代替Op2、禁止分派Op12、非owning后缀输入、DW3输出扰动、logit扰动、canonical VAD身份错配 |
| 原件守恒 | 对received及整个sources树运行前后库存核对相等；最终复核另见`final_verification.json` |

主复跑含oracle和负例的总耗时约146秒，仅是PC诊断执行记录，不是模型推理性能或ARM延迟指标。

数据入口为`Frontend.process`现算WAV特征。CPU前缀现算tensor22/23，SharedCall消费本窗动态tensor23；DW3消费Op2的返回24，Op4消费动态25；CPU后缀消费返回26，现算Op5..11至33。`derive`与CPU完整参考仅提供检查用oracle，没有将它们的中间输出或logits回填为被测结果。层间允许必要的owning复制；不因对象id变化推定数据断链。

## 独立标量复算

`independent_math.py`仅用标准库，**不导入候选或冻结参考计算函数**；从固定模型描述符和常量解码，使用Python整数卷积/深度卷积/FC、独立frexp乘数及双重舍入、池化和reshape，逐窗从候选特征重新执行Op0..11。该复算与被测链共享冻结参数和输入来源，不是独立训练模型或独立音频前端。

- 12个算子输出共865,680个值与保存字节全部一致；Op0..8各96,000，Op9/10各768，Op11为144。
- 九个卷积类算子及FC共864,144个中心化累加器重算；保存的PW校正、DW3及Op5累加器逐值相等，其余算子通过独立量化输出对比。
- 额外核对Op2/4共192,000个raw INT32，先于ReLU；48个wire job解码、权重及尾块61行有效+3行零填充均正确，wire输入等于独立上游动态结果。
- 264份中段产物与历史真实共享链tar逐字节相同；它只证明本轮离线输出与历史实板原件一致，不能据此称完整图又在板端执行。
- 特征总SHA：`5435a1342b7040b12fed5711a0e9c8e2197f3ded2ad343e467bc091d74bd1b5d`；logits总SHA：`aac5c4bda5d9124d49a09add9421f08e97475cbf740416a13bd419fb2641c19f`。

本复算器首轮错误沿用了实板status=5的假设，按冻结PC夹具应为status=4而失败；纠正的是审查器的范围假设，候选未修改。首轮日志`independent_math_initial_fixture_status_assumption.log`保留，修正后退出0。PC夹具周期/状态不冒充真实板端周期/状态。

## 分类、停止与不确定状态

8个正确命令窗放行；30(go→no)与150(on→down)按原low_score拒绝；300 unknown及400 silence按model_noncommand拒绝。这是已选固定12窗的原有结果重现，不是新准确率、盲测或质量改善。门控使用动态INT8 logits、原scale/zp、原policy及历史PCM绑定VAD；`vad_recomputed=false`。不执行量化SOFTMAX Op12/tensor34，不产生动作。

窗90 raw_fault、before-DW停止、unsafe START故障的完成数、返回数和permit数均按现合同通过；raw最低位翻转在ReLU前被拒绝。安全失败可close；unsafe保留held/未决资源、不伪造close/首错payload。unsafe使用显式有限软件钩子，没有执行真实无限驻留、真实故障恢复或板端锁测试。

## 保留观察与处理建议

1. **交付文本身份表错误，已附权威勘误。**原包未改，真实清单自洽；使用本轮勘误替代错误表，不必为改消息表重跑数值实验。作者handoff中“61行尾块+3行填充”应属于Pointwise分块；DW3的864,000逻辑MAC来自3×3 SAME卷积的边界填充，二者不是同一机制。
2. **非阻塞P3：`hybrid_contract.py:20`的`PREREQ_MANIFEST_SHA`字面量错误且未使用。**真实前置解包校验与运行中source anchors/库存正确，未使本轮漏验。以后整理源代码时删除或校正此死常量，并重新封印受影响清单；不静默改本次已审候选。
3. **非阻塞P3，仅限测试override接缝：`hybrid_graph.py:286`起的override分支。**同时将传入source/PCM身份与`vad_override`换成第30窗、但`cohort_index`仍为0时会接受，因为该分支只对照调用者给的身份。正常runner从固定cohort取身份、从canonical历史表取VAD，完全不传override；其错配确实被拒绝。若以后将此函数/override暴露给外部或新启动入口，必须先核对canonical记录的cohort/source/PCM及VAD内容，不能宣称此测试接口具备不可伪造血统。

## 对项目状态的实际改变

此前“完整新模型混合数据流尚未接通”现在应精确改为：**固定12窗完整WAV→CPU前缀→共享Op2→CPU DW3→共享Op4→CPU后缀→logits/分类及历史VAD门控，已完成PC离线动态接线与独立复算。**真实硬件证据仍只覆盖此前12窗中段共享链，尚未完成完整图的ARM/PL部署、420窗混跑质量、实时音频/VAD、性能或能量验收。

建议本轮KWS纯离线技术收尾到此，转向干净工程导出和报告第二版。无需因为收到新候选就自动追加板测；若bx确实决定补完整图实板证据，须另确认最小范围、修补测试override/启动合同、审查和单次执行方案。当前`deployable=false`、默认不变、无提交/推送/发布/晋升。

## 证据入口

- `intake.json`：包、清单、源码真实尺寸/SHA及AST定义。
- `review_execution_01/receipt.json`、`validation_01/receipt.json`：外层实际退出、三子命令、17方法及输入库存。
- `binary_comparison.json`：737份二进制比对索引。
- `independent_math.py / independent_math.json / independent_math.log`：独立标准库完整图复算。
- `reviewer_probes.py / reviewer_probes_01/receipt.json`：7项负例及override未拦截的真实观察。
- `original/`、`received/`：保留原件及解包副本；`sources_01/`为本轮独立解包。

所有本轮离线进程已完成；没有访问开发板或网络配置，板卡当前状态未观察。本页不是生产默认晋升或下一轮上板授权。
