cpfbx/OpenNPU-Lite-FPGA/report/evidence/e31.md

# 身份勘误：以实际封包字节为准

2026-10-27，Codex /root只读核对。原ZIP、清单、源码和作者handoff全部保留；本表替代消息摘要/原handoff中不正确的尺寸、哈希或不存在的源目录名称，不是对原包的静默修改。

| 真实路径 | Bytes | SHA256 |
| --- | ---: | --- |
| `MANIFEST.json` | 181,376 | `890807cd2e7f009c1d4cd50c0d8c478d2024f8c111db0779d9794a9810228eac` |
| `candidate/manifest.json` | 1,196 | `e9fe21968e8ba302799d747e63bd0fc0f18dcc041ad741db141b731943e6a2d6` |
| `candidate/hybrid_contract.py` | 15,868 | `34270040aafd6f0611732994eea8e6e0b86018a9b8c225f6611a739c726dbbef` |
| `candidate/hybrid_graph.py` | 41,527 | `249d220c773db2a720b339345d26617cf844fedf2f24040ede9509a1ebf10372` |
| `candidate/run_hybrid_candidate.py` | 8,918 | `6ee65e356f2f6edf204ce22673c52dfbf192fdd7e0d3e3adb19628168a446fa6` |
| `candidate/test_hybrid_candidate.py` | 19,391 | `e7a4de9c93fd6cd7539b34228e5fd884db2abdc1db2b01f8901a39f10c5d7ef1` |
| `candidate/readme.md` | 4,539 | `2fd691233c84a4487dc9a54ccb3ad9bedca5fa5eece94d569ccf2717adfbc0df` |
| `selection12.json` | 36,335 | `e96413b815827dcb82b5e51fa40144f3a6021fae15ca74973a6a2b2c97a3037a` |
| `cpu/review_manifest.json` | 119,944 | `19aa43c2d0964cd77de13c1964c251ae66176c3f644238a21beaf377479bf4ba` |
| `shared/kit_manifest.json` | 56,272 | `26747c4a3f4b31321708a0508c4a6d3111c5cb9e29faed997bba84f1b8bf5e03` |
| `shared/core/candidate_manifest.json` | 53,494 | `a9b97371db2cae602f1b500384c2f4063436e08772960f05d532dbc62686b403` |
| `quality/MANIFEST.json` | 18,770 | `263debd95a6872ddc3a31867819997a17b6bf6b647cebd21a0da1664c3d2fdcc` |
| `board_records/shared_board.tar.gz` | 1,956,826 | `7786d5eee69b1cd17c1296beee522d324ca5d7fff9cc3e6e1a3aea39010651b7` |
| `board_records/cpu420_board.tar.gz` | 196,310 | `5939c7c0ae2e565bc7e67cbd5e1b815e207db40961ed1a6972396fd05b64ccba` |
| `opennpu_kws_full_hybrid_prerequisites_v1.zip` | 22,120,547 | `fae95a89a7bbefc4a26f281e05997b1ff7df8e9b68d44735a954e61c6ac49bd4` |
| `bundle/manifest.json` | 2,978 | `524927755ea6e403c834fee7a518a0c9d2816b499a305a2c154a27b32f55e357` |

原文的`cpu/candidate_05/artifacts/manifest.json`及`shared/kws_op2_op4_shared_driver_v1/manifest.json`不是本次运行核验使用的实际清单路径。运行绑定以本表真实source anchors及五份原始bundle为准。

算术口径补充：61有效行+3零填充行属于两个Pointwise tile job的尾块；DW3为NHWC 3×3 SAME卷积，其864,000为12窗含空间边界填充的逻辑MAC。两者不能混写。

候选内部自称“independent CPU oracle”的Op0/1/5..11实际复用了同一个CPU算子函数，完整CPU参考infer只另核最终logits；本轮另加的标准库逐算子复算补强这一证据范围，不将原oracle误称算法独立。
