cpfbx/OpenNPU-Lite-FPGA/report/evidence/e34.md

# KWS本轮收口入口

2026-10-27。负责人及最终批准者bx；本轮文档、来源表与复现封装执行者Codex /root。授权来自bx确认“由你收口，原候选保持不动”后的同意。本轮是限定范围的文档与交付收口，不是整项目冻结或生产默认晋升。

## 已关闭的本轮事项

| 项目 | 当前结果 | 查阅入口 |
| --- | --- | --- |
| 完整离线混合图验收 | 固定12窗WAV→CPU前缀→夹具Op2→CPU DW3→夹具Op4→CPU后缀→tensor33/分类及历史VAD门控通过 | [审查报告](../KWS-full-hybrid-review-20261027_01/review.md) |
| 原件与数值身份 | 5份来源、候选清单及完整库存核对；737份二进制与作者一致，独立标量复算通过 | [审查记录入口](../KWS-full-hybrid-review-20261027_01/delivery.md) |
| 错误交接表 | 用真实封包尺寸/SHA替代摘要及handoff错误；原件不改 | [勘误表](../KWS-full-hybrid-review-20261027_01/errata.md) |
| 报告文字 | 形成第8章增补及第9/11/12章修订用稿，明确离线、真实中段与CPU420的区别 | [第二版KWS用稿](report_kws_update.md) |
| 复现入口 | 默认只核验、显式启用才运行的PC入口；两个原包必需，使用新目录，无板测分支 | [命令与环境](reproduce.md) |
| 来源映射 | 主张、实际文件路径、完整pin与适用边界集中登记 | [来源表](source_register.json) |
| 计划与账本 | 当前成果/交付总导航同步；旧报告、旧ZIP及历史日志不覆盖 | [最新计划](../../project/current_plan.md) |

实现者按原交回声明为Gemini外部离线会话；Codex负责独立离线验收及本轮收口。Codex未重写候选，没有将作者自测算作另一组独立样本。

## 统一采用的技术事实

> 在保持模型、量化规则、共享驱动及门控策略不变的条件下，固定12窗完整KWS混合候选实现了WAV前处理、CPU前缀、共享Op2、CPU depthwise3、共享Op4、CPU后缀至INT8 logits及分类/历史VAD门控的PC离线动态闭合。5880个特征和144个logits与CPU420留存对应切片相同，完整Op0..11另经标准库标量复算。
>
> 真实板端证据仍限定于此前固定12窗Op2→ARM DW3→Op4共享中段及CPU420参考；完整混合图尚未实板部署。本轮VAD未重算，也未验证实时性、420窗混跑质量、新性能或能量收益。

此段是内部事实用稿，最终对外提交与冻结仍由bx确认。不要将“端到端离线数据流完整”缩写成“全模型FPGA部署成功”。

## 尚未关闭的限制与处置

| 项目 | 当前处置 | 再进入实施的条件 |
| --- | --- | --- |
| 未使用的错误前置清单常量 | 非阻塞P3，原候选保持；未影响真实source anchors校验 | 后续确需整理源码时校正/删除，重签受影响清单并审查 |
| 测试VAD override缺canonical index核对 | 非阻塞P3，正常固定runner不使用override；复现封装不暴露该接缝 | 将此函数扩为外部API或新板端入口前先补强、反例验证及审查 |
| 完整图实板运行 | 未运行，未安排 | bx另批具体范围、入口和单次执行方案；不从本次收口推导上板授权 |
| 实时音频和NativeVAD移植 | 未完成；历史VAD重放明确标记 | 独立范围与预算，不进入当前材料收口的隐含承诺 |
| 新模型质量准入 | 仍未通过；12窗重现不改变383/420及原门控统计 | 新的质量合同与独立数据验证，不能靠改摘要或阈值补成通过 |
| 全图性能、能量、恢复与长稳 | 本轮未测 | 按各自版本和计时/测量合同另立范围；不继承中段或旧模型结果 |
| 发布许可、正式工程导出和材料 | 项目材料阶段继续处理 | 完整KWS离线验收不代替公开授权或最终提交验收 |

“待修项明确保留”不是宣称问题已修，也不代表接受将有缺口的测试接口暴露给生产。当前只停止扩展本轮纯离线候选，不新增一般化接口。

## 已留存的失败与观察

作者历史原件、负例、raw_fault/stop/unsafe及审查方首轮夹具status假设错误日志均留在原目录。审查方VAD override未拦截观察也保留，未改写为负例通过。17方法、7项新增拒绝检查及标量复算分开陈述，不累计成“更多独立样本”。

## 后续交付顺序

KWS本轮纯离线技术与文档收口到此，下一步继续干净工程导出、报告第二版合稿、正式图表和视频素材整合。第一版报告继续作为历史审阅基线，KWS更新稿在第二版合稿时纳入。正式Word/PDF与最终视频排版另在材料阶段核验；不因收口再打开RTL、前处理重写或新板测。

[验证记录](validation.json)记录本轮文档链接、来源文件、第一版报告/已审包守恒及新复现入口冒烟的实际结果。没有Git提交、推送、外发、合并或默认变更；板卡状态未观察。
