cpfbx/OpenNPU-Lite-FPGA/report/evidence/e35.md

# 主张、原件与资源代价来源表

2026-10-27。配套 `preservation_index.json` 索引60份已选来源/关键原件/既有修改快照，逐字节同盘保全。它不是全仓库或独立介质备份。来源报告不自动替代其中所指的原始数据；下面区分直接报表、已完成审计及理论推导。

## 工程资源与硬件身份

| 版本 | LUT | FF | BRAM Tile | DSP | 来源与身份层级 |
| --- | ---: | ---: | ---: | ---: | --- |
| D007-P / D074 | 24289 | 25050 | 7 | 72 | `metrics/d007_p_margin_promotion_20260926/gemm_accelerator_implementation_utilization.rpt`：本轮直接解析完整overlay、Physopt postRoute报表；Vivado2026.1、xc7z020clg400-1；源码`211ed37ec016a8c16a5da97b2882cf90187125cc`、BIT `93316244…e2aef`由已保全跨BIT报告绑定 |
| D075 | 26762 | 27575 | 11 | 72 | `metrics/mode11_preflight_20260930/gemm_accelerator_implementation_utilization.rpt`：本轮同样直接解析；源码`35d4db623091dfc7a63459d07f04e4484dbbd999`；BIT `47ae0a3640ef6d31db467118fd1822c04d465cd31171275fc04824824a20451c` |
| P→D075集成增量 | +2473 | +2525 | +4 | 0 | 两套集成实现之差，不是“仅双bank/仅计数器”面积消融，不能全部归到一个机制 |

两份完整rpt已原字节复制在 `preserved/metrics/`，完整SHA和直接解析值在 `resource_sources.json`。D075 HWH `d727688adc43d526b853e158648023f230fab081dd84e2c8e86437c60d747294`；100MHz、WNS+0.118ns/WHS+0.066ns由已有完整签核证据支持，本轮未重新实现或签核。当前Git HEAD不是这两份硬件源commit。

D006/A2等较早资源行已有报告记录，最终表格若采用必须继续指向各自完整实现报告与包，不把本表的两份直接解析报表说成所有历史版本均已重新审计。

## 实测主张及可追溯入口

以下报告的完整大小/SHA和原字节副本均在保全索引。第一版报告的 `source_manifest.json` 33项是现有报告主张映射；本表对交付关键行进一步限定。

| 可写主张 | 来源 | 必须同时写的范围 |
| --- | --- | --- |
| 10/21 flat：512³ 272.11→242.82ms，−10.76% | `.offline-results/matrix-threeway-board-20261021_01/board_result_2026-10-21.md`；原tar `d4358fe8…8bca` | 本轮同场old/flat/CPU；256³无改善，不外推跨日 |
| 10/22 contiguous：256³ −10.32%、512³ −9.54% | `.offline-results/matrix-panel-board-20261022_01/board_result_2026-10-22.md`；原tar `79a6640a…8a78` | 相对该日flat；两日改善不相乘，候选非默认 |
| 最终能量Wh均值CPU262.6938J、FPGA258.9786J，低1.4143%；积分低1.3989% | `.offline-results/candidate-energy-board-readback-20261024_01/report.md`及独审回读；原tar `0958892f…01ff` | 单组ABBA完整保存包络，非纯PL/稳定节能/误差认证；1808正式调用不是1808个独立能量样本 |
| 能量场次完整请求FPGA220.4783ms、CPU170.5267ms | 同上 | 当场仍慢约29.29%，不换用另一日CPU成绩 |
| 新CPU420：205800特征及5040logits对齐，参考约3191.233ms/1s音频窗 | `.offline-results/KWS-arm-cpu-board-readback-20261023_01/report.md`；原tar `5939c7c0…ccba` | 参考执行非优化部署延迟；质量门未验收通过 |
| 新DS-CNN原始383/420、门控214/300目标正确接受 | `.offline-results/KWS-dscnn-quality-return-20261022_01/review_readback.md` | 固定复用数据集，不是新独立盲测；不以原始准确率代替门控质量 |
| 单共享实板会话12窗、24次PW、48jobs、768000标量一致 | `.offline-results/KWS-shared-board-readback-20261026_01/report.md`与27日独审回件；原tar `7786d5ee…51b7` | Op2→CPU DW3→Op4部分链；正常退出/同inode释放，非420全模型/新性能能量或长稳 |
| Skill脚本和复用经验 | `.offline-results/skill-authoring-20261020_03/`、`.offline-results/skill-use-v-closeout-20261020_01/closeout_report.md` | 原Linux90项0skip是历史结果；本轮Windows入口85执行、5平台跳过，非陌生用户盲测或Skill因果增益 |
| kakane构建原ZIP传输一致 | `.offline-results/hardware-source-hash-confirmation-20261022_01/confirmation.json`及ZIP `3df2e62e…4bd9` | 仅该ZIP；不自动补齐其他返回包的源端证明，BIT头变化与payload一致分别说明 |

## 理论/布局推导（不是新增测量）

64个PE、100MHz按每PE每周期1 MAC计，理论峰值6.4GMAC/s；不是72个DSP都作阵列MAC。512³有134217728 MAC，理想2097152周期/20.97152ms；用既有3004483周期窗口可得69.8008%的有效峰值比，不能称直接测到PE繁忙率。

512³原始两输入共524288B、INT32输出1048576B；现有面板链payload4194304B+header4096B=4198400B，1024个wire面板出现次数不等于1024次独立打包（请求内64A+64B缓存）。相应算术强度：只算输入256MAC/B，必要输入+输出85.3333MAC/B，实际wire输入+输出25.5800MAC/B；画Roofline必须说明采用哪个带宽/流量边界，不能混用。

完整理论数表仍引用 `.offline-results/report-review-assessment-20261027_01/derived_facts.json`，最终图表按原公式重新生成并核对。32,000B的Pointwise回包是8,000个INT32，不是32,000个整数。时间分解只画互斥外层阶段加残差，嵌套DMA窗口不再重复累加。
