cpfbx/OpenNPU-Lite-FPGA/report/evidence/e40.md

# E40 函数级实现要求与审查记录

团队通过接口设计、函数级要求、代码审查与测试反馈参与实现，模型辅助完成候选代码、脚本和反例。本记录按工程要求与实现结果组织。

## 运行期参考绑定

参考绑定任务明确检查四处直接或间接调用：窗口数据派生、调用对象构造、make_jobs及调用执行入口。团队要求沿用冷进程阶段校验并绑定的CPU参考，保留模块身份、数学与计数检查；异常出口按资源初始化前、窗口派生、调用构造和调用执行分段，诊断仅保留受限ASCII摘要。模型辅助实现绑定和顺序回归，团队依据审查及回归反馈组织修订。

## 动态三算子组合

团队确定Op2→CPU depthwise3→Op4的数据流，要求下游消费前层实际输出。离线组合分别核对历史Op2实板输出重放和当前PC夹具输出；中间按NHWC形状执行DW3，再形成独立拥有内存的Op4输入包络。传输帧逆解码与上游扰动反例用于检查动态依赖，黄金张量作为事后核对对象。该路线随后推进到固定12窗真实共享会话。

## 构建、调试与采用判断

构建成员在另一电脑建立CMD/BAT调用入口并执行完整构建，核对时序、资源、配置载荷和来源端哈希。复现成员在另一电脑使用Skill处理既有案例。负责人组织现场接线、计划核对及主要板测，依据代码审查、测试输出和性能分解确定修订方向及采用取舍。编程模型承担相应候选实现和分析的辅助工作，团队将各阶段结果汇总为工程交付。
