cpfbx/OpenNPU-Lite-FPGA/report/evidence/e41.md

# E41 原生工程图件与固定用例重放

2026-10-30在隔离目录重放4个固定测试台，编译、展开与运行共9条命令实际退出0。PE单元30项、AXI包保护21项检查通过；双C-bank用例核对2个tile、64个输出拍、16次有效重叠事件与2次计算完成，fail=0。另一个历史独立阵列用例为4×4，不用作8×8图的来源。

正文8×8波形来自固定核心M=N=8、K=1的两组外积。首组激活为1、次组为2，权重行为1至8。PE(0,0)输入、乘积与累加时刻分别为1005、1015、1025 ns，PE(7,7)为1145、1155、1165 ns。背压期间输出数据保持，有效握手后计数推进。

D075路由检查点中的额外0.060 ns最小延迟要求对应WHS=+0.006 ns；原自然约束签核报告对应+0.066 ns，两者分别解释。72个DSP按对象及互不重复物理站点分为64个PE、7个量化乘法器和1个工作量计数器。

原生截图与SVG/PDF保存在native_assets；图像没有用生成模型替代。报告使用固定D075硬件，本轮未启动新板测、综合或实现。
