cpfbx/OpenNPU-Lite-FPGA/report/evidence/e42.md

# E42 连续演示原件与软件运行画面

2026年10月31日在同一启动会话中完成矩阵测试和共享KWS中段，操作者为项目负责人。此次材料工作只读取已取回原件并从用户提供的原始录像提帧。

## 原件身份

- 运行归档：`filming_return_fcedbbad093340099c08a61909f4521b.tar.gz`，8,004,331 B。
- SHA256：`20a2cea129b6afad18c71408487578afe35e4241521ab233b694265c8214b19a`。
- 427项清单成员全部按字节数和SHA256复核；加上清单本身，共428个普通文件。
- 原始录屏SHA256：`90dfc461458659aa04c438244b67330dbc527b6a62aad6f938302e5de8525d1e`。
- 原始手机录像SHA256：`43ae6906842346e07b220de32d55b6e5805bf153b56b0b68ef1d03aa63ca22ac`。

## 原始技术回执

随附JSON从归档按原字节复制：[矩阵回读](e42/matrix_readback.json)、[矩阵外层观察](e42/matrix_outer_receipt.json)、[矩阵轮次回执](e42/matrix_round_receipt.json)、[共享回读](e42/shared_readback.json)、[共享外层观察](e42/shared_outer_receipt.json)。矩阵与共享启动器退出码均为0。矩阵开始05:37:07 UTC，共享开始05:41:30 UTC，归档结束05:46:12 UTC；boot_id为e950d085-4367-4d67-ac96-2e2be7ccfe9a。

矩阵共72次调用（24预热、48正式），六组各8次正式。同场256³基线57.601183875 ms、连续面板51.741560625 ms、双线程OpenBLAS25.073476875 ms；512³分别为261.115337375 ms、238.187774250 ms、166.294665250 ms。按未舍入均值计算，两种尺寸分别改善10.17%与8.78%。本组为10月31日独立复现，历史10月21日、22日数据保留。

共享中段完成12窗、24次请求、48个job。Op2的raw／校正／INT8、DW3的累加器／INT8、Op4的raw／校正／INT8共八类，每类96,000值，合计768,000个检查点。此处回读逐字节核验保存的黄金结果；独立全点积复算引用既有专题审查。分类质量与能量采用各自实验口径。

## 截图与排版

原始录屏04:15、09:39、10:10分别用于运行图1、2、3。报告使用Word原生图像裁剪，仅取连续矩形区域；未重绘、拼接或修改终端文字。完整原帧随附在run_assets中，可放大对照。手机录像09:28提取3840×2160原帧，按文件显示旋转恢复正向，用于系统斜视展示；拍摄角度未作精确测量，不作45度标定结论。图件SHA和Word裁剪像素范围见[运行截图来源](../run_source_index.json)。

回读JSON的hardware_access=false描述离线回读步骤。实际执行与清理状态由矩阵round_receipt和共享outer_receipt记录。该组用于本次演示复现，不替代历史性能、能量或完整模型质量实验。
