cpfbx/OpenNPU-Lite-FPGA/skill/development_record.md

# Skill 研发协作与纠错技术摘要

本文件包含研发技术摘要与经负责人要求整理的实际技术交互节选；完整会话由项目负责人保管。
负责人确定可复用任务、提交检查意见并验收范围；辅助编程模型编写文档、检查脚本和反例并执行离线核验。贡献按实际工作记录，不以提交账号推断逐行作者。

## 从失败提炼检查规则

1. 将 Overlay 身份检查、GEMM 证据校验和工程证据审阅拆为三个独立工作流，按任务选择入口。
2. 修正对假 DMA、错配 BIT/HWH 和不完整回执的处理；数值、状态、时序和清理分别验收。
3. 补充换行、路径逃逸、符号链接及 Windows reparse 边界测试，输出目录与只读输入分离。
4. 将计时分为完整请求、主机准备和硬件执行等口径，防止跨场次归因和重复计数。
5. 保留 v2 Linux/gVisor 的 82 项测试中 81 通过、1 项旧异常文案断言失败、0 跳过的历史结果；该次失败未改写成通过。v3 同步断言并补入非 BIT 输入与 JSON 错误出口检查。

## 使用与验收

`verify_candidate.py` 校验本发布副本的文件集合与 SHA256；`tests/run_tests.py` 和三个 Skill 下的自检验证软件边界。实际命令、退出码和平台跳过统计写入包外复现目录。
前述摘要归纳需求、实现、纠错与验收关系；下文三例展示团队提示词、模型答复和自我修订；原始要求单独保全。

# 团队主导的人机协作记录

团队从源码核查和测试结果中选择问题，提出接口级要求，并据此组织实现与验收。以下三例依据实际交互整理，对措辞和重复内容作编辑性归并；后续发现按实际先后记录。原始节选及索引单独保留，便于核对。

## C01　先弄清计时边界，再决定改哪里（2026-10-20）

负责人汇总源码核查与审查意见，把优化问题落实到事务构造、构帧和记录重建。模型随后收紧差额的解释，避免把嵌套计时差额全部归到一个函数。

**团队提示词**

先检查事务构造、pack_chain和记录重建，找出每次请求里重复创建对象、遍历内容或拷贝数据的位置。对照源码核准各段计时的起止点，再提出保持计算和验证语义不变的小改动。旧驱动保留，新方案和旧方案、当场OpenBLAS双线程按同一完整请求口径比较。

**模型对归因边界的修正**

> 约 88.7 ms 是两个嵌套计时窗口之间的差额

**模型安排的实现步骤**

> 先读相关调用链，再提出最小改动，不直接重写驱动。

团队据此以互斥外层阶段和嵌套窗口组织诊断。10/21的flat构帧与10/22的连续面板分别进行同场验证，实测结果见性能章节；不将两个场次连乘。来源：E17、E27、E38、E39。

## C02　把首错保留落实到函数参数（2026-10-21）

负责人采纳并提交代码级接线意见，要求把完整输出连同摘要交给协调器。该指令明确了下一次请求能否启动的判断位置，也让反例能够检查失败数据是否真正留存。

**团队提示词**

输出返回后，先计算digest = hashlib.sha256(output.astype('<i4', copy=False).tobytes()).hexdigest()，把(spec, result, digest, output)一起交给RoundCoordinator.accept，让内部verify_output核对完整输出。要让RetainedOutputs在纯数值不匹配时也能留下首份.bin，核对完成后再允许下一次请求。旧、新后端沿用runner_type切换，硬件计数器和安全检查保持原样。

**模型的答复与判定修正**

> 我会按前两点推进第四阶段的离线接线，保持旧驱动、安全门禁和冻结包不变。第三点会拆成两层判定：正确性、退出与清理是硬门；性能按同场实测单独报告。“同量级”或优于历史负结果不能预先算性能通过，拷贝量也不直接换算成收益。

**模型对全量核对顺序的落实**

> 已确认三后端比较层已有旧／新 `runner_type` 选择逻辑，我会沿用它。接下来补 FPGA 块执行器的逐次握手和父进程退出观察，让每次输出先进入统一全量核对，再允许下一次请求；同时验证纯数值错误能留下首错输出。

接线候选完成306项历史离线测试及12个真实PC子进程演练。首错输出、停止与退出观察分别验收；该阶段的硬件、MMIO/DMA和规范锁均为软件夹具。来源：E17、E38；matrix-threeway-runtime-20261021_01。

## C03　四处调用覆盖与两次实现修正（2026-10-24）

实板失败诊断把问题指向参考模块的冷绑定与运行期导入顺序。负责人采用诊断方案，进一步提交四处调用点及受限错误阶段的清单。下面按原时间顺序呈现这一次要求及模型连续反馈，包含首轮测试发现的问题和封包复查后的补测。

**团队提示词**

请把四处sources()调用都查到：worker派生、调用对象构造、make_jobs和执行入口。参考模块在导入pynq之前先校验、绑定，owner启动后使用这份绑定，保留对tensorflow、tflite_runtime及同名异路径模块的检查。原数学、计数、监督和锁合同不变。补齐冷绑定后pynq持续驻留的12窗完整顺序测试；报错时写清发生阶段，诊断只留有界ASCII摘要，不含环境变量、凭据或未受限栈帧。

**11:07 UTC　模型确认实现范围**

> 我会按已批准范围实现新版本，覆盖你列出的四处运行期调用点，并补齐阶段诊断和初始化后的 12 窗顺序测试。原包与失败原件保持不变；完成离线验证后整理交审，不启动板测。

**11:11 UTC　模型完成第一版接线**

> 实现已把运行时参考函数放入独立命名空间，原离线函数及其禁止 `pynq` 的保护保持不变。运行时只有在核对已初始化 owner 与其持有的 PYNQ 模块对象一致后才允许调用参考函数。接下来验证四处调用点，并检查原函数的代码和全局绑定没有被改写。

**11:15 UTC　首轮测试发现引用问题并修正**

> 新增的 20 项测试已全部通过，包括持续保留模拟 `pynq` 模块时的 12 窗完整调用，以及第 4 窗数值故障、参考构造故障和调用构造故障后的清理检查。首轮测试也暴露并修正了一个模块引用可能间接保留 owner 的问题，失败日志已保留。现在继续跑既有回归；这些仍是电脑上的软件夹具，不算实板通过。

**11:25 UTC　封包复查发现采集顺序问题**

> 完整离线检查已通过，正在复核实际打包的 ZIP。复查资源路径时还发现一个需要补强的细节：owner 初始化成功后，应先保存原锁 ticket，再做新增的参考绑定授权检查，确保授权失败也能留下完整清理证据。我会补上这条反例后再交付；当前不需要你在板端操作。

**11:31 UTC　补充反例与最终回归**

> 补充反例已通过：新增授权检查失败时，仍保留原锁 ticket 和 `closed_owner` 清理证据。最终稿现在共 224 个不同测试方法，正在实际 ZIP 解包后的空目录中做最后复核。交审材料会明确区分原失败、前一作者稿和这份最终稿，避免混用哈希。

第一项修正处理模块引用间接保留owner的问题；第二项把锁ticket采集前移到新增授权检查之前，使授权失败也能留下清理证据。模型依据团队列定的四处路径实现并自检，团队再将候选交独立审查。最终224个不同测试方法通过、0跳过；这组记录属于离线修补，后续实板成绩单列。来源：E40；KWS-pointwise-runtime-binding-20261024_02。

## 团队的判断与实现参与

团队把优化方向拆解到具体函数、参数和测试顺序。完整输出传递的调用示例明确了协调器的验收接口，四处sources()清单限定了运行期接线覆盖；构建成员完成异机构建与来源核对，负责人组织现场验证并决定采用范围。模型据此编写候选、脚本和反例，保留实现错误及补测结果。
