cpfbx/OpenNPU-Lite-FPGA/src/matrix_runtime/contract.md

# PANEL72：固定同场完整请求延迟诊断

bx唯一实板操作者。准备包不代表已批准执行；精确ZIP与当时状态需另行确认。
新runtime manifest ae68762a…bb10b54，plan60896844…246fff，银行af893b43…1c939a8。

- 既有flat为基线，新候选仅替换连续面板生成；两条FPGA路径同原flat驱动、D075/MODE11/BIT/HWH。
  CPU为固定ARM OpenBLAS0.3.28、2线程，不使用PC INT64夹具。
- 256³/512³各按baseline/new/cpu/cpu/new/baseline，共12块；每块2预热+4正式，
  72总=24预热+48正式，每后端每尺寸8正式；ID42/43交替，不能按结果追加或改顺序。
- 每次全量数值/记录/计数检查；每块固定local_index2代表输出+首错输出有界保留。
  输出、失败、慢点全部留存，不删除或只报告有利窗口。
- FPGA完整Call与CPU固定包装调用计时；外部oracle/IPC/进程启动/初始化/落盘/清理不计入请求。
  DMA+PL为嵌套窗口，不作纯阵列时延，不跨层相除。
- 先看正确性和实际退出/组消失/同inode清理；均值主报并列median/min/max与前后块均值。
  不用历史172ms当阈值，不签核P95/跨日稳定、不以功能通过晋升默认。
- 构造期间停止可在原Owner门禁阻止提交；进入run_chain后完成当前请求再停止。
  不强杀、不自动重跑；状态不明留原supervisor/锁/缓冲现场，不删锁/重启掩盖。
- 不测能量/功率，不录音，不改KWS门限/识别率、RTL/频率/OS/供电/默认。
  不从旧flat的10.76%或PC夹具时间预告本次连续面板收益。

离线审查已完成新runtime370方法与PC协调/留存检查；FPGA夹具预填黄金，
不代表新候选已在硬件跑过。真实ARM结果仍未知。
