cpfbx/OpenNPU-Lite-FPGA/report/figures/fig03_storage_schedule.pdf

(a) 满 64 × 64 面板：组索引 g → K 索引 k → lane ℓ
a0 | a1 | a2 | a3 | a4 | a5 | a6 | a7 | 每拍 64 bit，含 8 个 INT8 数值
A[g 512 + k 8 + ℓ] = A[8g + ℓ, k] | B[g 512 + k 8 + ℓ] = B[k, 8g + ℓ]

输入流按 A 面板、B 面板顺序传输；ℓ ∈ {0, . . . , 7}

(b) 同一 job 内的输入预取

64 位输入流; 当前存储半区 K 面板 t; 另一存储半区 预取 K 面板 t + 1; 在面板边界切换

(c) C-bank 状态与并行关系
FREE | COMPUTING | READY | DRAINING
| 输出末拍握手后释放
计算与回传可在不同 C-bank 上重叠，调度器按空闲状态分配。
