cpfbx/OpenNPU-Lite-FPGA/report/figures/fig04_resources.pdf

0 | 50 | 100
| 器件资源占用 (%)

D007-P

D075

24,289 (45.66%)

26,762 (50.30%)

(a) LUT
0 | 50 | 100
| 器件资源占用 (%)

D007-P

D075

25,050 (23.54%)

27,575 (25.92%)

(b) FF
0 | 50 | 100
| 器件资源占用 (%)

D007-P

D075

7 (5.00%)

11 (7.86%)

(c) BRAM Tile
0 | 5 | 10

D007-P

D075

局部放大：0–10%

0 | 50 | 100
| 器件资源占用 (%)

D007-P

D075

72 (32.73%)

72 (32.73%)

(d) DSP
