cpfbx/OpenNPU-Lite-FPGA/report/figures/fig05_complete_request.pdf

0 | 20 | 40 | 60 | 80
| | 完整请求耗时 (ms)

旧构帧

flat构帧

OpenBLAS 2T

57.30

57.69

25.16

(a) 2026-10-21, 256

3

0 | 20 | 40 | 60 | 80
| | 完整请求耗时 (ms)

flat基线

连续面板

OpenBLAS 2T

58.73

52.67

25.34

(b) 2026-10-22, 256

3

0 | 100 | 200 | 300
完整请求耗时 (ms)

旧构帧

flat构帧

OpenBLAS 2T

272.11

242.82

172.24

(c) 2026-10-21, 512

3

0 | 100 | 200 | 300
完整请求耗时 (ms)

flat基线

连续面板

OpenBLAS 2T

266.98

241.51

171.55

(d) 2026-10-22, 512

3
