cpfbx/OpenNPU-Lite-FPGA/report/figures/fig06_request_stages.pdf

0 | 100 | 200 | 300
完整请求耗时 (ms)

旧构帧

flat构帧

78.0 | 140.0 | 272.11
78.2 | 111.5 | 242.82
(a) 2026-10-21
0 | 100 | 200 | 300
完整请求耗时 (ms)

flat基线

连续面板

95.5 | 112.8 | 266.98
71.1 | 111.7 | 241.51
(b) 2026-10-22
条件 | 事务构造 | 受控提交 | 记录重建 | 输出拆包 | 未归类残差 | 合计
10/21 旧构帧 | 77.95 | 139.97 | 31.47 | 18.62 | 4.09 | 272.11
10/21 flat构帧 | 78.16 | 111.55 | 31.69 | 17.40 | 4.02 | 242.82
10/22 flat基线 | 95.45 | 112.83 | 32.18 | 19.13 | 7.38 | 266.98
10/22 连续面板 | 71.13 | 111.72 | 32.09 | 19.22 | 7.35 | 241.51

各阶段均值 (ms)，显示值四舍五入。

事务构造
受控提交

记录重建
输出拆包

未归类残差
