cpfbx/OpenNPU-Lite-FPGA/report/figures/fig07_energy_abba.pdf

A1
CPU 2T

B1
FPGA

B2
FPGA

A2
CPU 2T

0

100

200

300

保存包络能量 (J)

261.12 | 257.92 | 260.04 | 264.27
(a) Wh端点差折算
−6 | −4 | −2 | 0
| | 均值能量差 (J)

−3.7152 J (−1.4143%)

(c) ABBA均值：FPGA − CPU

A1
CPU 2T

B1
FPGA

B2
FPGA

A2
CPU 2T

0

100

200

300

保存包络能量 (J)

261.04 | 257.90 | 260.04 | 264.25
(b) 功率积分
−6 | −4 | −2 | 0
| | 均值能量差 (J)

−3.6740 J (−1.3989%)

(d) ABBA均值：FPGA − CPU
CPU 2T | FPGA
