cpfbx/OpenNPU-Lite-FPGA/report/figures/fig09_team_workflow.pdf

设计 | 实现 | 测试 | 判断

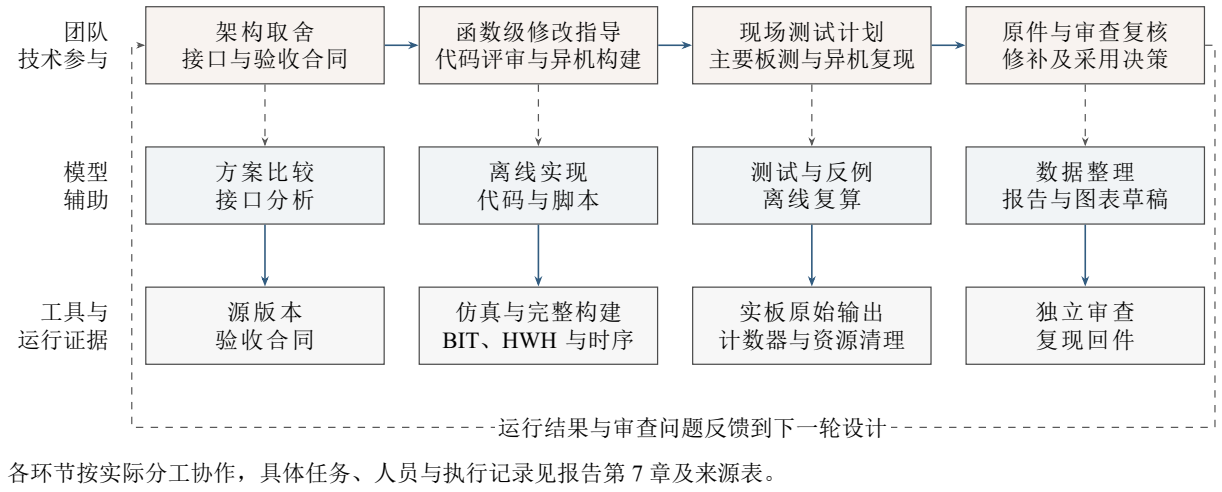
[picture p34: figure]
团队 技术参与; 工具与 运行证据; 架构取舍 接口与验收合同; 函数级修改指导 代码评审与异机构建; 现场测试计划 主要板测与异机复现; 原件与审查复核 修补及采用决策; 方案比较 接口分析; 离线实现 代码与脚本; 测试与反例 离线复算; 数据整理 报告与图表草稿; 源版本 验收合同; 仿真与完整构建 BIT、HWH 与时序; 实板原始输出 计数器与资源清理; 独立审查 复现回件; 运行结果与审查问题反馈到下一轮设计; 各环节按实际分工协作，具体任务、人员与执行记录见报告第 7 章及来源表。
