cpfbx/OpenNPU-Lite-FPGA/report/figures/fig10_software_functions.pdf

run_hybrid_
candidate.py

入口校验 / 显式启用

run_hybrid_session

单会话 / 固定12窗

HybridGraphExecutor

CPU算子调度

结果与回执

文件 / 日志 / 数值核验

Frontend.process

WAV → 49×10 INT8

run_prefix

Op0–1 → tensor23

SharedCall +
depthwise

Op2 → DW3 → Op4

run_suffix

Op5–11 → tensor33

SharedCall

包络 / 一次性准入

SharedOwner
execute_chain

身份 / 根缓冲复用

FlatPackPynqGemm
run_chain

链式任务与布局

PynqGemm
_submit_chain

MMIO / DMA / 计数

(a) 完整PC混合图的调用组织
(b) 每窗函数与张量输入输出
(c) 共享中段的驱动调用层级
