cpfbx/OpenNPU-Lite-FPGA/report/technical_source_index.csv

来源编号 | 技术材料 | 交付方式 | 公开相对路径
E1 | E01 D075完整工程签核 | 按配套工程清单核验
E2 | E02 D006 K-major实板 | 按配套工程清单核验
E3 | E03 D007-A2首K覆写 | 按配套工程清单核验
E4 | E04 D007-P预取配对 | 按配套工程清单核验
E5 | E05 D075跨BIT与MODE11证据边界 | 按配套工程清单核验
E6 | E06 483调用与请求内复用 | 按配套工程清单核验
E7 | E07 320调用优化ARM基线 | 按配套工程清单核验
E8 | E08 native构帧负结果 | 按配套工程清单核验
E9 | E09 10月21日flat同场结果 | 按配套工程清单核验
E10 | E10 10月22日连续面板同场结果 | 按配套工程清单核验
E11 | E11 连续面板独审回件 | 按配套工程清单核验
E12 | E12 最终矩阵候选能量报告 | 按配套工程清单核验
E13 | E13 能量独审收口及勘误 | 按配套工程清单核验
E14 | E14 新旧模型质量独审及勘误 | 按配套工程清单核验
E15 | E15 旧模型单次麦克风原件核对 | 按配套工程清单核验
E16 | E16 ARM CPU420实板报告 | 按配套工程清单核验
E17 | E17 Skill v3 Linux复核与实际使用 | 按配套工程清单核验
E17 | E17索引 | 按配套工程清单核验
E17 | E17补充技术核验 | 按配套工程清单核验
E18 | E18 异机PC复现及构建入口 | 按配套工程清单核验
E18 | E18补充技术核验 | 按配套工程清单核验
E19 | E19 硬件来源端哈希补件 | 按配套工程清单核验
E20 | E20 Op2与Op4单层回件收口 | 按配套工程清单核验
E20 | E20补充技术核验 | 按配套工程清单核验
E21 | E21 共享12窗实板报告 | 按配套工程清单核验
E22 | E22 共享链独审回件及勘误 | 按配套工程清单核验
E22 | E22补充技术核验 | 按配套工程清单核验
E23 | E23 Pointwise真实调用算术 | 按配套工程清单核验
E24 | E24 链格式源码 | 按配套工程清单核验
E25 | E25 旧正文与本次改写关系 | 按配套工程清单核验
E26 | E26 BRAM推断失败记录 | 按配套工程清单核验
E27 | E27 研发协作案例与纠错记录 | 公开整理稿 | evidence/e27.md
E28 | E28 本地2026指南阅读记录与已有参考研究 | 按配套工程清单核验
E29 | E29 cleanup及统一PC入口独审收口 | 按配套工程清单核验
E30 | E30 完整KWS混合图离线验收 | 按配套工程清单核验
E31 | E31 完整混合图身份勘误 | 按配套工程清单核验
E32 | E32 独立标准库全图复算 | 按配套工程清单核验
E33 | E33 737份二进制比对 | 按配套工程清单核验
E34 | E34 KWS本轮收口 | 按配套工程清单核验
E35 | E35 资源、流量和结果来源表 | 按配套工程清单核验
E36 | E36 两份原始资源报告解析 | 按配套工程清单核验
E37 | E37 理论流量与峰值推导 | 按配套工程清单核验
E38 | E38 10月21日原件数值复算 | 按配套工程清单核验
E39 | E39 10月22日原件数值复算 | 按配套工程清单核验
E40 | E40 函数级实现要求与审查记录 | 公开整理稿 | evidence/e40.md
E41 | E41 本轮原生工程图件、固定用例重放与来源 | 公开整理稿 | evidence/e41.md
E42 | 10月31日连续演示与原生软件运行截图 | 原始回执按字节复制；录屏原帧与Word视图裁剪 | evidence/e42.md
E43 | 团队主导的人机协作记录 | 三例提示词按实际交互编辑归并；9段模型答复保留原文；3段团队原始要求及索引另存核对 | evidence/e43.md
