cpfbx/OpenNPU-Lite-FPGA/report/figures/fig04_resources.png

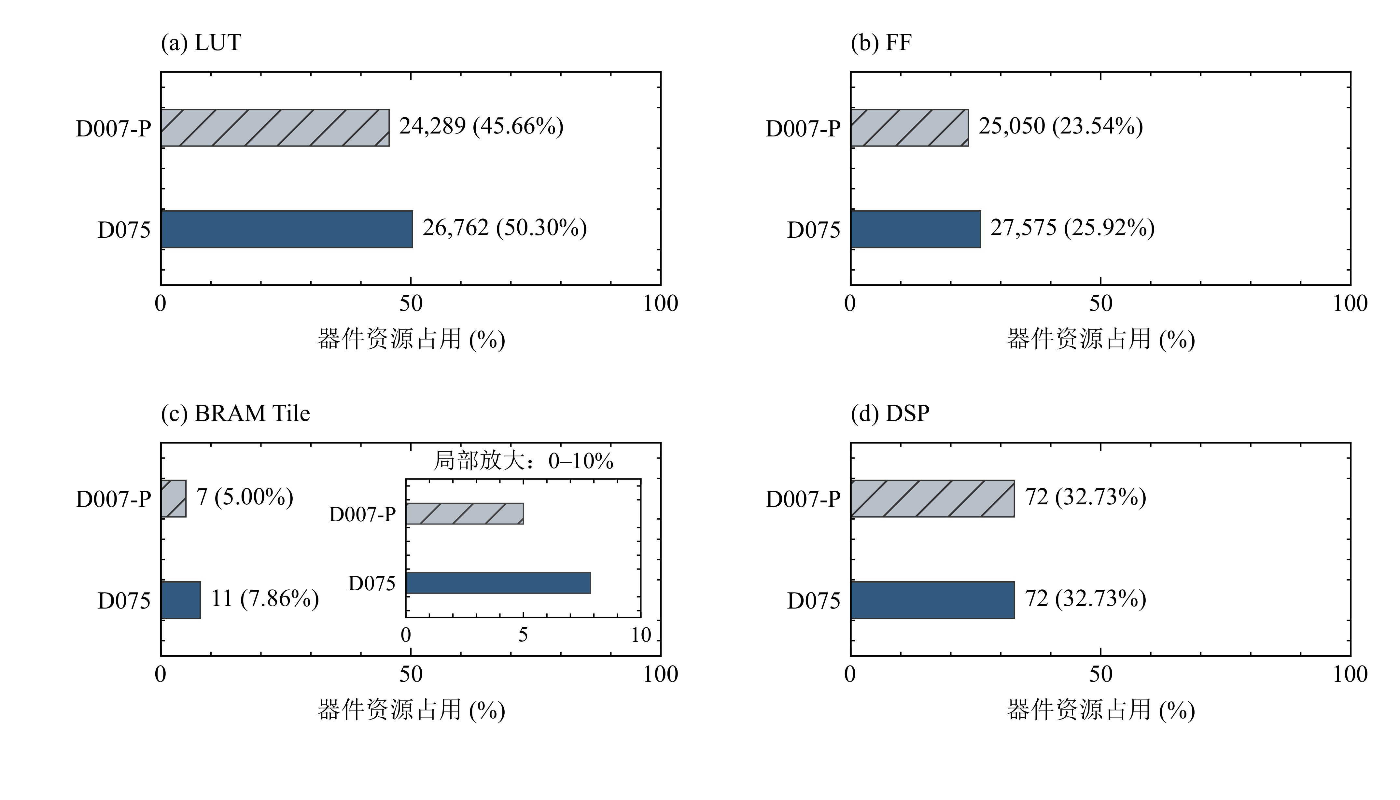
report/figures/fig04_resources.png
