cpfbx/OpenNPU-Lite-FPGA/report/native_assets/vivado_pe_multiplier_neighbourhood_20261030_01.png

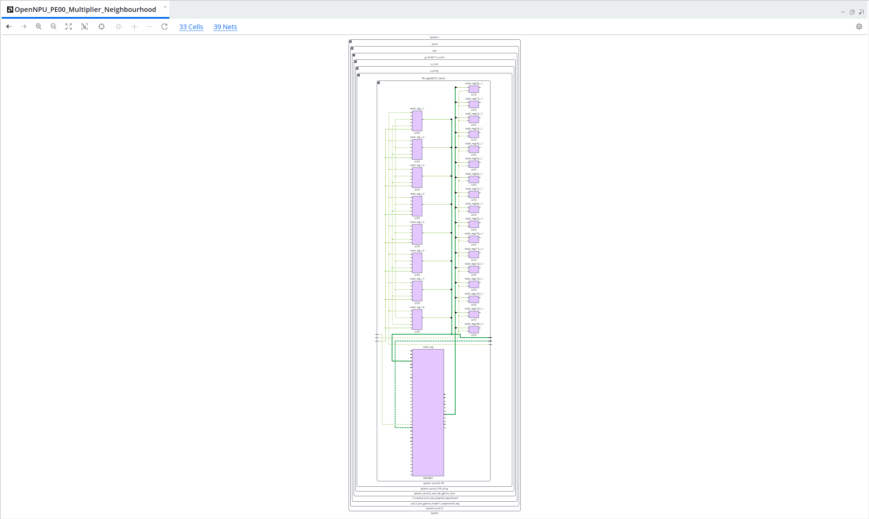
report/native_assets/vivado_pe_multiplier_neighbourhood_20261030_01.png
