cpfbx/OpenNPU-Lite-FPGA/report/native_assets/vivado_system_block_design_20261030_01.png

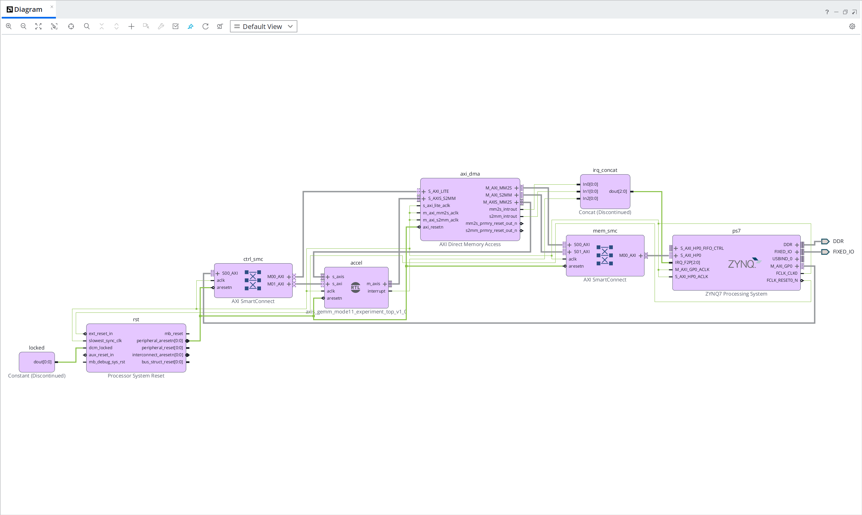
report/native_assets/vivado_system_block_design_20261030_01.png
