cpfbx/OpenNPU-Lite-FPGA/report/development_results.md

# 从供数优化到共享应用：完整研发结果

OpenNPU-Lite 的优化经历了三个层次：先让有限阵列连续工作，再降低主机组织成本，最后把矩阵返回值接入真实的 PS/PL 应用链。下表按解决的问题展开，各行保留自己的版本、对照和计时边界。

## 1 硬件数据流逐步形成

| 阶段 | 解决的问题与实现 | 对应实测 | 来源 |
|---|---|---|---|
| 可编程计算基础 | 8×8物理阵列分时承担64×64逻辑块，跨K面板累加；运行时配置M、N、K及尾块 | D075完整实现100 MHz；26,762 LUT、27,575 FF、11 BRAM Tile、72 DSP，setup/hold收敛 | [E01](evidence/e01.md)、[原生波形](../sim/results/native_20261030/readme.md) |
| K-major供数 | 按阵列消费次序排列输入，缩短接收与供数串行等待 | 同BIT MODE3→MODE5，512³ DMA+PL：106.6868→63.9716 ms；接收计数4,790,400→530,560 cycles | [E02](evidence/e02.md) |
| 首K面板覆写 | 第一面板直接建立部分和，去掉独立清零阶段 | 512³总周期4,239,808→3,977,664，减少262,144 cycles；配对DMA+PL约减少2.601 ms | [E03](evidence/e03.md) |
| 输入预取 | 当前面板计算期间准备下一面板 | 512³总周期3,977,664→3,518,464，减少459,200 cycles；配对DMA+PL约减少4.552 ms | [E04](evidence/e04.md) |
| 双C-bank及MODE11 | 计算写入与另一银行结果排出重叠 | 同BIT MODE10→MODE11，20对512³ DMA+PL：36.221124→31.261776 ms | [E05](evidence/e05.md) |

D075的512³纯PL窗口为30.044830 ms，按134,217,728 MAC计算得到 **4.467249 GMAC/s**。这是整个计算窗口的有效吞吐；同类DMA+PL窗口为4.293349 GMAC/s。64个PE、100 MHz对应6.4 GMAC/s理论峰值，两者之比69.80%用于评价窗口效率。[E05](evidence/e05.md)

## 2 主机优化改变完整请求

硬件窗口降到约31 ms后，主机仍要准备面板、构造任务、检查返回并重建矩阵。优化因此从阵列转向请求路径。

| 实验 | 同场FPGA基线→候选，512³ | 同场CPU对照及判断 |
|---|---|---|
| 请求内面板与不可变布局复用 | **714.535→284.216 ms，减少60.22%**；事务生成516.809→90.226 ms，DMA+PL约31.018→31.079 ms | 当时FP32 NumPy入口438.780 ms。483次调用覆盖7种形状，各后端/形状20组正式输入；改进来自主机组织。[E06](evidence/e06.md) |
| 优化CPU基线复核 | 缓存FPGA279.358 ms | 同场NumPy436.841、OpenBLAS单线程298.523、双线程166.178 ms。更强CPU基线明确了完整请求仍需优化。[E07](evidence/e07.md) |
| 原生构帧候选取舍 | 283.486→416.921 ms，**增加47.07%** | 功能核验通过，7种形状首次完整调用均变慢；停止后续正式长测，保留原因分析。[E08](evidence/e08.md) |
| 10/21 old→flat | 272.112642→242.822112 ms，减少10.76% | 双线程OpenBLAS172.240538 ms；256³候选增加0.69%。这里的old已包含前期硬件和请求内复用。[E09](evidence/e09.md) |
| 10/22 flat→连续面板 | 266.977108→241.509612 ms，减少9.54% | 双线程OpenBLAS171.554654 ms；256³减少10.32%。本场flat基线与10/21独立测量。[E10](evidence/e10.md) |
| 10/31连续拍摄复现 | 261.115337→238.187774 ms，减少8.78% | 双线程OpenBLAS166.294665 ms；256³减少10.17%。矩阵72次调用后顺序完成共享12窗，两段退出0。[E42](evidence/e42.md) |

这些百分比只用于各自同场对照。它们回答不同阶段的问题，不组成一条可连乘的加速曲线。三场后期矩阵实验的256³、512³及CPU均值完整列于下表；`n=8`指每个尺寸、每个后端的正式样本数。

| 场次 | 尺寸 | 基线 ms | 候选 ms | 同场双线程OpenBLAS ms | 请求变化 |
|---|---:|---:|---:|---:|---:|
| 10/21 | 256³ | 57.296271 | 57.692782 | 25.163401 | +0.69% |
| 10/21 | 512³ | 272.112642 | 242.822112 | 172.240538 | −10.76% |
| 10/22 | 256³ | 58.732557 | 52.671871 | 25.341814 | −10.32% |
| 10/22 | 512³ | 266.977108 | 241.509612 | 171.554654 | −9.54% |
| 10/31复现 | 256³ | 57.601184 | 51.741561 | 25.073477 | −10.17% |
| 10/31复现 | 512³ | 261.115337 | 238.187774 | 166.294665 | −8.78% |

10/21和10/22图表数据见[完整请求CSV](figure_data/complete_request.csv)，阶段总览的单位和来源见[研发里程碑CSV](figure_data/development_milestones.csv)。完整FPGA请求仍慢于这些场次的双线程OpenBLAS；阵列吞吐与系统响应时间分别评价。

## 3 从单算子到动态KWS链路

| 推进阶段 | 动态计算与完成结果 | 证据 |
|---|---|---|
| 前处理与ARM CPU420 | 修正前处理差异后，ARM从公共WAV计算205,800个特征、5,040个logits，与PC参考逐字节一致 | [E16](evidence/e16.md) |
| Pointwise单层映射 | Op2、Op4分别完成固定12窗实板返回和raw/校正/INT8全值回读；为跨层接线建立算子/窗口身份合同 | [E20](evidence/e20_op4.md) |
| 离线动态组合与共享会话 | 将Op2实际输出送入CPU depthwise3，再封装动态tensor25交给Op4；逐步统一资源、一次性作业准入及父子进程生命周期 | [共享实现与实板报告](evidence/e21.md)、[完整设计报告](design_report.pdf)第6章 |
| **真实共享12窗中段** | 一次资源会话执行24次Pointwise调用、48 jobs（ID1..48）、12次ARM DW3；12,288,000 Pointwise MAC与864,000 DW3逻辑MAC；八类768,000个检查点零差异，正常退出并释放原锁 | [原始返回归档](../board/originals/shared12_evidence.tar.gz)、[E21](evidence/e21.md) |
| **完整PC混合图** | 公共WAV→动态特征→CPU前缀→共享计算接口→CPU后缀→INT8 logits及门控；固定12窗5,880个特征、144个logits一致；标准库865,680个标量复算、737份二进制一致 | [E30](evidence/e30.md)、[运行入口](../reproduction_guide.md#4-完整-kws-离线计算) |

真实共享中段覆盖Op2→ARM DW3→Op4，完整图采用PC硬件夹具。420窗分类与动作门控使用独立固定集评价，完整图尚未完成实板部署及实时音频验收。完整PC图中的VAD来自绑定PCM的历史标记。两类执行环境在[计算图](figures/fig08_kws_graph.png)和报告中分别标明。

## 4 工程验证与能量观察

工程成果包括整数参考、wire逆解码、计数守恒、首错保留、进程监督、正常释放核验、完整实现及时序报告，以及异机构建与可复用验证Skill。历史MODE11长稳记录为1,800.008108 s、8,302对运行，对应当时版本和入口；固定12窗共享链另核正常生命周期。[E05](evidence/e05.md)、[构建资料](../build/readme.md)、[三个Skill](../skill/README.md)

能量诊断采用单组ABBA四窗、每窗452次正式调用。完整保存包络的Wh端点均值差为−1.4143%，同源功率积分差为−1.3989%；同场FPGA请求比双线程CPU更慢，进程CPU时间则减少。四窗原值、采集单位问题及重复测量条件集中列于设计报告第5章和[E12](evidence/e12.md)、[E13](evidence/e13.md)。该观察用于呈现延迟、处理器占用与供电能量的取舍。

## 5 继续查阅与复现

- [详细设计报告](design_report.pdf)：完整原理、各阶段实验及取舍。
- [证据导航](evidence/readme.md)：E编号与历史相对路径的使用方式。
- [从下载开始复现](../reproduction_guide.md)：文件核验、PC计算、RTL、构建与板端准备。

本页为既有实测和离线验收的公开索引；更新了展示方式，未新增性能测量或改变执行代码。
