cpfbx/OpenNPU-Lite-FPGA/report/figures/fig02_array_tiling.pdf

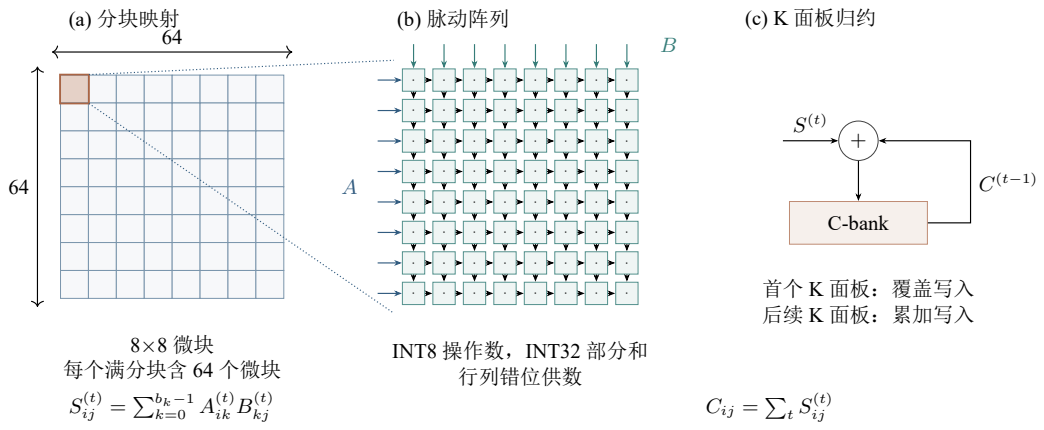
[picture p38: page 1]
(a) 分块映射; (b) 脉动阵列; (c) K 面板归约; 8×8 微块 每个满分块含 64 个微块; INT8 操作数，INT32 部分和 行列错位供数; C-bank; 首个 K 面板：覆盖写入 后续 K 面板：累加写入; Cij =
