cpfbx/OpenNPU-Lite-FPGA/report/native_assets/vivado_pe_multiplier_neighbourhood_20261030_01.pdf

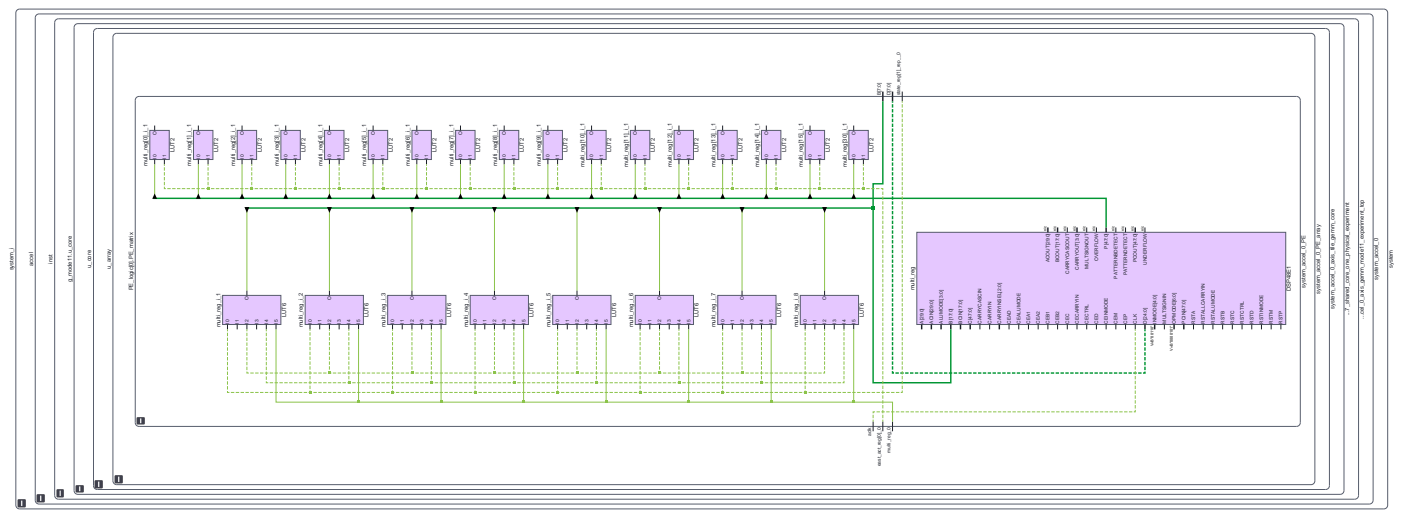
[picture p39: page 1]
system_i; system; accel; system_accel_0; inst; ...cel_0_axis_gemm_mode11_experiment_top; g_mode11.u_core; ...7_shared_core_one_physical_experiment; u_core; system_accel_0_axis_tile_gemm_core; u_array; system_accel_0_PE_array; PE_logic[0].PE_matrix; system_accel_0_PE; aclk east_act_reg[0]_0 multi_reg_0; state_reg[1]_rep__0 multi_reg; DSP48E1; CARRYCASCOUT; MULTSIGNOUT; n/c OVERFLOW; PATTERNBDETECT; PATTERNDETECT; UNDERFLOW; CARRYCASCIN; CARRYIN; CEAD; CEALUMODE CEA1 CEA2 CEB1 CEB2 CEC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

A[29:0] ACIN[29:0] ALUMODE[3:0] B[17:0] BCIN[17:0] C[47:0]

RSTALUMODE RSTB RSTC
