cpfbx/OpenNPU-Lite-FPGA/report/native_assets/vivado_system_block_design_20261030_01.pdf

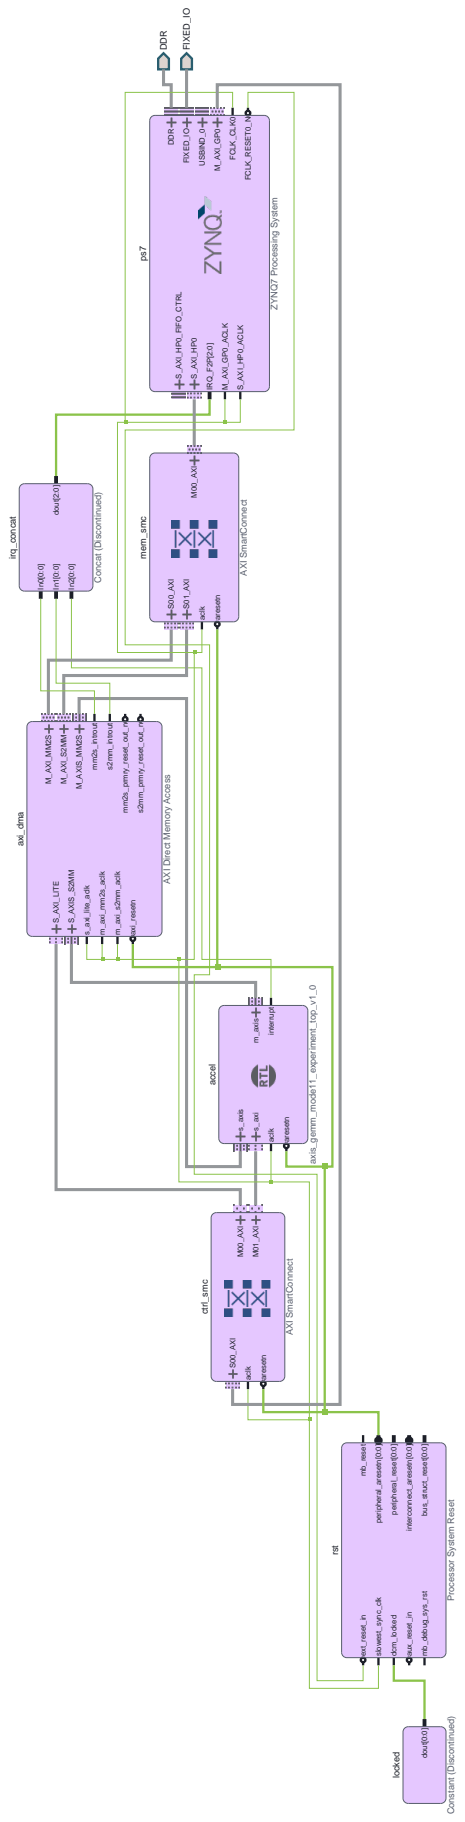
[picture p40: page 1]
locked; Constant (Discontinued); dout[0:0]; rst; ext_reset_in; slowest_sync_clk; dcm_locked; aux_reset_in mb_debug_sys_rst; mb_reset; peripheral_reset[0:0]; bus_struct_reset[0:0]; interconnect_aresetn[0:0]; peripheral_aresetn[0:0]; ctrl_smc; AXI SmartConnect; S00_AXI M00_AXI M01_AXI; aclk; aresetn; accel; axis_gemm_mode11_experiment_top_v1_0; m_axis; s_axis; s_axi; interrupt; axi_dma; S_AXI_LITE M_AXI_MM2S M_AXI_S2MM; M_AXIS_MM2S; S_AXIS_S2MM; s_axi_lite_aclk m_axi_mm2s_aclk m_axi_s2mm_aclk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

AXI Direct Memory Access

Processor System Reset
