cpfbx/OpenNPU-Lite-FPGA/sim/d075/tb/tb_axi_lite_regs.sv

`timescale 1ns / 1ps

module tb_axi_lite_regs;
    reg clk = 1'b0;
    reg resetn = 1'b0;
    always #5 clk = ~clk;

    reg [8:0] awaddr = 0;
    reg awvalid = 0;
    wire awready;
    reg [31:0] wdata = 0;
    reg [3:0] wstrb = 0;
    reg wvalid = 0;
    wire wready;
    wire [1:0] bresp;
    wire bvalid;
    reg bready = 1;
    reg [8:0] araddr = 0;
    reg arvalid = 0;
    wire arready;
    wire [31:0] rdata;
    wire [1:0] rresp;
    wire rvalid;
    reg rready = 1;

    reg core_idle = 1;
    reg core_busy = 0;
    reg core_done = 0;
    reg core_error = 0;
    reg core_input_wait = 0;
    reg core_output_wait = 0;
    reg [31:0] error_code = 0;
    reg [63:0] total_cycles = 64'h0123_4567_89AB_CDEF;
    reg [63:0] compute_cycles = 64'h1020_3040_5060_7080;
    reg [31:0] input_stall_cycles = 32'h1111_2222;
    reg [31:0] output_stall_cycles = 32'h3333_4444;
    reg [63:0] effective_macs = 64'hA1A2_A3A4_B1B2_B3B4;
    reg [63:0] receive_parse_cycles = 64'h0102_0304_0506_0708;
    reg [63:0] clear_c_cycles = 64'h1112_1314_1516_1718;
    reg [63:0] array_phase_cycles = 64'h2122_2324_2526_2728;
    reg [63:0] store_c_cycles = 64'h3132_3334_3536_3738;
    reg [63:0] output_drain_cycles = 64'h4142_4344_4546_4748;
    reg [63:0] transition_cycles = 64'h5152_5354_5556_5758;
    reg [31:0] failed_tile_index = 32'h0000_0017;
    reg [31:0] chain_jobs_completed = 32'h0000_0042;
    reg [63:0] d7_load_work = 64'h0101_0101_0202_0202;
    reg [63:0] d7_array_work = 64'h0303_0303_0404_0404;
    reg [63:0] d7_store_work = 64'h0505_0505_0606_0606;
    reg [63:0] d7_output_work = 64'h0707_0707_0808_0808;
    reg [63:0] d7_work_union = 64'h0909_0909_0A0A_0A0A;
    reg [63:0] d7_overlap = 64'h0B0B_0B0B_0C0C_0C0C;
    reg [63:0] d7_no_work = 64'h0D0D_0D0D_0E0E_0E0E;
    reg [63:0] d7_load_stall = 64'h1111_1111_1212_1212;
    reg [63:0] d7_array_stall = 64'h1313_1313_1414_1414;
    reg [63:0] d7_store_stall = 64'h1515_1515_1616_1616;
    reg [63:0] d7_output_stall = 64'h1717_1717_1818_1818;
    reg [63:0] d7_load_array = 64'h1919_1919_1A1A_1A1A;
    reg [63:0] d7_array_store = 64'h1B1B_1B1B_1C1C_1C1C;
    reg [63:0] d7_array_wait = 64'h1D1D_1D1D_1E1E_1E1E;
    reg [63:0] d7_bank_wait = 64'h2121_2121_2222_2222;
    reg [63:0] d7_store_wait = 64'h2323_2323_2424_2424;
    reg [63:0] d7_tready_wait = 64'h2525_2525_2626_2626;

    wire start_pulse, soft_reset_pulse, clear_error_pulse;
    wire [31:0] job_id;
    wire [15:0] matrix_m, matrix_n, matrix_k, m_offset, n_offset;
    wire [7:0] block_m, block_n, block_k;
    wire [31:0] mode, scale_mult, scale_shift;
    wire mode_is_chain;
    wire [31:0] expected_in_bytes, expected_out_bytes;

    integer pass_count = 0;
    integer fail_count = 0;
    integer start_count = 0;
    integer soft_reset_count = 0;
    integer clear_error_count = 0;
    reg [31:0] rd_value;

    axi_lite_regs #(
        .BUILD_ID(32'hCAFE_0001),
        .CAPABILITIES(32'h0004_001F)
    ) dut (
        .aclk(clk), .aresetn(resetn),
        .s_axi_awaddr(awaddr), .s_axi_awvalid(awvalid), .s_axi_awready(awready),
        .s_axi_wdata(wdata), .s_axi_wstrb(wstrb), .s_axi_wvalid(wvalid), .s_axi_wready(wready),
        .s_axi_bresp(bresp), .s_axi_bvalid(bvalid), .s_axi_bready(bready),
        .s_axi_araddr(araddr), .s_axi_arvalid(arvalid), .s_axi_arready(arready),
        .s_axi_rdata(rdata), .s_axi_rresp(rresp), .s_axi_rvalid(rvalid), .s_axi_rready(rready),
        .core_idle(core_idle), .core_busy(core_busy), .core_done(core_done),
        .core_error(core_error), .core_input_wait(core_input_wait),
        .core_output_wait(core_output_wait), .error_code_in(error_code),
        .total_cycles(total_cycles), .compute_cycles(compute_cycles),
        .input_stall_cycles(input_stall_cycles), .output_stall_cycles(output_stall_cycles),
        .effective_macs(effective_macs),
        .receive_parse_cycles(receive_parse_cycles),
        .clear_c_cycles(clear_c_cycles), .array_phase_cycles(array_phase_cycles),
        .store_c_cycles(store_c_cycles), .output_drain_cycles(output_drain_cycles),
        .transition_cycles(transition_cycles),
        .failed_tile_index(failed_tile_index),
        .chain_jobs_completed(chain_jobs_completed),
        .d007_load_work_cycles(d7_load_work),
        .d007_array_work_cycles(d7_array_work),
        .d007_store_work_cycles(d7_store_work),
        .d007_output_work_cycles(d7_output_work),
        .d007_work_union_cycles(d7_work_union),
        .d007_overlap_credit_cycles(d7_overlap),
        .d007_no_work_cycles(d7_no_work),
        .d007_load_stall_cycles(d7_load_stall),
        .d007_array_stall_cycles(d7_array_stall),
        .d007_store_stall_cycles(d7_store_stall),
        .d007_output_engine_stall_cycles(d7_output_stall),
        .d007_load_array_overlap_cycles(d7_load_array),
        .d007_array_store_overlap_cycles(d7_array_store),
        .d007_array_wait_result_slot_cycles(d7_array_wait),
        .d007_compute_wait_bank_cycles(d7_bank_wait),
        .d007_store_wait_result_cycles(d7_store_wait),
        .d007_output_wait_tready_cycles(d7_tready_wait),
        .d007_max_result_fifo_occupancy(32'd2),
        .d007_counter_contract_version(32'd1),
        .start_pulse(start_pulse), .soft_reset_pulse(soft_reset_pulse),
        .clear_error_pulse(clear_error_pulse), .job_id(job_id),
        .matrix_m(matrix_m), .matrix_n(matrix_n), .matrix_k(matrix_k),
        .m_offset(m_offset), .n_offset(n_offset),
        .block_m(block_m), .block_n(block_n), .block_k(block_k),
        .mode(mode), .mode_is_chain(mode_is_chain),
        .scale_mult(scale_mult), .scale_shift(scale_shift),
        .expected_in_bytes(expected_in_bytes), .expected_out_bytes(expected_out_bytes)
    );

    always @(posedge clk) begin
        if (start_pulse) start_count <= start_count + 1;
        if (soft_reset_pulse) soft_reset_count <= soft_reset_count + 1;
        if (clear_error_pulse) clear_error_count <= clear_error_count + 1;
    end

    task automatic check32;
        input [31:0] actual;
        input [31:0] expected;
        input [255:0] label;
        begin
            if (actual === expected) begin
                pass_count = pass_count + 1;
                $display("[PASS] %0s = 0x%08x", label, actual);
            end else begin
                fail_count = fail_count + 1;
                $display("[FAIL] %0s actual=0x%08x expected=0x%08x", label, actual, expected);
            end
        end
    endtask

    // order: 0 simultaneous, 1 address first, 2 data first.
    task automatic axi_write;
        input [8:0] address;
        input [31:0] data;
        input [3:0] strobe;
        input integer order;
        begin
            if (order == 1) begin
                @(negedge clk); awaddr = address; awvalid = 1;
                do @(posedge clk); while (!awready);
                @(negedge clk); awvalid = 0;
                @(negedge clk); wdata = data; wstrb = strobe; wvalid = 1;
                do @(posedge clk); while (!wready);
                @(negedge clk); wvalid = 0;
            end else if (order == 2) begin
                @(negedge clk); wdata = data; wstrb = strobe; wvalid = 1;
                do @(posedge clk); while (!wready);
                @(negedge clk); wvalid = 0;
                @(negedge clk); awaddr = address; awvalid = 1;
                do @(posedge clk); while (!awready);
                @(negedge clk); awvalid = 0;
            end else begin
                @(negedge clk);
                awaddr = address; awvalid = 1;
                wdata = data; wstrb = strobe; wvalid = 1;
                do @(posedge clk); while (!(awready && wready));
                @(negedge clk); awvalid = 0; wvalid = 0;
            end
            do @(posedge clk); while (!bvalid);
            check32({30'b0, bresp}, 32'b0, "write response OKAY");
            @(posedge clk);
        end
    endtask

    task automatic axi_read;
        input [8:0] address;
        output [31:0] data;
        begin
            @(negedge clk); araddr = address; arvalid = 1;
            do @(posedge clk); while (!arready);
            @(negedge clk); arvalid = 0;
            do @(posedge clk); while (!rvalid);
            data = rdata;
            check32({30'b0, rresp}, 32'b0, "read response OKAY");
            @(posedge clk);
        end
    endtask

    initial begin
        repeat (4) @(posedge clk);
        resetn = 1;
        repeat (2) @(posedge clk);
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
