cpfbx/OpenNPU-Lite-FPGA/(commit log)

2026-11-03 Publish OpenNPU-Lite competition submission
    [complete_request.csv, energy_abba.csv, hardware_resources.csv, request_stages_512.csv, technical_source_index.csv]
2026-11-03 Present the full optimization and KWS development chain; align both reports
    [development_milestones.csv]
2026-11-04 Synchronize the design-report Markdown with the final PDF and current reproduction inputs
